GeoffreyBultot/MotorTestBench-PBE/CAO/Rendering/PhotosAssemblageBoitier/BoitierAvecComposants/10_CompletOrtho2.JPG

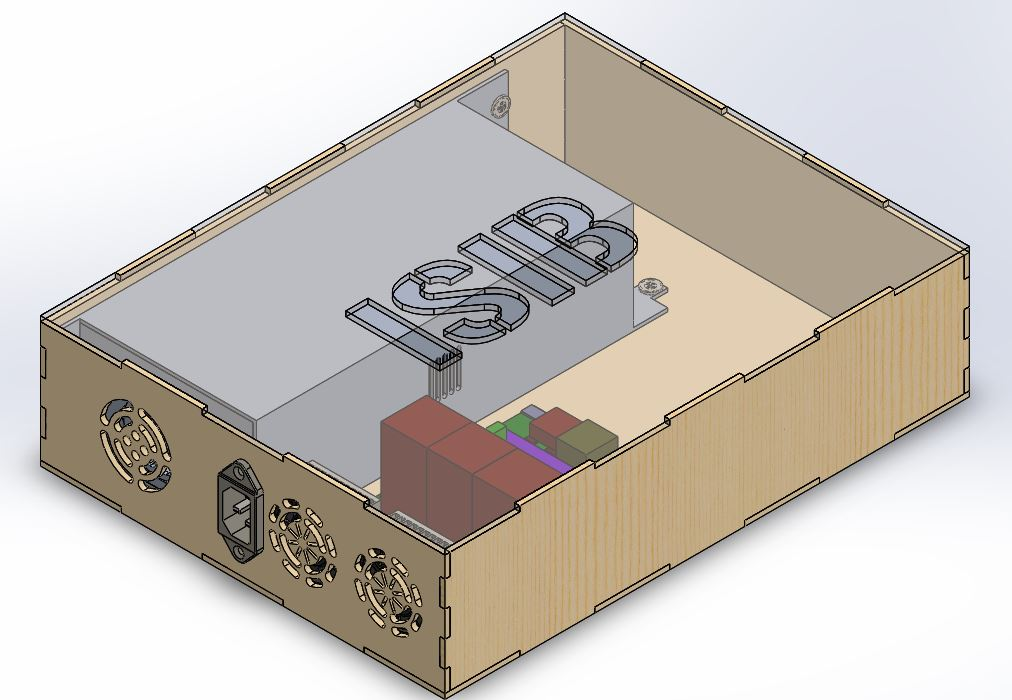
CAO/Rendering/PhotosAssemblageBoitier/BoitierAvecComposants/10_CompletOrtho2.JPG
