GeoffreyBultot/MotorTestBench-PBE/CAO/Rendering/PhotosAssemblageBoitier/BoitierAvecComposants/8_AjoutConnecteur230V.JPG

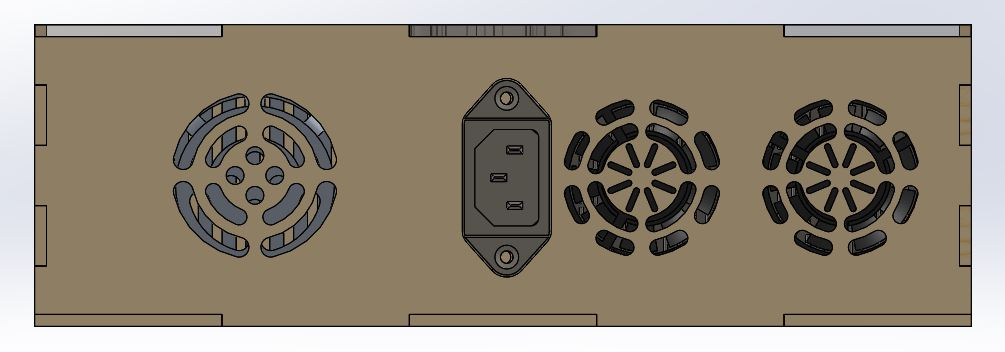
CAO/Rendering/PhotosAssemblageBoitier/BoitierAvecComposants/8_AjoutConnecteur230V.JPG
