GeoffreyBultot/MotorTestBench-PBE/Simulations/Multisim/Alimentation_Moteur/cours_hacheur_serie_tgett.pdf

1

## Cours de Physique appliquée

## Conversion Continu Continu :

## Le hacheur série

### Terminale STI Génie Electrotechnique

### © Fabrice Sincère ; Version 1.1.2

2

Sommaire

1- Symbole général du convertisseur DC / DC

2- Principe du hacheur série (abaisseur de tension)

3- Application : commande de la vitesse d’un moteur à

courant continu à excitation indépendante

4- Ondulation du courant

3

1- Symbole général du convertisseur DC / DC

## continu continu Fig. 1

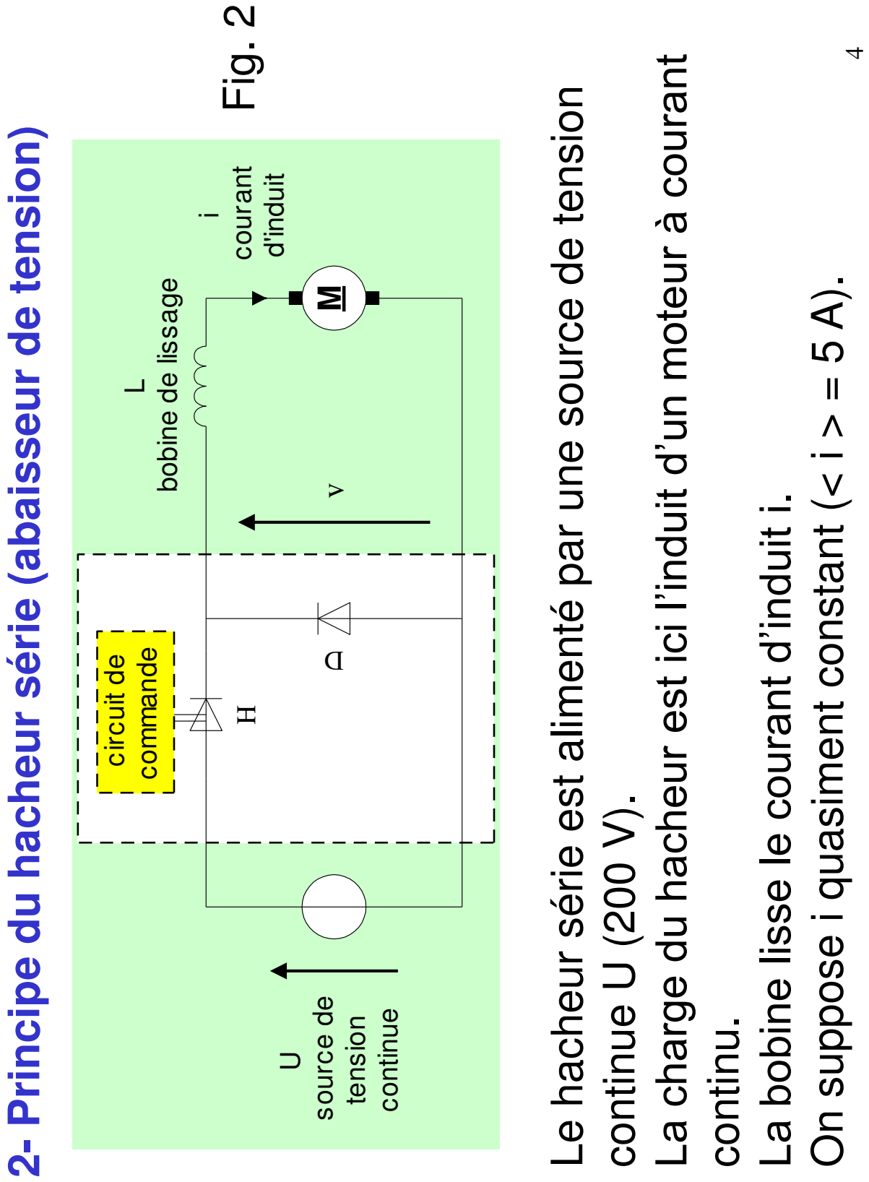
[picture p3: figure]
continue U (200 V).; continu.; La bobine lisse le courant d’induit i.; source de tension; continue; bobine de lissage; courant d'induit; circuit de; commande; Fig. 2

2- Principe du hacheur série (abaisseur de tension)

Le hacheur série est alimenté par une source de tension

La charge du hacheur est ici l’induit d’un moteur à courant

On suppose i quasiment constant (< i > = 5 A).

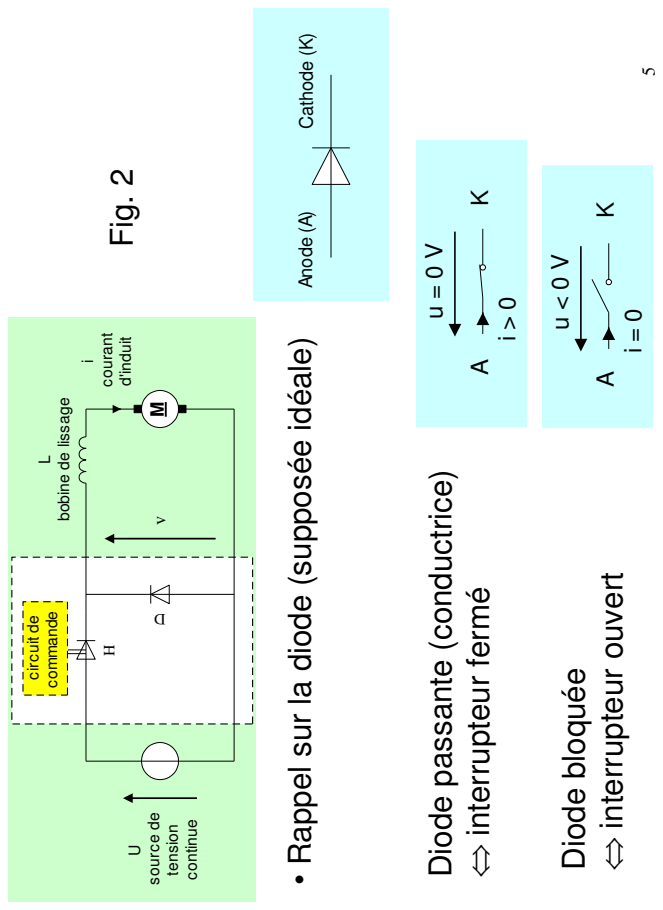
[picture p4: page 5]
source de tension; continue; courant d'induit; circuit de; commande; Fig. 2;  interrupteur fermé; Diode bloquée;  interrupteur ouvert; Anode (A) Cathode (K)

• Rappel sur la diode (supposée idéale)

bobine de lissage

Diode passante (conductrice)

6

- H est un interrupteur électronique :

commandable à la fermeture
commandable à l’ouverture
unidirectionnel en courant

En pratique :

- transistors bipolaires (NPN ou PNP), MOSFET
- thyristors GTO ...

Fig. 3
H

circuit de

commande

circuit de

commande

transistor
NPN

base

collecteur émetteur Fig. 4

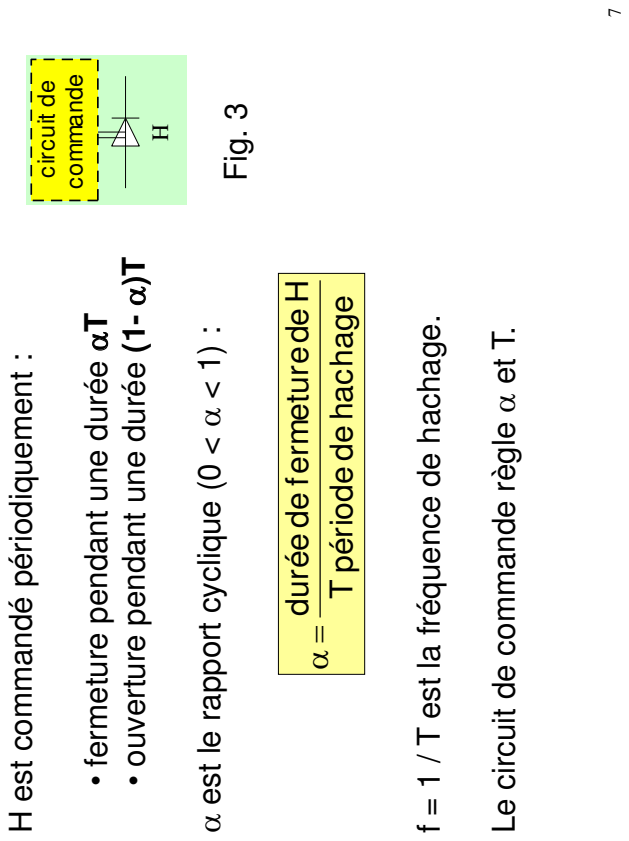
[picture p5: page 7]
circuit de; commande; Fig. 3

• ouverture pendant une durée (1- )T

H de fermeture de durée

hachage de période T

• fermeture pendant une durée T

f = 1 / T est la fréquence de hachage.

 est le rapport cyclique (0 <  < 1) :

Le circuit de commande règle  et T.

H est commandé périodiquement :

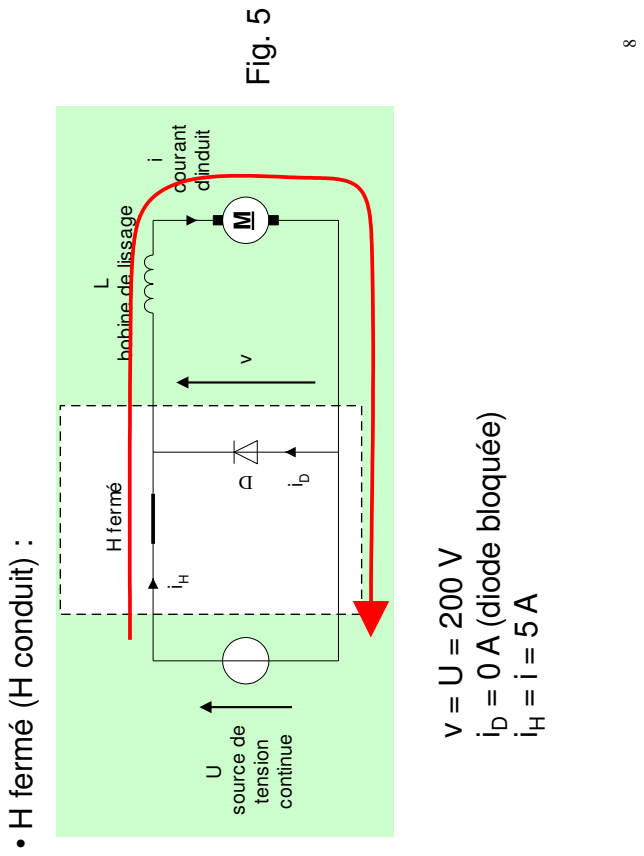
[picture p6: page 8]
• H fermé (H conduit) :; source de tension; continue; courant d'induit; H fermé; Fig. 5 v

bobine de lissage

iD = 0 A (diode bloquée)

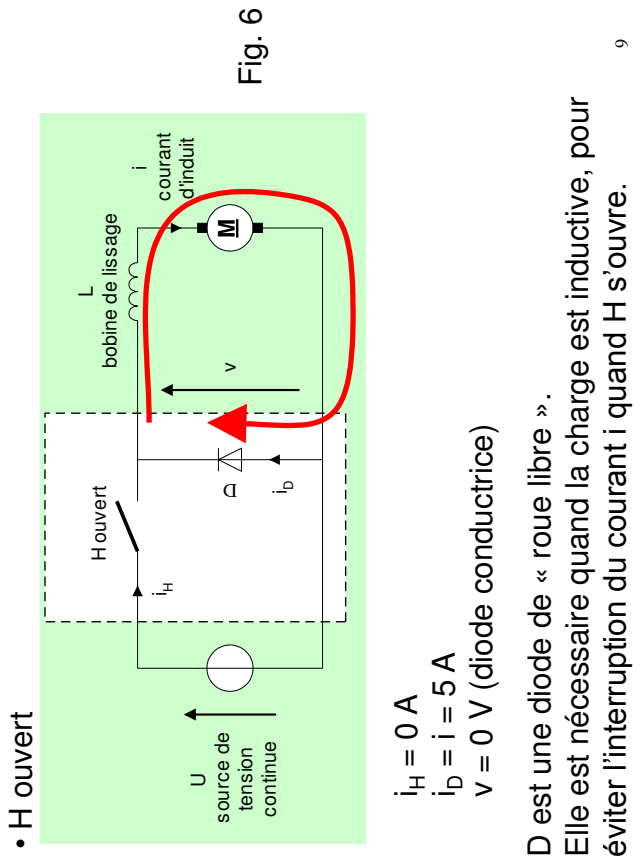
[picture p7: page 9]
• H ouvert; source de tension; continue; courant d'induit; H ouvert; Fig. 6; v = 0 V (diode conductrice)

Elle est nécessaire quand la charge est inductive, pour

éviter l’interruption du courant i quand H s’ouvre.

bobine de lissage

D est une diode de « roue libre ».

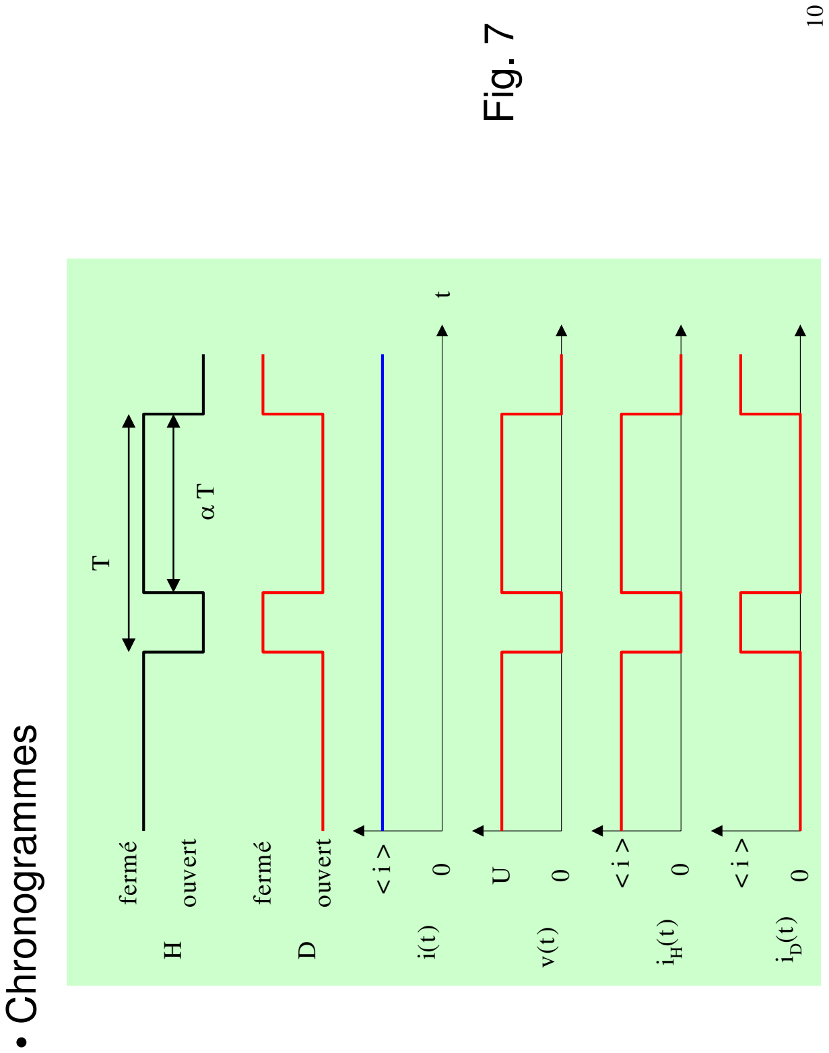
[picture p8: figure]
• Chronogrammes; fermé; ouvert; Fig. 7

11

- Valeurs moyennes

< v > ?

Méthode des aires :
< v > = U

A.N. < v > = 0,75 200 = 150 V

T

UT

T

Aire

v

A.N. Mesurer le rapport cyclique.

= 0,75

12

< iH > = < i >

< iD > = (1 - ) < i >

A.N. < iH > = 0,75 5 = 3,75 A

A.N. < iD > = (1 - 0,75) 5 = 1,25 A

Remarque :

Loi des nœuds : i(t) = iH(t) + iD(t)

< i > = < iH > + < iD >

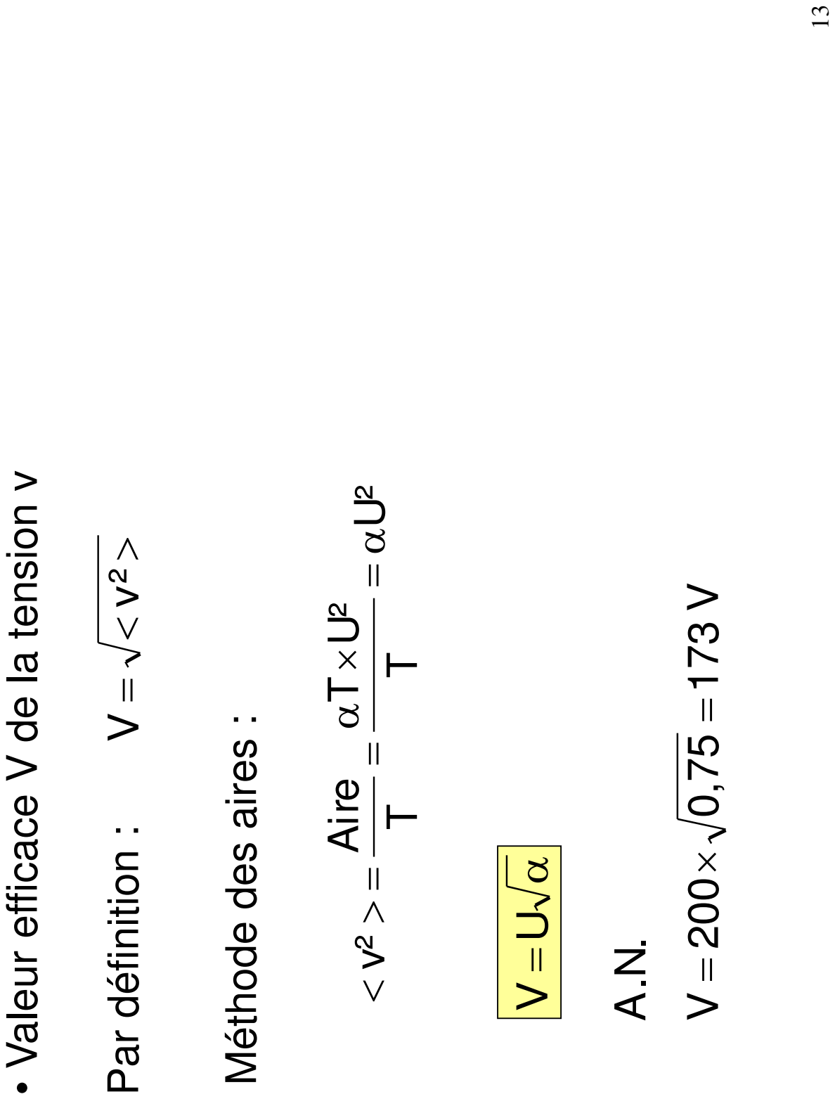
[picture p9: figure]
• Valeur efficace V de la tension v; Par définition :;  v²V; Méthode des aires :; U²T; Aire v²   

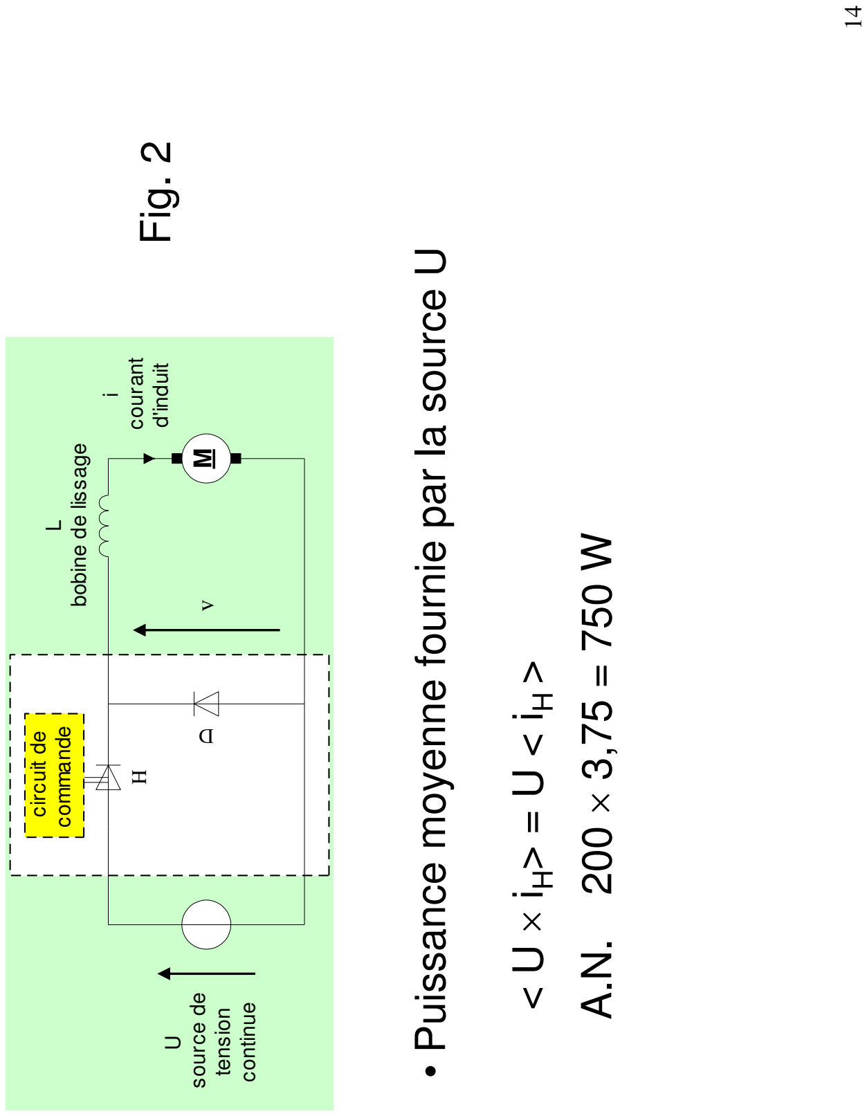
[picture p10: figure]
source de tension; continue; bobine de lissage; courant d'induit; circuit de; commande; Fig. 2

- Puissance moyenne fournie par la source U

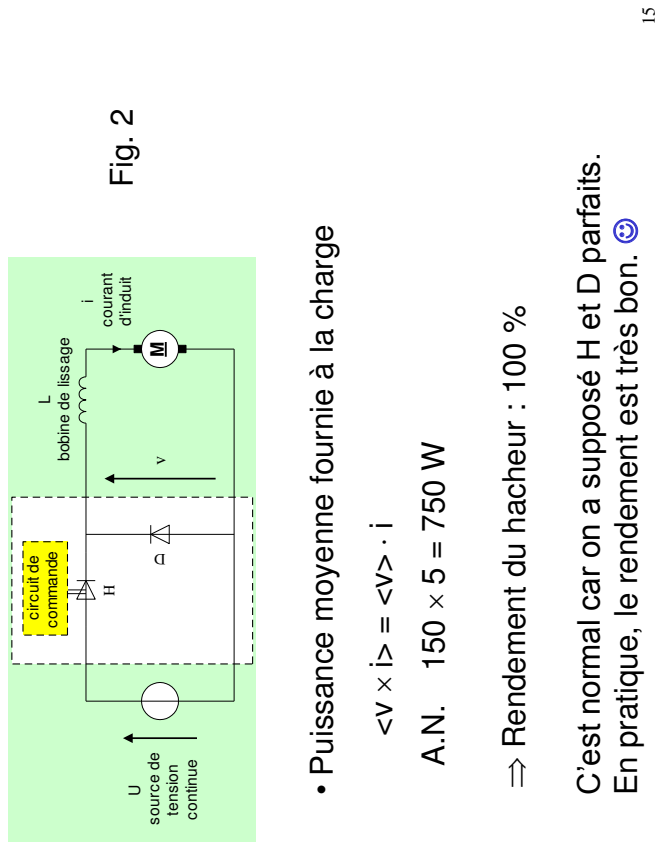
[picture p11: page 15]
source de tension; continue; courant d'induit; circuit de; commande; Fig. 2

C’est normal car on a supposé H et D parfaits.

En pratique, le rendement est très bon. 

• Puissance moyenne fournie à la charge

 Rendement du hacheur : 100 %

bobine de lissage

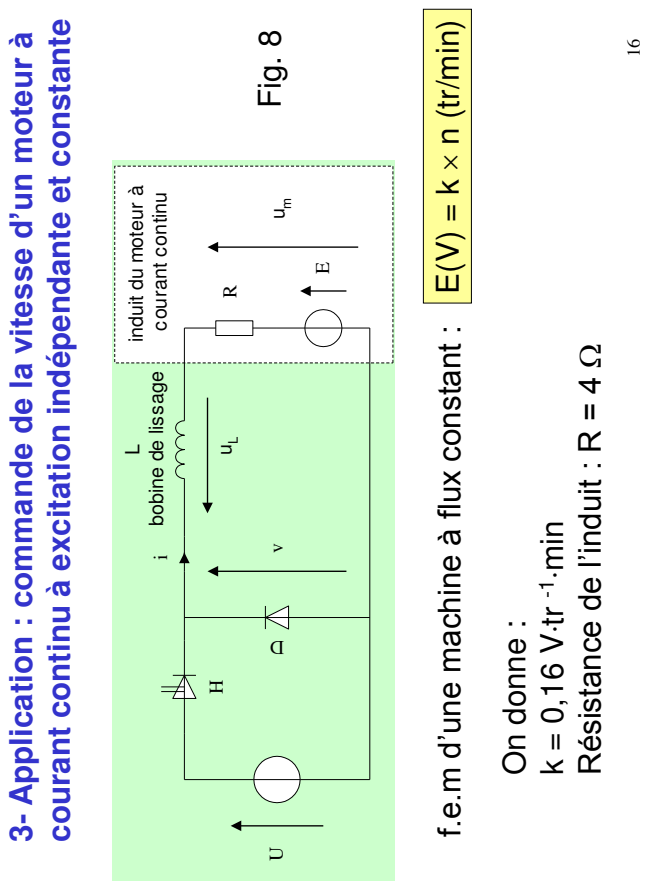
[picture p12: page 16]
courant continu; On donne :; k = 0,16 Vtr -1min; Fig. 8

courant continu à excitation indépendante et constante

f.e.m d’une machine à flux constant : E(V) = k  n (tr/min)

3- Application : commande de la vitesse d’un moteur à

induit du moteur à

Résistance de l’induit : R = 4 

bobine de lissage i

17

La tension moyenne aux bornes d’une bobine pure
parcourue par un courant périodique est nulle :

< um> = < v > = U

(t)u(t)uv(t) mL

mL u u v

A.N. = 0,75

< um> = 0,75 200 = 150 V

## V0 di

dt

L uL

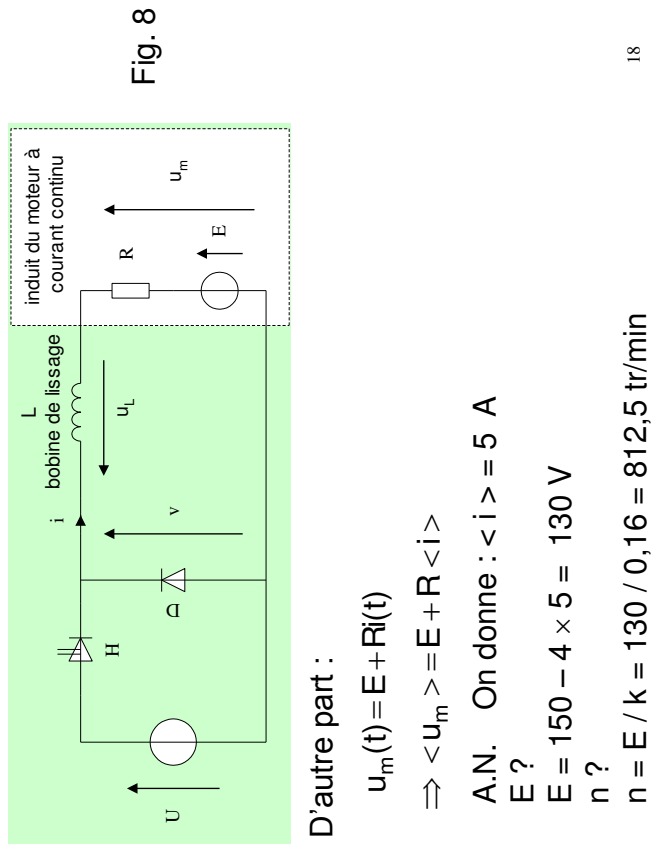
[picture p13: page 18]
A.N. On donne : < i > = 5 A; n = E / k = 130 / 0,16 = 812,5 tr/min; courant continu; uL Fig. 8; D’autre part :

induit du moteur à

bobine de lissage i

19

A.N. Le rapport cyclique est maintenant = 0,5.

Calculer <um>.

En déduire E puis n.

On donne : < i > = 5 A (couple résistant supposé constant)

<um> = U = 0,5 200 = 100 V

E = 100 – 4 5 = 80 V

n ?

n = E / k = 80 / 0,16 = 500 tr/min

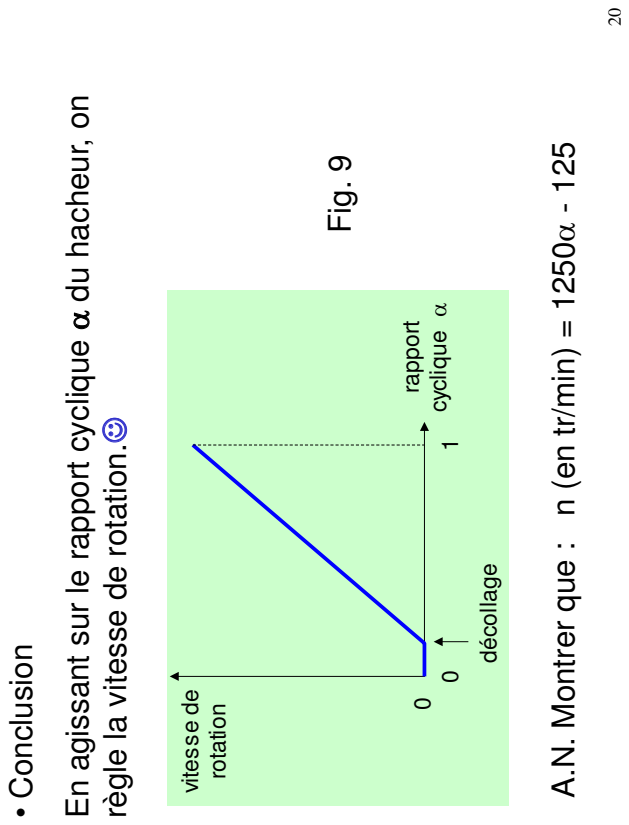
[picture p14: page 20]
• Conclusion; Fig. 9; rapport; cyclique ; vitesse de rotation; décollage

En agissant sur le rapport cyclique  du hacheur, on

A.N. Montrer que : n (en tr/min) = 1250 - 125

règle la vitesse de rotation.

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

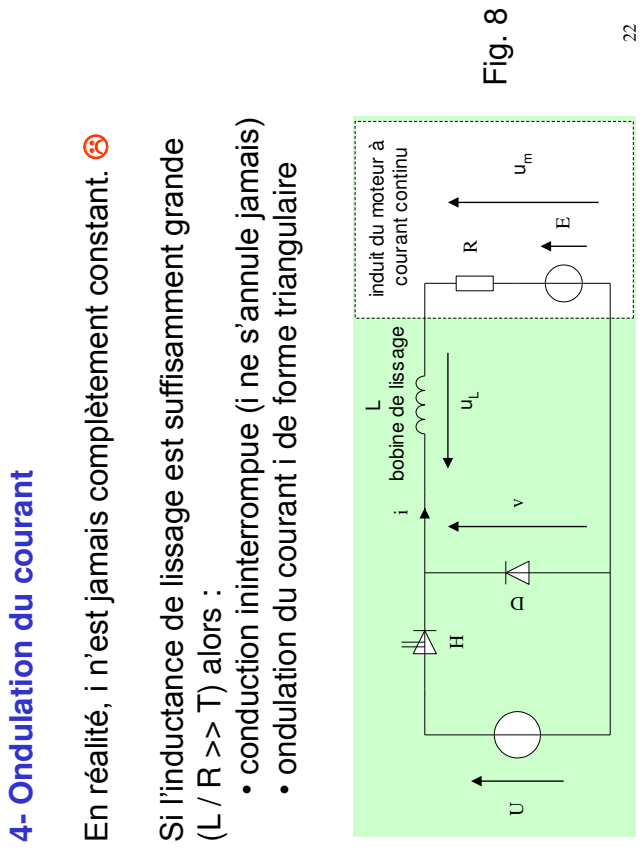
[picture p15: page 22]
(L / R >> T) alors :; courant continu; Fig. 8

• conduction ininterrompue (i ne s’annule jamais)

En réalité, i n’est jamais complètement constant. 

Si l’inductance de lissage est suffisamment grande

induit du moteur à

• ondulation du courant i de forme triangulaire

bobine de lissage i

4- Ondulation du courant

23

- Oscillogrammes

Voie 1 : v(t)

Voie 2 : on utilise une pince ampèremétrique de sensibilité

100 mV/A pour visualiser le courant i(t).

Fig. 10

24

A.N.

Fréquence de hachage ?

Rapport cyclique ?

< v > ?

i max ?
i min ?

Ondulation i ?

< i > ?

ii Δi

ˆ

2

## ii i

T = 1 ms

f = 1 kHz
= 0,4

< v > = 0,4 200 = 80 V

i max = 6 A
i min = 4 A

i = 2 A

< i > = 5 A
Pour un signal triangulaire :

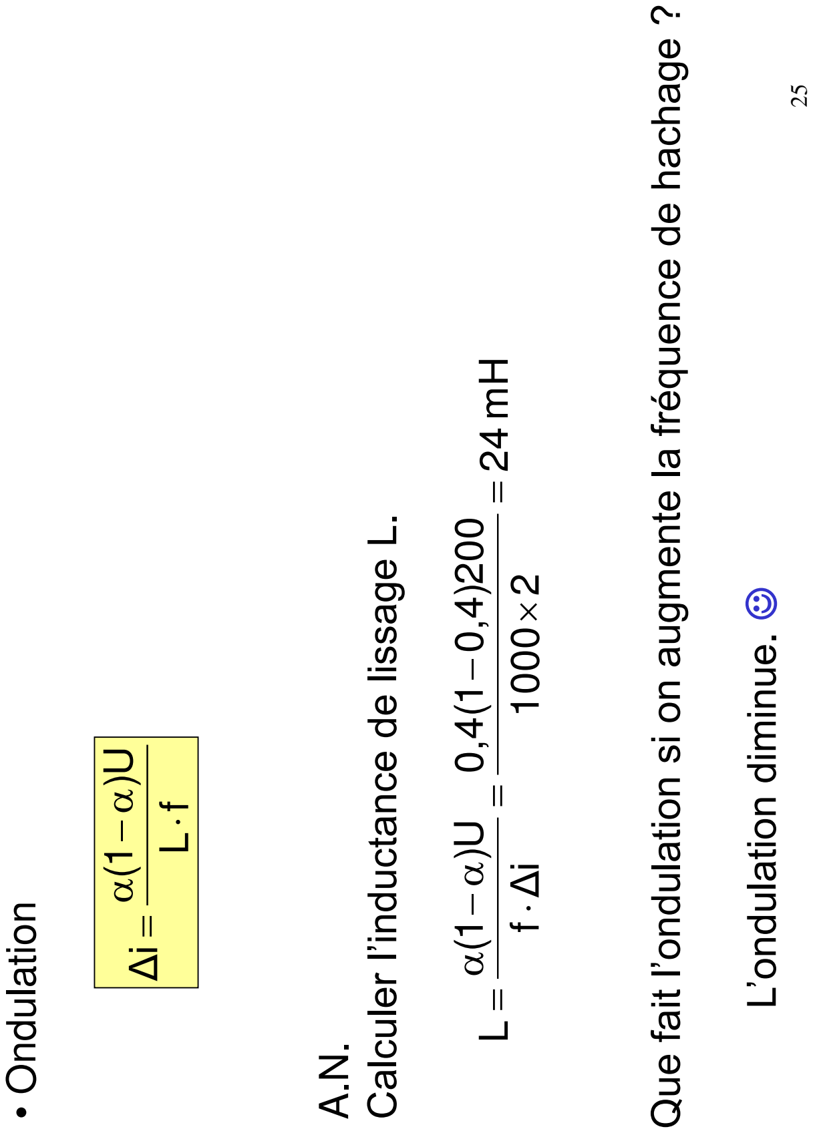
[picture p16: figure]
Calculer l’inductance de lissage L.; L’ondulation diminue. ; • Ondulation

Que fait l’ondulation si on augmente la fréquence de hachage ?

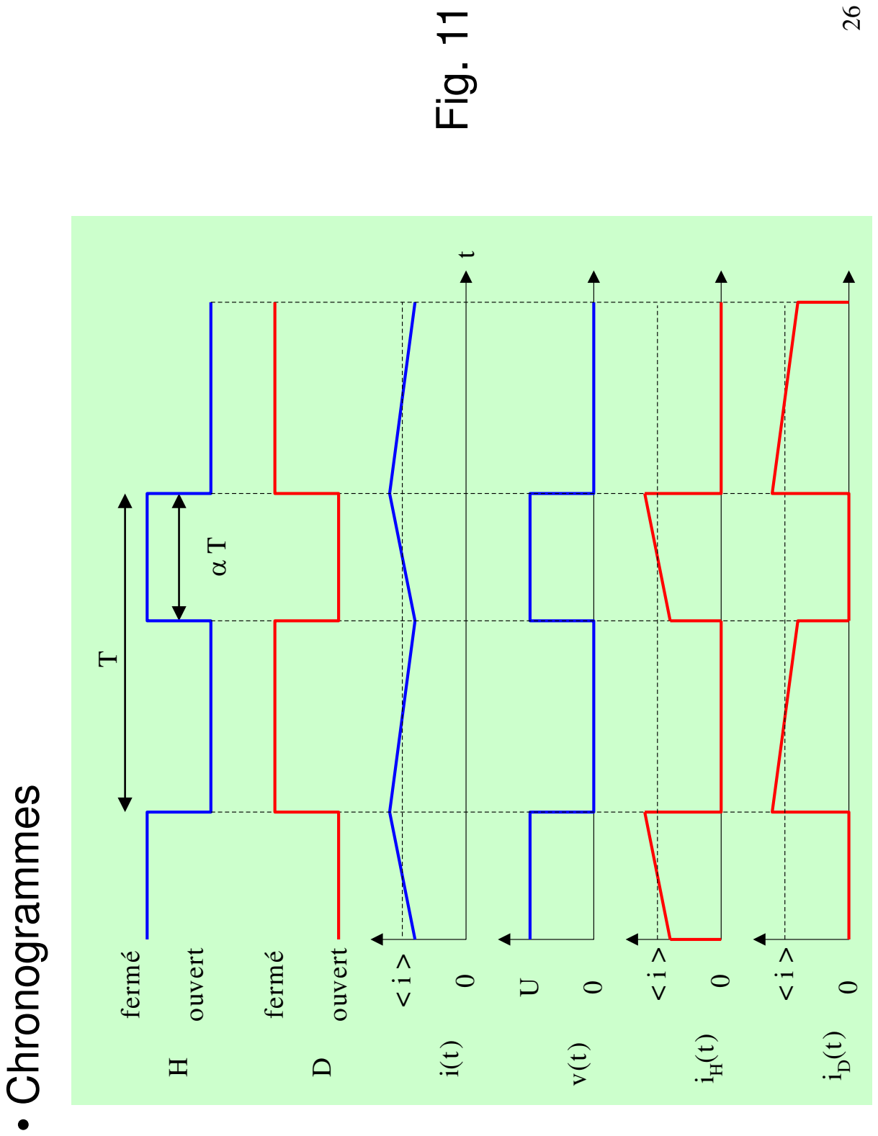
[picture p17: figure]
• Chronogrammes; Fig. 11; fermé; ouvert

27

A.N.

< iH > = ?
< iD > = ?

< iH > = < i >

< iD > = (1- ) < i >

A.N. 0,4 5 = 2 A

A.N. (1 - 0,4) 5 = 3 A
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
