GeoffreyBultot/MotorTestBench-PBE/CAO/Rendering/1_BancEssaiBase.JPG

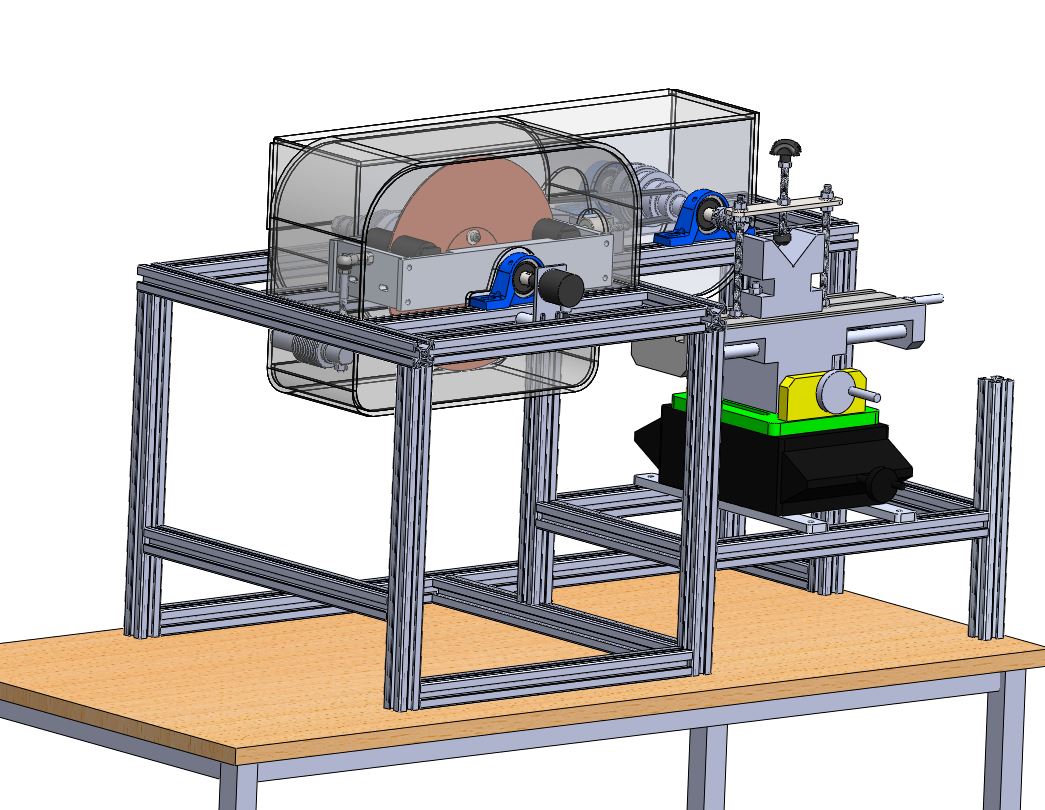
CAO/Rendering/1_BancEssaiBase.JPG
