GeoffreyBultot/MotorTestBench-PBE/CAO/Rendering/2_BancEssaiBase.JPG

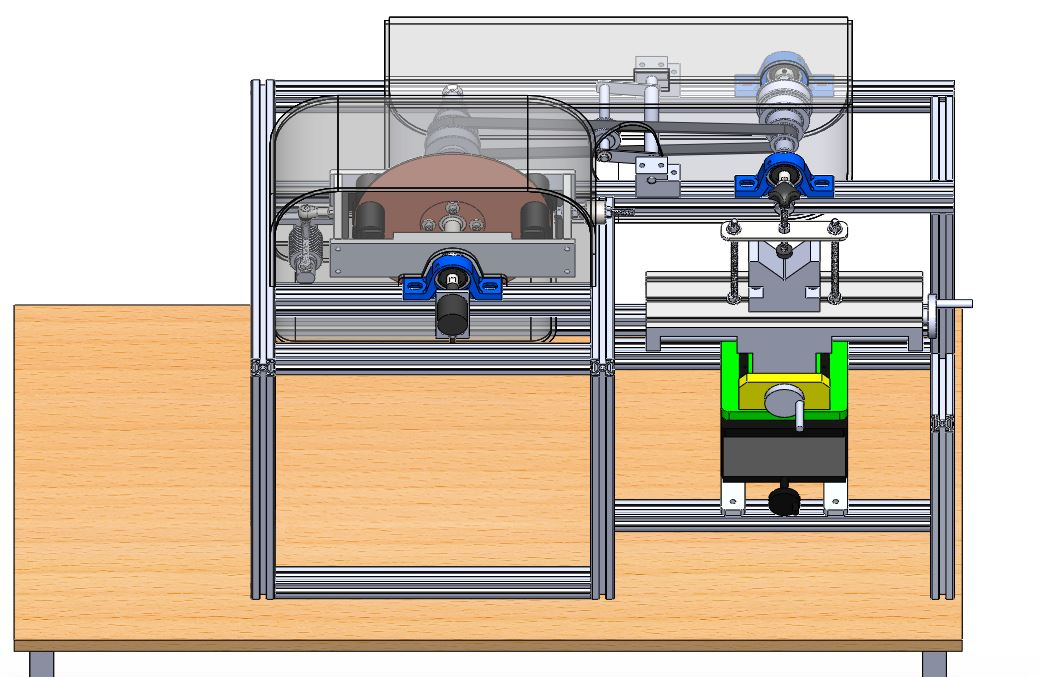
CAO/Rendering/2_BancEssaiBase.JPG
