GeoffreyBultot/MotorTestBench-PBE/CAO/Rendering/3_AjoutEcran.JPG

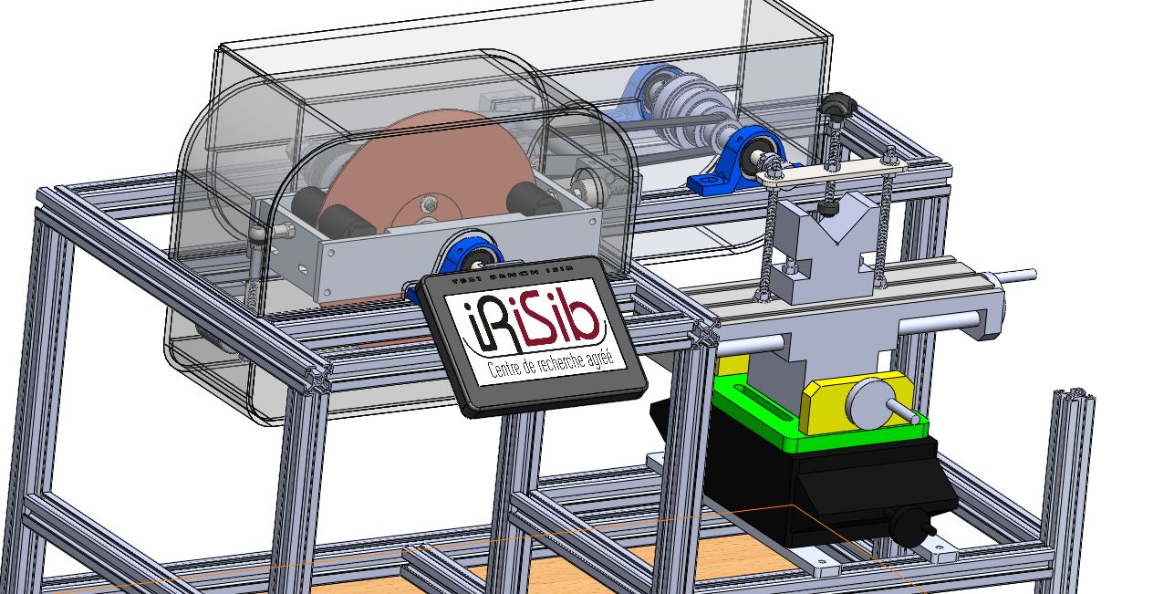
CAO/Rendering/3_AjoutEcran.JPG
