GeoffreyBultot/MotorTestBench-PBE/CAO/Rendering/4_AjoutEcran.JPG

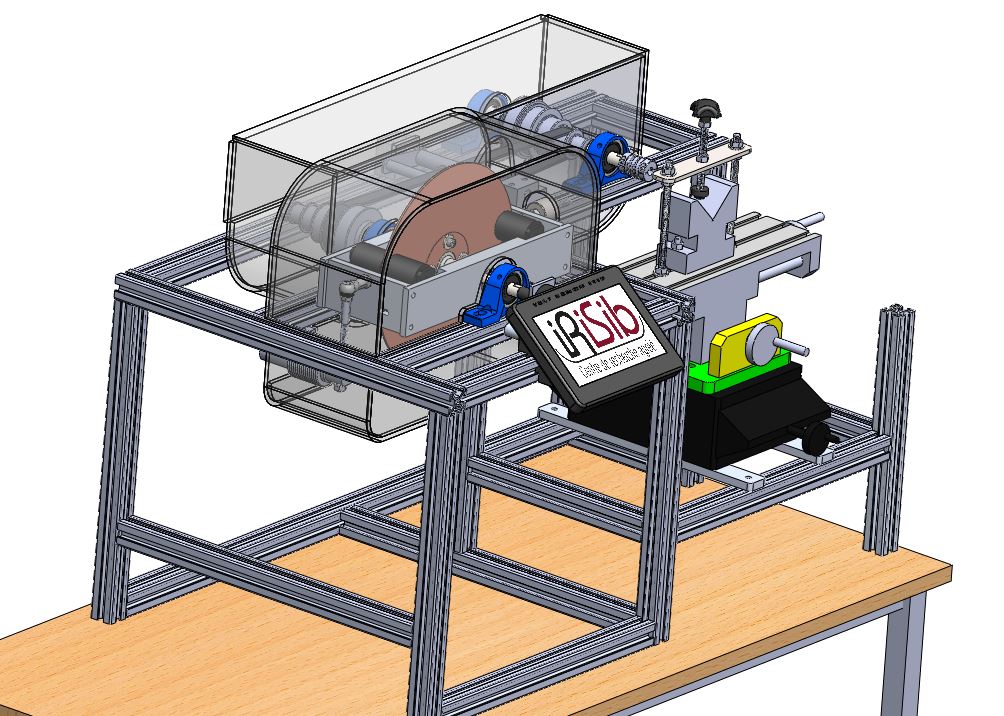
CAO/Rendering/4_AjoutEcran.JPG
