GeoffreyBultot/MotorTestBench-PBE/CAO/Rendering/5_AjoutBoitier.JPG

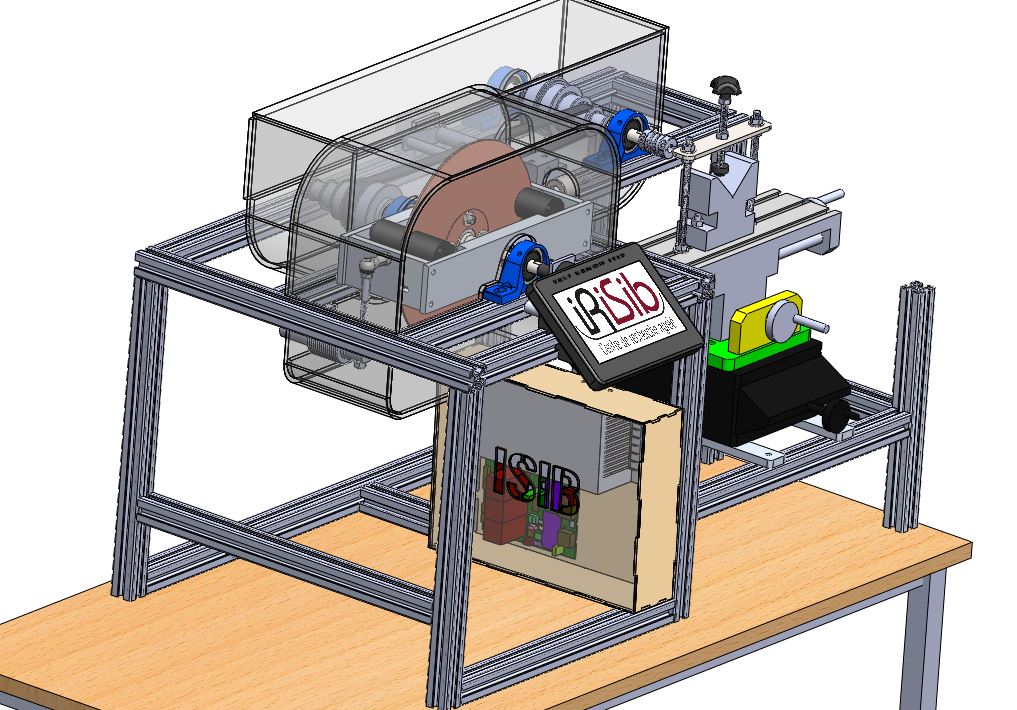
CAO/Rendering/5_AjoutBoitier.JPG
