GeoffreyBultot/MotorTestBench-PBE/CAO/Rendering/6_AjoutBoitier.JPG

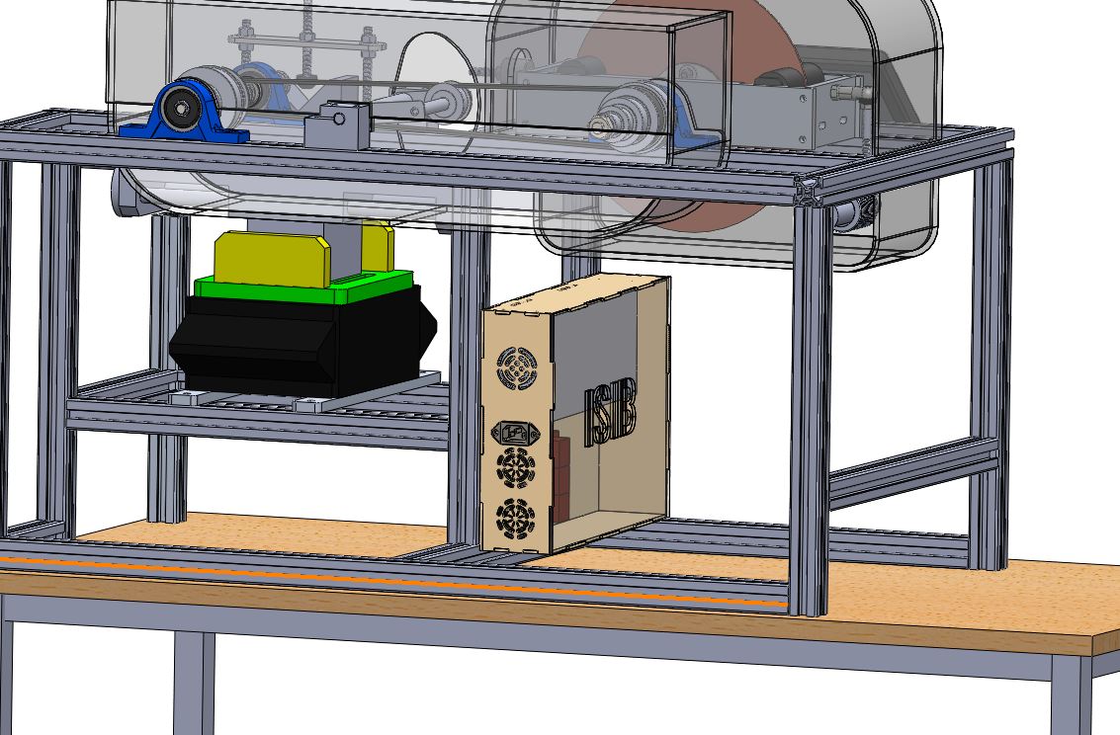
CAO/Rendering/6_AjoutBoitier.JPG
