GeoffreyBultot/MotorTestBench-PBE/CAO/Rendering/7_Final1.JPG

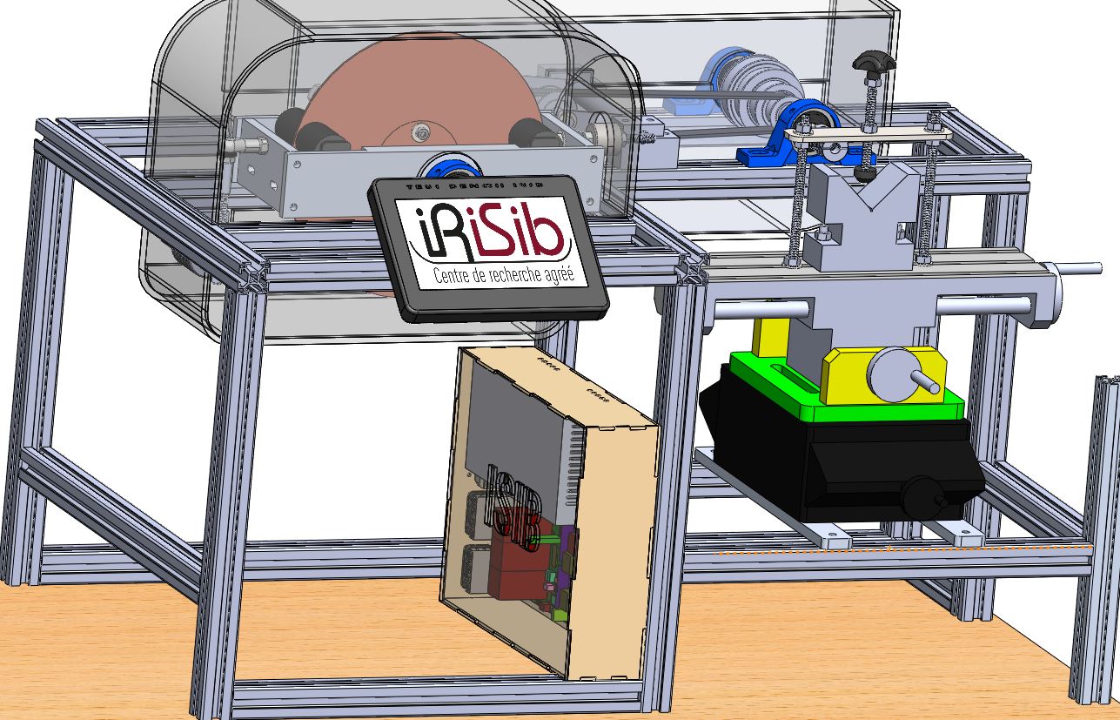
CAO/Rendering/7_Final1.JPG
