GeoffreyBultot/MotorTestBench-PBE/CAO/Rendering/8_Final2.JPG

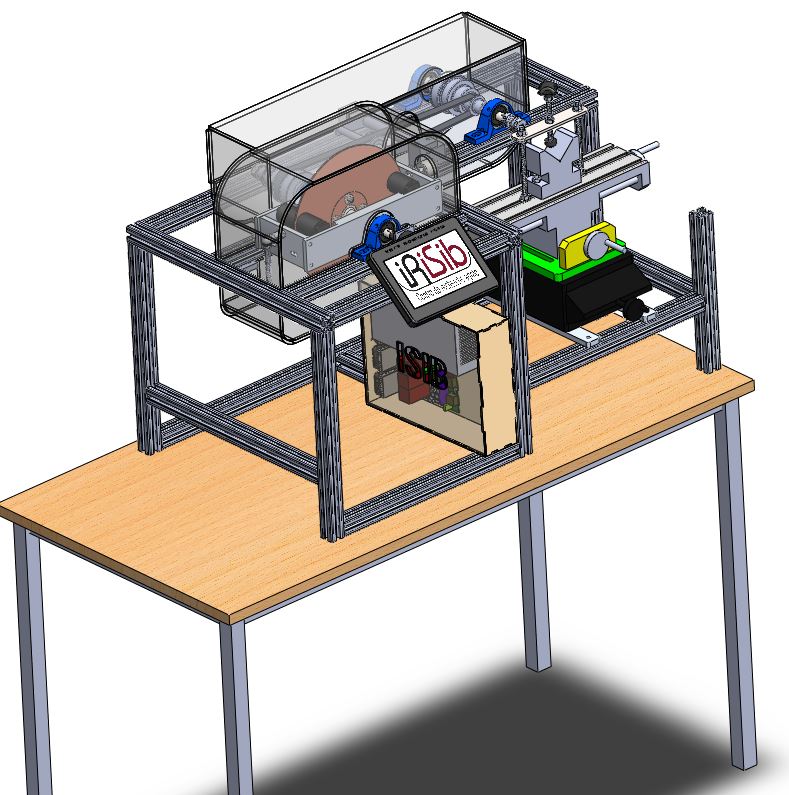
CAO/Rendering/8_Final2.JPG
