GeoffreyBultot/MotorTestBench-PBE/Schemas/AOP_MesuresUI.png

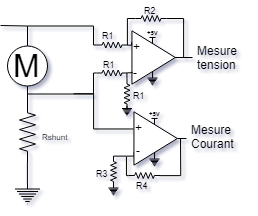
Schemas/AOP_MesuresUI.png
