GeoffreyBultot/MotorTestBench-PBE/Simulations/Multisim/Alimentation_Moteur/Modifs_Alim_Decoupage_BA1.png

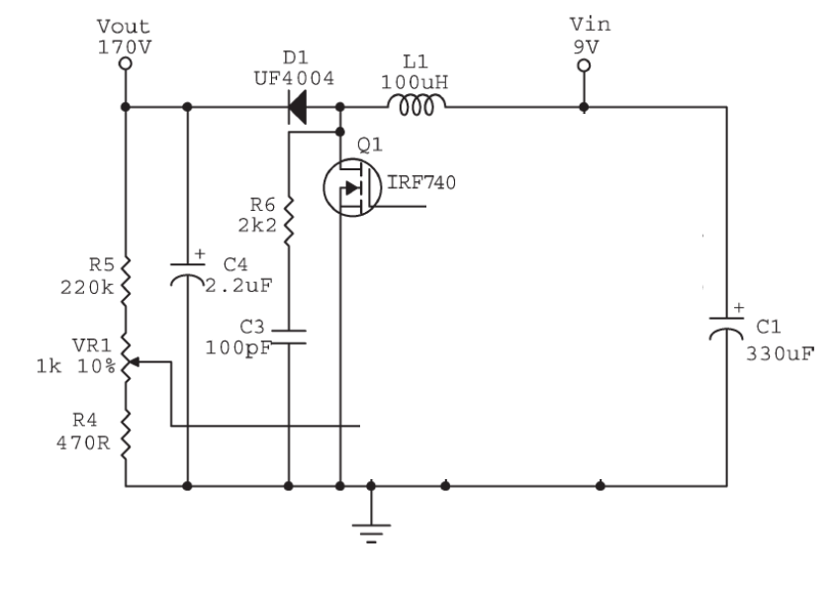
Simulations/Multisim/Alimentation_Moteur/Modifs_Alim_Decoupage_BA1.png
