GeoffreyBultot/MotorTestBench-PBE/Simulations/Multisim/Microcontroleur/CFGULINK.PNG

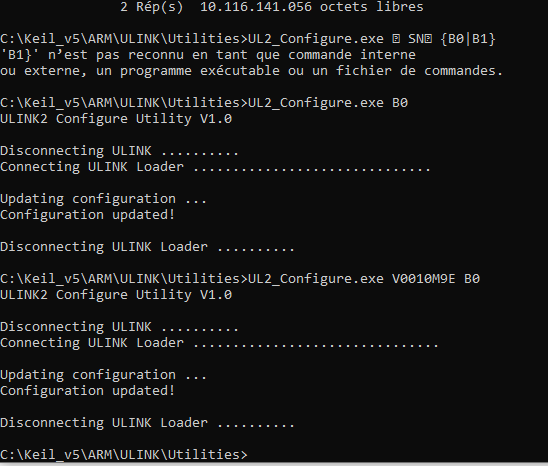
Simulations/Multisim/Microcontroleur/CFGULINK.PNG
