GeoffreyBultot/MotorTestBench-PBE/Prix_Proto.xlsx

Sheet: Sheet1
Composant | Description | Vendeur | Référence | €/unit | unit | €total | TVAC | TOTAL = 178,408
Pont redresseur | DF01M, 100 V, 1.5 A, DIP, 1.1 V | Farnell | 1467464 | 0.444 | 1 | 0.444 | 0
Pont redresseur | GBU604 C2 - Single Phase, 400 V, 6 A, SIP, 1 V, 4 Pins | Farnell | 4084837 | 1.23 | 1 | 1.23 | 0
Regulateur 12V | LM338T 35V primary input, 1.2V to 37V / 5A / TO-220-3 | Farnell | 1469094 | 1.52 | 1 | 1.52 | 0
Regulateur 5V | LM317BT - 1.2 V to 37 V/1.5 A Out, TO-220-3 | Farnell | 2806950 | 0.6 | 3 | 1.8 | 0
Regulateur 3V3 | LM1117IMPX-3.3, 1.2V Dropout, 3.3V / 800mA out, SOT-223-4 | Farnell | 3007498 | 0.967 | 2 | 1.934 | 0
AOP TLC2262 | 2 Amplifier 185 kHz, DIP, 8 Pins | Farnell | 3005158 | 1.79 | 1 | 1.79 | 0
AOP INSTRU | AD623ANZ, 1 Amplifier, ± 2.5V to ± 6V, DIP | Farnell | 9603700 | 6.14 | 1 | 6.14 | 0
Quartz | AB38T-32.768KHZ - Crystal, 32,768 kHz, Cylinder Radial, 12.5 pF, 20 ppm | Farnell | 1611828 | 0.2 | 2 | 0.4 | 0
STM32F103C8T6 | ARM MCU, Motor Control, STM32 Family STM32F1 Series | Mouser | 511-STM32F103C8T6 | 5.17 | 2 | 10.34 | 21
Quartz | Crystal, 8 MHz, Through Hole, 50 ppm, 20 pF, 30 ppm | Mouser | 559-FOXS080-20-LF | 0.31 | 2 | 0.62 | 21
Diode | MBRF10200CT - Schottky 200 V, 10 A, Dual Common C, 980 mV | Mouser | 576-MBRF10200CT | 1.41 | 4 | 5.64 | 21
Self | SC-10-30J - Common Mode, AC, 3 Mh | Mouser | 80-SC-10-30J | 5.95 | 2 | 11.9 | 21
Capa | SLPX102M200C4P3 - Electrolytic, 1000 µF, 200 V , ± 20% | Mouser | 598-SLPX102M200C4P3 | 3.47 | 3 | 10.41 | 21
MOSFET | STP26NM60N - N Channel, 10 A, 600 V, 0.135 ohm, 10 V, 3 V | Mouser | 511-STP26NM60N | 3.98 | 4 | 15.92 | 21
Optocoupleur | 6N135 - 1 Channel, DIP, 8 Pins, 25 mA, 5.3 kV, 7% | Mouser | 782-6N135 | 1.32 | 2 | 2.64 | 21
Resistance | LVR05R0500FE73 - Current Sense Resistor, 0.05 ohm, 5 W,± 1% | Mouser | 71-LVR05R0500FE73 | 2.19 | 2 | 4.38 | 21
AOP TLC2264 | TLC2264CN - 4 Amplifier, 710 kHz, DIP, 14 Pins | Mouser | 595-TLC2264CN | 2.22 | 2 | 4.44 | 21
Transformateur 15V | 15V ac 1 Output PCB Transformer, 10VA | RS | 732-0433 | 6.97 | 1 | 6.97 | 0 | 14.49 | 16.88 | 2.39
Transformateur 6V | Transformateur, Vout 6V c.a., 25VA | RS | 732-0550 | 7.52 | 1 | 7.52 | 0
AL12 |  |  |  |  |  | 8.44
AL5 |  |  |  |  |  | 8.44
AL130 |  |  |  |  |  | 65.49

Sheet: Sheet2
Composant | Description | Vendeur | Référence | €/unit | unit | €total | TVAC | TOTAL = 169,495
Regulateur 12V | LM338T 35V primary input, 1.2V to 37V / 5A / TO-220-3 | Farnell | 1469094 | 1.52 | 1 | 0.444 | 0
Regulateur 3V3 | LM1117IMPX-3.3, 1.2V Dropout, 3.3V / 800mA out, SOT-223-4 | Farnell | 3007498 | 0.967 | 2 | 1.934 | 0
AOP TLC2262 | 2 Amplifier 185 kHz, DIP, 8 Pins | Farnell | 3005158 | 1.79 | 1 | 1.79 | 0
AOP INSTRU | AD623ANZ, 1 Amplifier, ± 2.5V to ± 6V, DIP | Farnell | 9603700 | 6.14 | 1 | 6.14 | 0
Quartz | AB38T-32.768KHZ - Crystal, 32,768 kHz, Cylinder Radial, 12.5 pF, 20 ppm | Farnell | 1611828 | 0.2 | 2 | 0.4 | 0
STM32F103C8T6 | ARM MCU, Motor Control, STM32 Family STM32F1 Series | Mouser | 511-STM32F103C8T6 | 5.17 | 2 | 10.34 | 21
Quartz | Crystal, 8 MHz, Through Hole, 50 ppm, 20 pF, 30 ppm | Mouser | 559-FOXS080-20-LF | 0.31 | 2 | 0.62 | 21
Diode | MBRF10200CT - Schottky 200 V, 10 A, Dual Common C, 980 mV | Mouser | 576-MBRF10200CT | 1.41 | 2 | 2.82 | 21
Self | SC-10-30J - Common Mode, AC, 3 Mh | Mouser | 80-SC-10-30J | 5.95 | 2 | 11.9 | 21
Capa | SLPX102M200C4P3 - Electrolytic, 1000 µF, 200 V , ± 20% | Mouser | 598-SLPX102M200C4P3 | 3.47 | 3 | 10.41 | 21
MOSFET | IXTX32P60P | Mouser |  | 13.28 | 1 | 13.28 | 21
MOSFET | IXTP10P50P | Mouser |  | 4.29 | 1 | 4.29 | 21
BJT | ZTX458STZ | Mouser |  | 0.549 | 3 | 1.647 | 21
Resistance | LVR05R0500FE73 - Current Sense Resistor, 0.05 ohm, 5 W,± 1% | Mouser | 71-LVR05R0500FE73 | 2.19 | 2 | 4.38 | 21
AOP TLC2264 | TLC2264CN - 4 Amplifier, 710 kHz, DIP, 14 Pins | Mouser | 595-TLC2264CN | 2.22 | 1 | 2.22 | 21
AL12 |  |  |  |  |  | 8.44
AL5 |  |  |  |  |  | 8.44
AL130 |  |  |  |  |  | 80
