GeoffreyBultot/MotorTestBench-PBE/Commandes/Commande_Farnell_Mouser_Bultot_Ibryam.xlsx

Commande Farnell:
 | Composant | Description | Etudiant | Référence | €/unit | unit | €total | TVAC | recu | 221.018
 | Pont redresseur | DF01M, 100 V, 1.5 A, DIP, 1.1 V | Bultot G. | 1467464 | 0.444 | 1 | 0.444 | 0
 | Pont redresseur | GBU604 C2 - Single Phase, 400 V, 6 A, SIP, 1 V, 4 Pins | Bultot G. | 4084837 | 1.23 | 1 | 1.23 | 0
 | Regulateur 12V | LM338T 35V primary input, 1.2V to 37V / 5A / TO-220-3 | Bultot G. | 1469094 | 1.52 | 1 | 1.52 | 0
 | Regulateur 5V | LM317BT - 1.2 V to 37 V/1.5 A Out, TO-220-3 | Bultot G. | 2806950 | 0.6 | 3 | 1.8 | 0
 | Regulateur 3V3 | LM1117IMPX-3.3, 1.2V Dropout, 3.3V / 800mA out, SOT-223-4 | Bultot G. | 3007498 | 0.967 | 2 | 1.934 | 0
 | AOP TLC2262 | 2 Amplifier 185 kHz, DIP, 8 Pins | Bultot G. | 3005158 | 1.79 | 1 | 1.79 | 0
 | AOP INSTRU | AD623ANZ, 1 Amplifier, ± 2.5V to ± 6V, DIP | Bultot G. | 9603700 | 6.14 | 1 | 6.14 | 0
 | Haut Parleur | 2231 - Speaker, Full Range, 2 ", 8 W, 8 ohm, 150 Hz to 20000 Hz | Ibryam M. | 1683892 | 12.86 | 16 | 205.76 | 0
 | Quartz | AB38T-32.768KHZ - Crystal, 32,768 kHz, Cylinder Radial, 12.5 pF, 20 ppm | Farnell | 1611828 | 0.2 | 2 | 0.4 | 0
Commande Mouser
 | Composant | Description | Etudiant | Référence | €/unit | unit | €total | TVAC | recu | 66.29
 | STM32F103C8T6 | ARM MCU, Motor Control, STM32 Family STM32F1 Series | Bultot G. | 511-STM32F103C8T6 | 5.17 | 2 | 10.34 | 21
 | Quartz | Crystal, 8 MHz, Through Hole, 50 ppm, 20 pF, 30 ppm | Bultot G. | 559-FOXS080-20-LF | 0.31 | 2 | 0.62 | 21
 | Diode | MBRF10200CT - Schottky 200 V, 10 A, Dual Common C, 980 mV | Bultot G. | 576-MBRF10200CT | 1.41 | 4 | 5.64 | 21
 | Self | SC-10-30J - Common Mode, AC, 3 Mh | Bultot G. | 80-SC-10-30J | 5.95 | 2 | 11.9 | 21
 | Capa | SLPX102M200C4P3 - Electrolytic, 1000 µF, 200 V , ± 20% | Bultot G. | 598-SLPX102M200C4P3 | 3.47 | 3 | 10.41 | 21
 | MOSFET | STP26NM60N - N Channel, 10 A, 600 V, 0.135 ohm, 10 V, 3 V | Bultot G. | 511-STP26NM60N | 3.98 | 4 | 15.92 | 21
 | Optocoupleur | 6N135 - 1 Channel, DIP, 8 Pins, 25 mA, 5.3 kV, 7% | Bultot G. | 782-6N135 | 1.32 | 2 | 2.64 | 21
 | Resistance | LVR05R0500FE73 - Current Sense Resistor, 0.05 ohm, 5 W,± 1% | Bultot G. | 71-LVR05R0500FE73 | 2.19 | 2 | 4.38 | 21
 | AOP TLC2264 | TLC2264CN - 4 Amplifier, 710 kHz, DIP, 14 Pins | Bultot G. | 595-TLC2264CN | 2.22 | 2 | 4.44 | 21
