GeoffreyBultot/MotorTestBench-PBE/CAO/Assemblage1.SLDASM

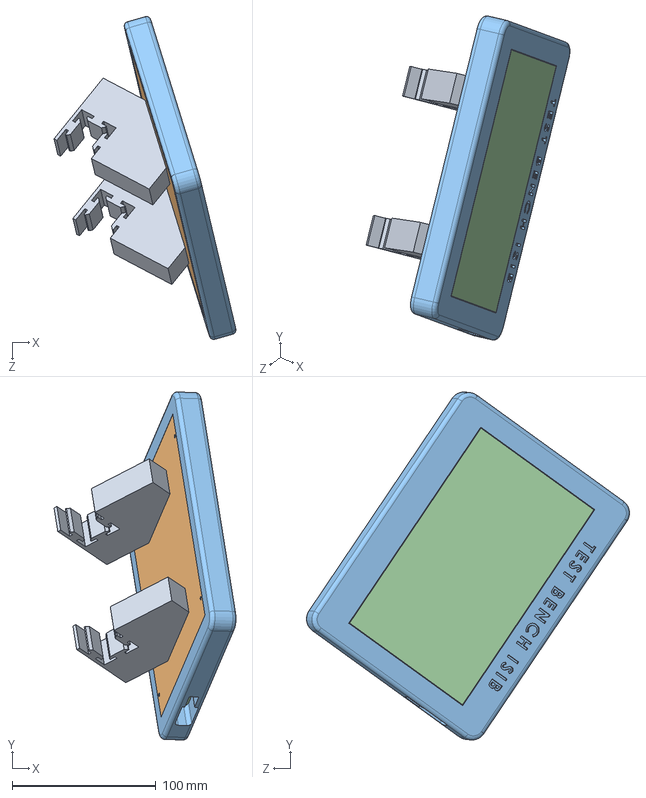
[picture p30: CAD file, 2020-06-09]
CAO/Assemblage1.SLDASM
126.7 x 242.2 x 224.8 mm
AttachePar3_30X30 x 2
PlaqueDos
CacheECRAN
Ecran
