GeoffreyBultot/MotorTestBench-PBE/CAO/AttacheProfile/Assemblage2.SLDASM

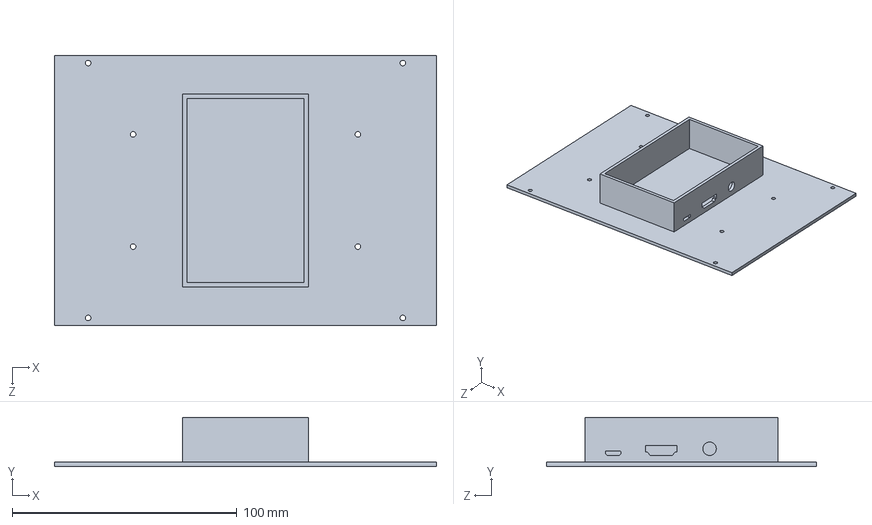
[picture p32: CAD file, 2020-06-09]
CAO/AttacheProfile/Assemblage2.SLDASM
170.0 x 22.0 x 120.0 mm
