GeoffreyBultot/MotorTestBench-PBE/CAO/AttacheProfile/AttachePar3_30X30.SLDPRT

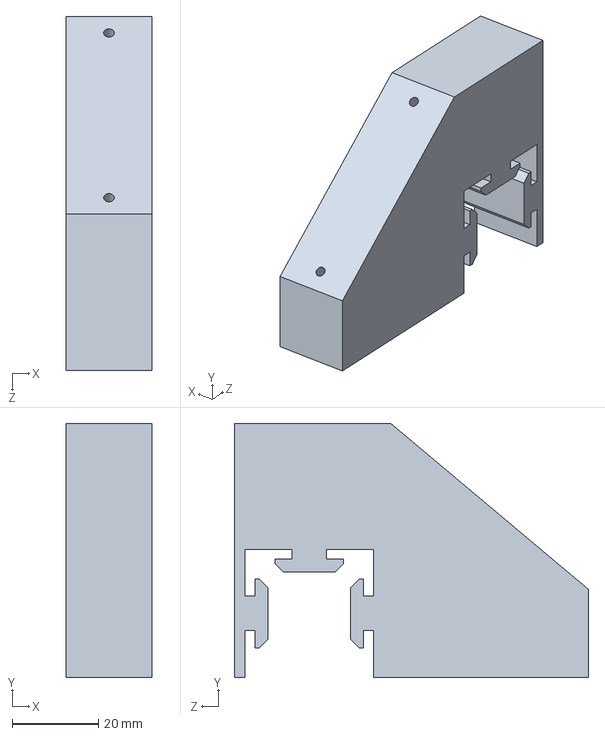
[picture p34: CAD file, 2020-06-09]
CAO/AttacheProfile/AttachePar3_30X30.SLDPRT
20.0 x 59.0 x 82.3 mm
