GeoffreyBultot/MotorTestBench-PBE/CAO/BoitierElectro/Connecteur230V.SLDPRT

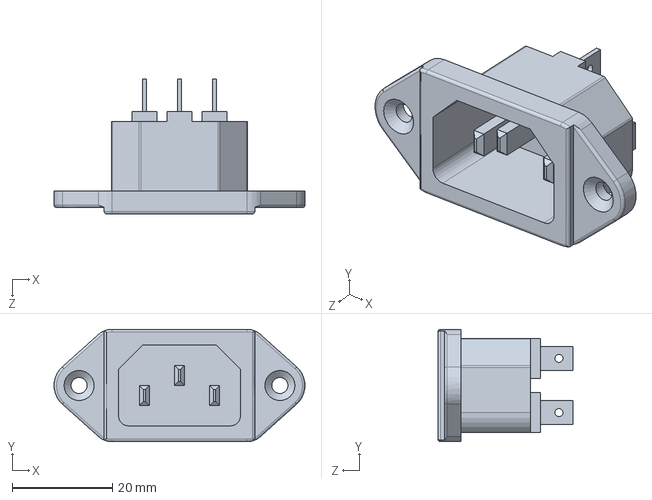
[picture p35: CAD file, 2020-06-09]
CAO/BoitierElectro/Connecteur230V.SLDPRT
50.0 x 22.4 x 26.9 mm
