GeoffreyBultot/MotorTestBench-PBE/CAO/BoitierElectro/Rpi components/Raspberry Pi 312.sldprt

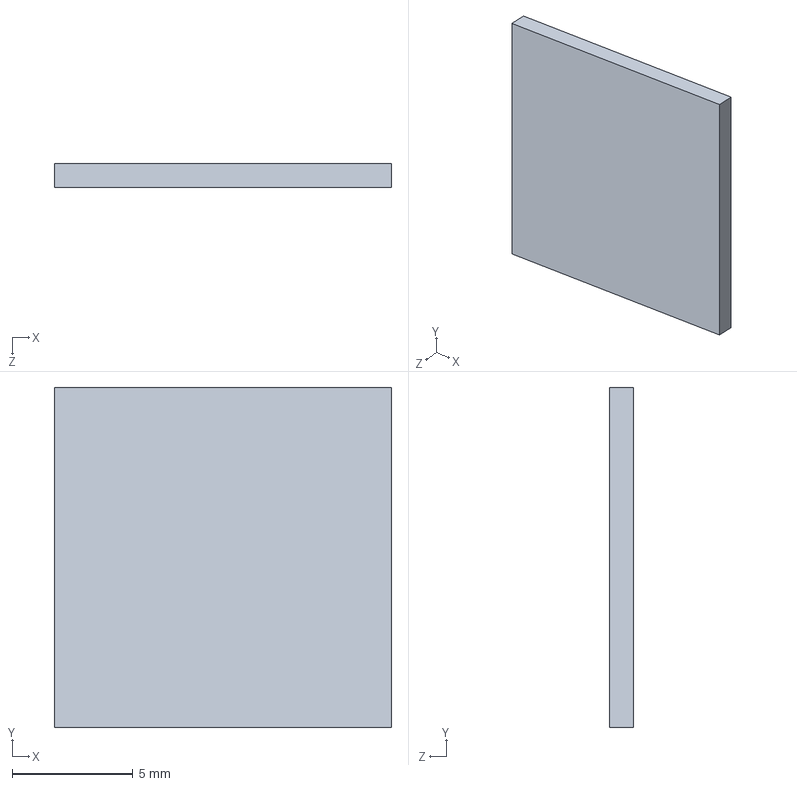
[picture p36: CAD file, 2020-06-09]
CAO/BoitierElectro/Rpi components/Raspberry Pi 312.sldprt
14.0 x 14.1 x 1.00 mm
