GeoffreyBultot/MotorTestBench-PBE/PCB/Motor_TestBenchV2/MotorTestBench/Motor_Test_Bench.dxf

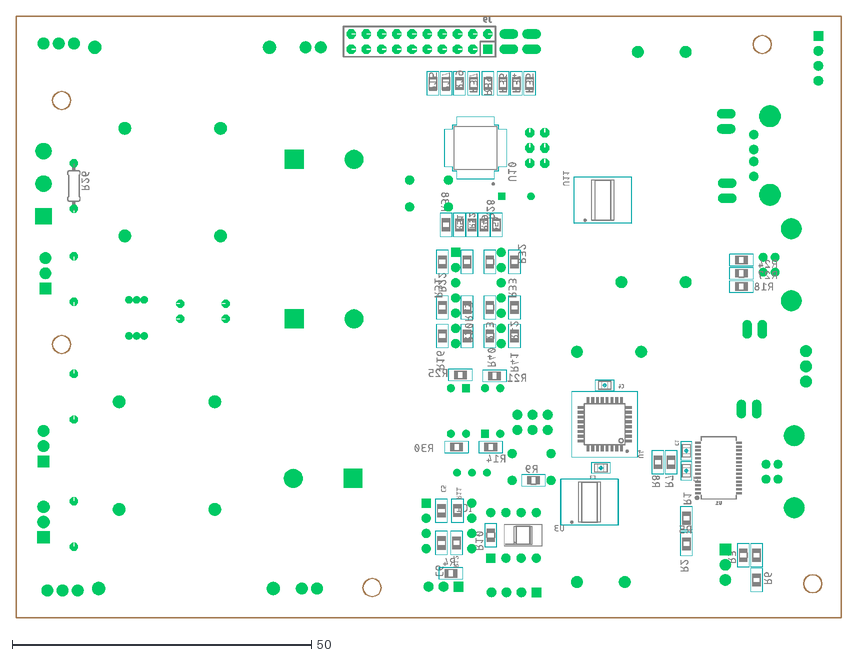
[picture p37: CAD file, 2020-06-06]
PCB/Motor_TestBenchV2/MotorTestBench/Motor_Test_Bench.dxf
137.9 x 100.6
