GeoffreyBultot/MotorTestBench-PBE/CAO/AttacheProfile/PlaqueDos.SLDPRT

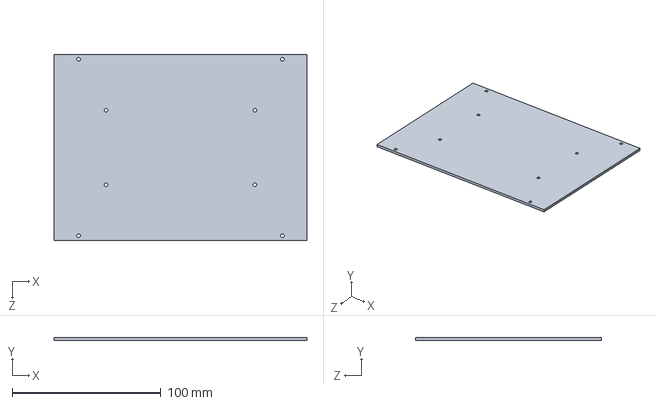
[picture p38: CAD file, 2020-06-09]
CAO/AttacheProfile/PlaqueDos.SLDPRT
170.0 x 2.00 x 125.0 mm
