GeoffreyBultot/MotorTestBench-PBE/CAO/BoitierElectro/Avant.SLDPRT

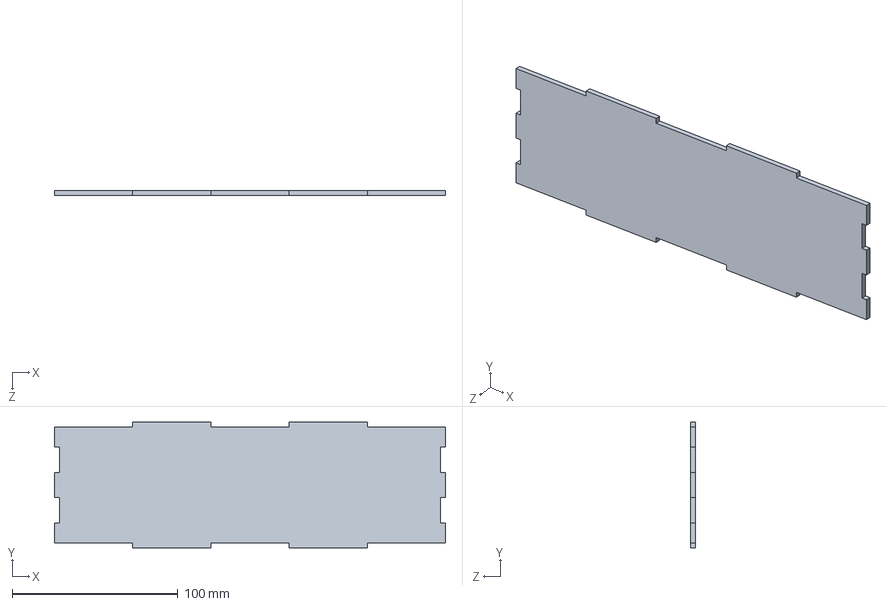
[picture p39: CAD file, 2020-06-09]
CAO/BoitierElectro/Avant.SLDPRT
236.0 x 76.0 x 3.00 mm
