GeoffreyBultot/MotorTestBench-PBE/CAO/BoitierElectro/fan 40mm.SLDPRT

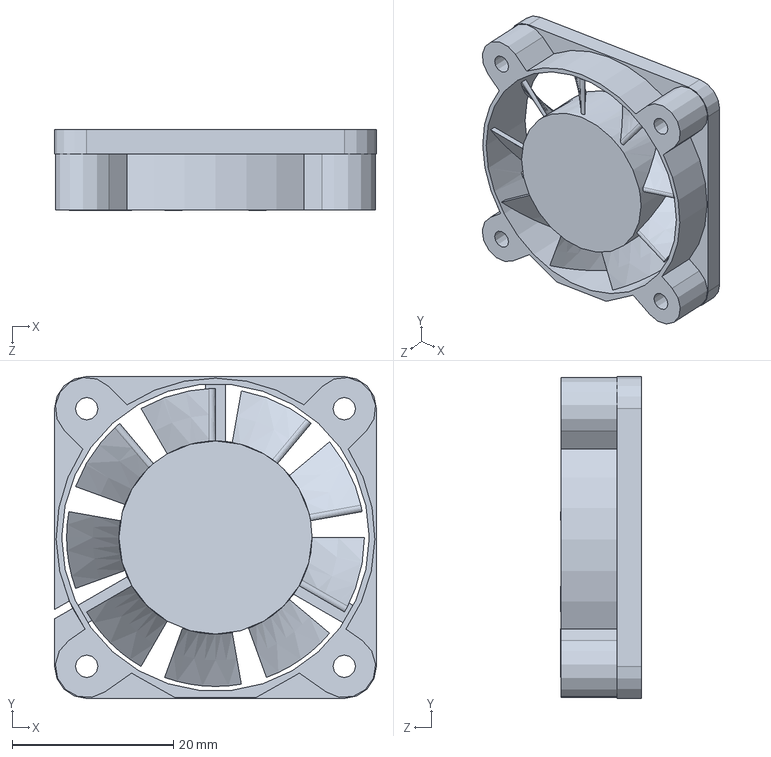
[picture p40: CAD file, 2020-06-09]
CAO/BoitierElectro/fan 40mm.SLDPRT
40.0 x 40.0 x 10.0 mm
