GeoffreyBultot/MotorTestBench-PBE/CAO/AttacheProfile/CacheECRAN.SLDPRT

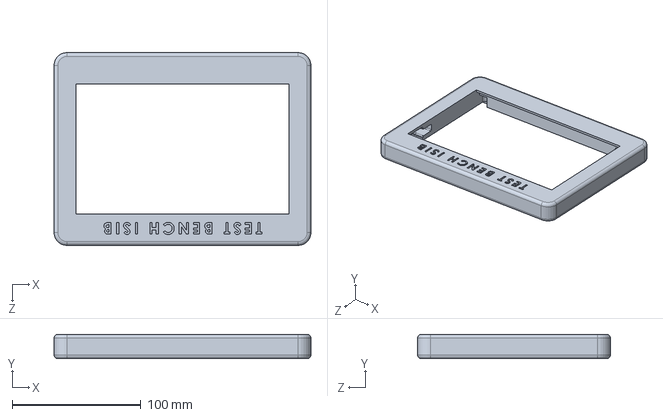
[picture p41: CAD file, 2020-06-09]
CAO/AttacheProfile/CacheECRAN.SLDPRT
200.0 x 19.0 x 150.0 mm
