GeoffreyBultot/MotorTestBench-PBE/CAO/BoitierElectro/motor_test_bench_Final.SLDPRT

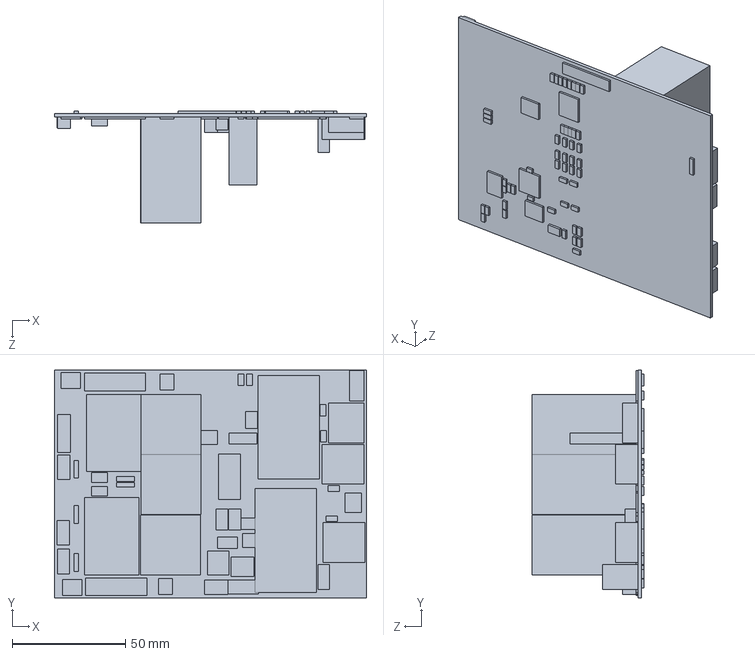
[picture p42: CAD file, 2020-06-09]
CAO/BoitierElectro/motor_test_bench_Final.SLDPRT
137.9 x 100.6 x 49.7 mm
