GeoffreyBultot/MotorTestBench-PBE/CAO/AttacheProfile/Ecran.SLDPRT

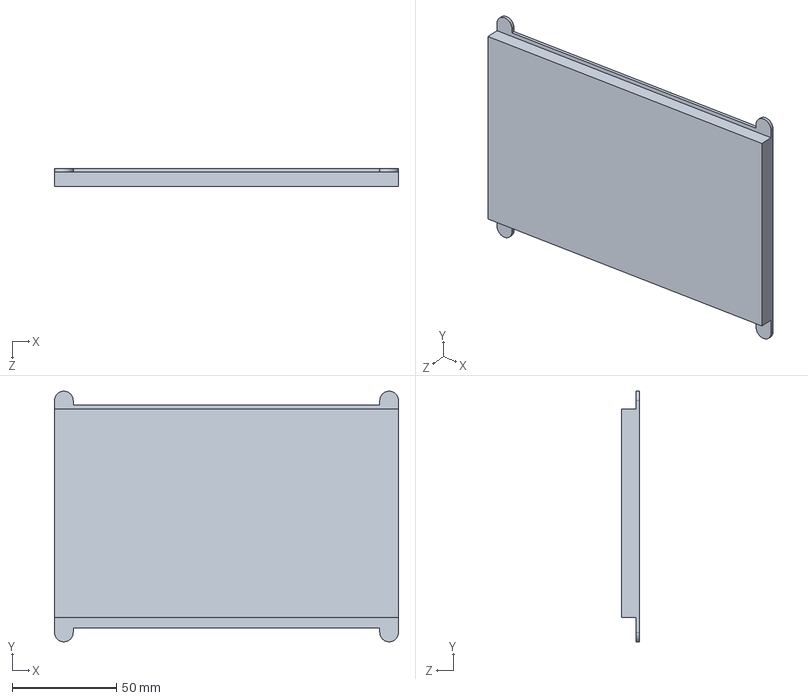
[picture p43: CAD file, 2020-06-09]
CAO/AttacheProfile/Ecran.SLDPRT
165.0 x 120.3 x 8.60 mm
