GeoffreyBultot/MotorTestBench-PBE/CAO/BoitierElectro/DESSUS.SLDPRT

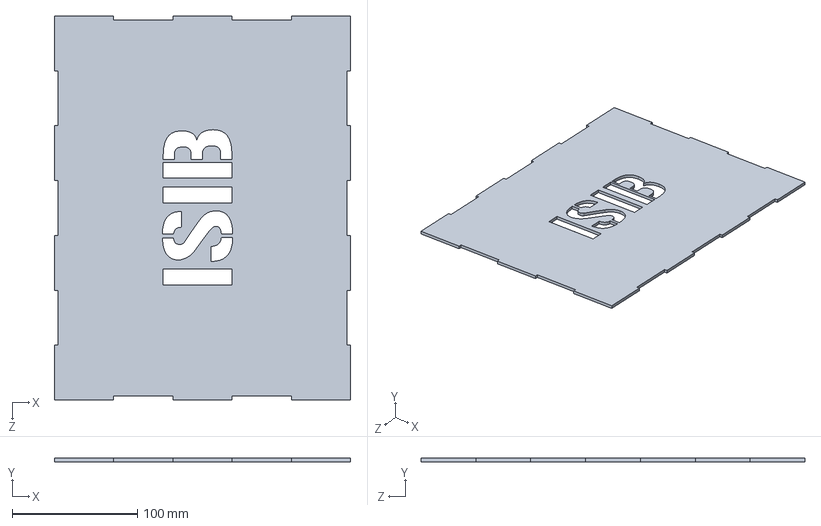
[picture p44: CAD file, 2020-06-09]
CAO/BoitierElectro/DESSUS.SLDPRT
236.0 x 3.00 x 306.0 mm
