GeoffreyBultot/MotorTestBench-PBE/CAO/BoitierElectro/BoitierTest.SLDPRT

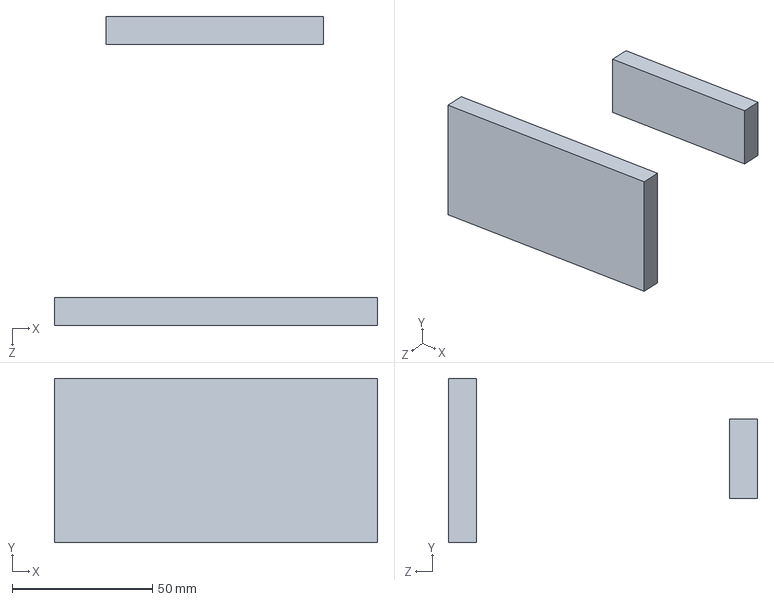
[picture p45: CAD file, 2020-06-09]
CAO/BoitierElectro/BoitierTest.SLDPRT
115.1 x 58.4 x 110.0 mm
