GeoffreyBultot/MotorTestBench-PBE/CAO/BoitierElectro/BAS.SLDPRT

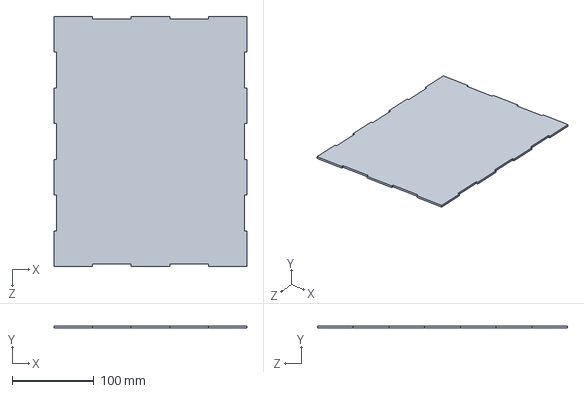
[picture p46: CAD file, 2020-06-09]
CAO/BoitierElectro/BAS.SLDPRT
236.0 x 3.00 x 306.0 mm
