GeoffreyBultot/MotorTestBench-PBE/CAO/BoitierElectro/SPACERS.SLDPRT

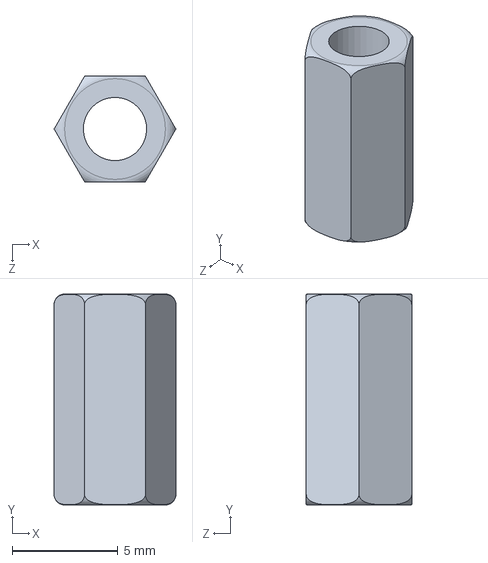
[picture p47: CAD file, 2020-06-09]
CAO/BoitierElectro/SPACERS.SLDPRT
5.77 x 10.0 x 5.00 mm
