GeoffreyBultot/MotorTestBench-PBE/CAO/BoitierElectro/ARRIERE.SLDPRT

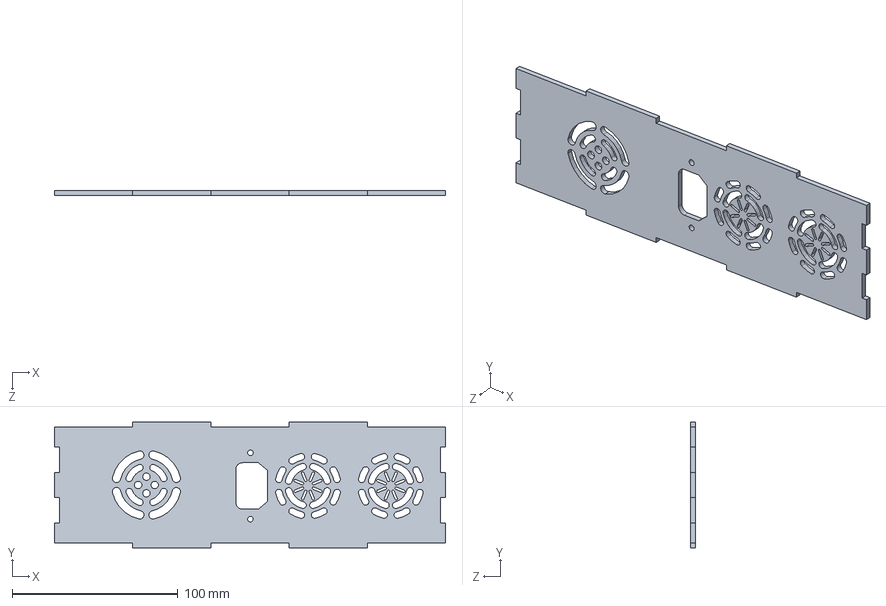
[picture p48: CAD file, 2020-06-09]
CAO/BoitierElectro/ARRIERE.SLDPRT
236.0 x 76.0 x 3.00 mm
