GeoffreyBultot/MotorTestBench-PBE/CAO/BoitierElectro/GAUCHE.SLDPRT

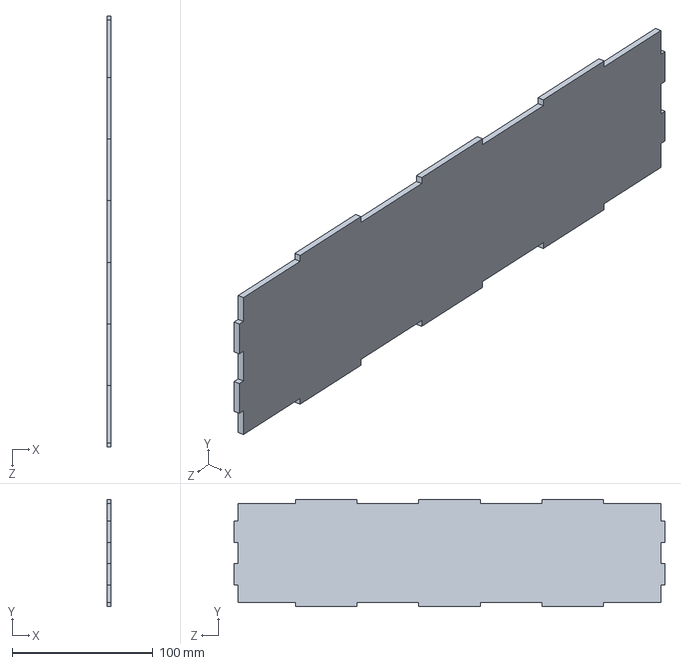
[picture p49: CAD file, 2020-06-09]
CAO/BoitierElectro/GAUCHE.SLDPRT
3.00 x 76.0 x 306.0 mm
