GeoffreyBultot/MotorTestBench-PBE/CAO/BoitierElectro/Alim.SLDPRT

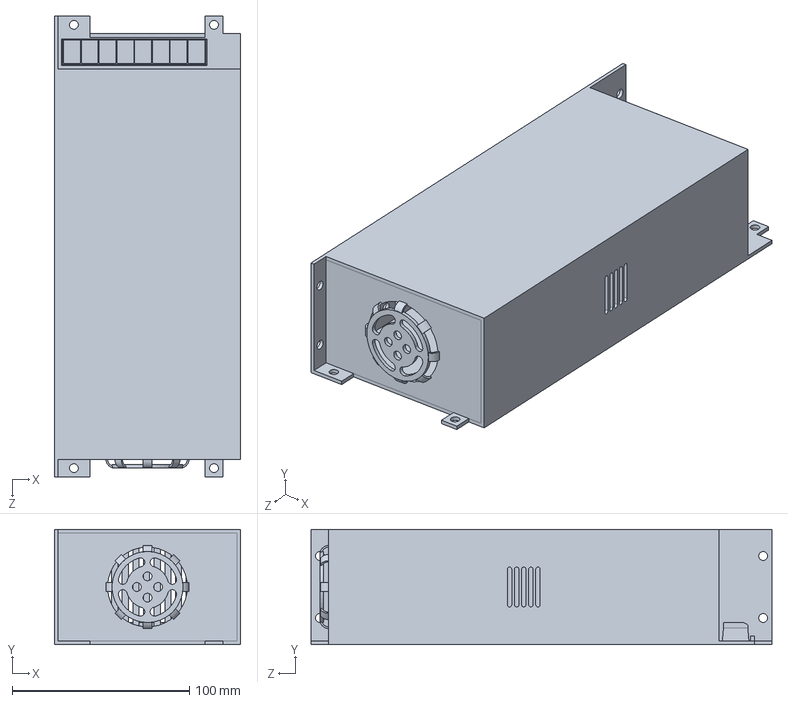
[picture p50: CAD file, 2020-06-09]
CAO/BoitierElectro/Alim.SLDPRT
105.0 x 65.0 x 260.0 mm
