GeoffreyBultot/MotorTestBench-PBE/CAO/BoitierElectro/Refroidisseur.SLDPRT

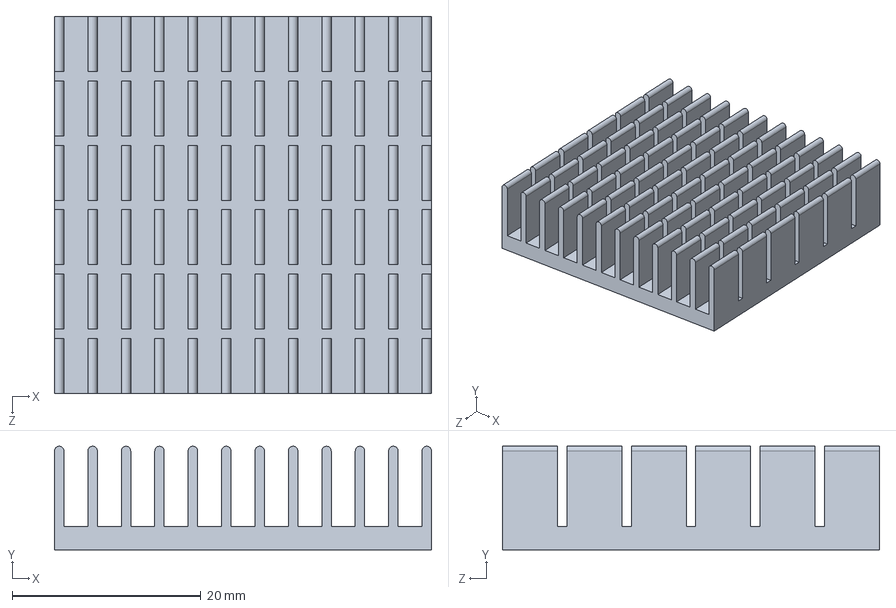
[picture p51: CAD file, 2020-06-09]
CAO/BoitierElectro/Refroidisseur.SLDPRT
40.0 x 11.0 x 40.0 mm
