GeoffreyBultot/MotorTestBench-PBE/CAO/BoitierElectro/FirstPROTOpcb v11.SLDPRT

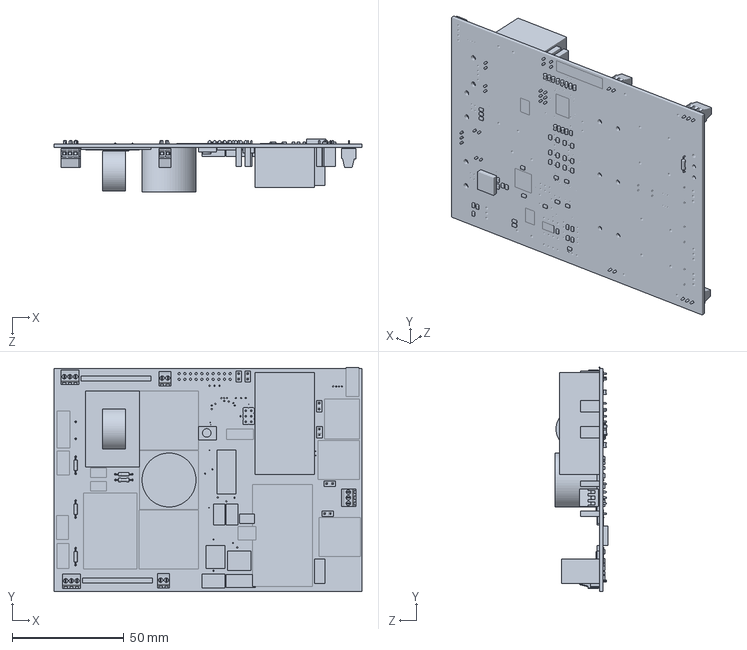
[picture p52: CAD file, 2020-06-09]
CAO/BoitierElectro/FirstPROTOpcb v11.SLDPRT
137.9 x 100.5 x 23.9 mm
