GeoffreyBultot/MotorTestBench-PBE/CAO/BoitierElectro/Rpi components/raspberry_pi_B+_(microsd2).SLDPRT

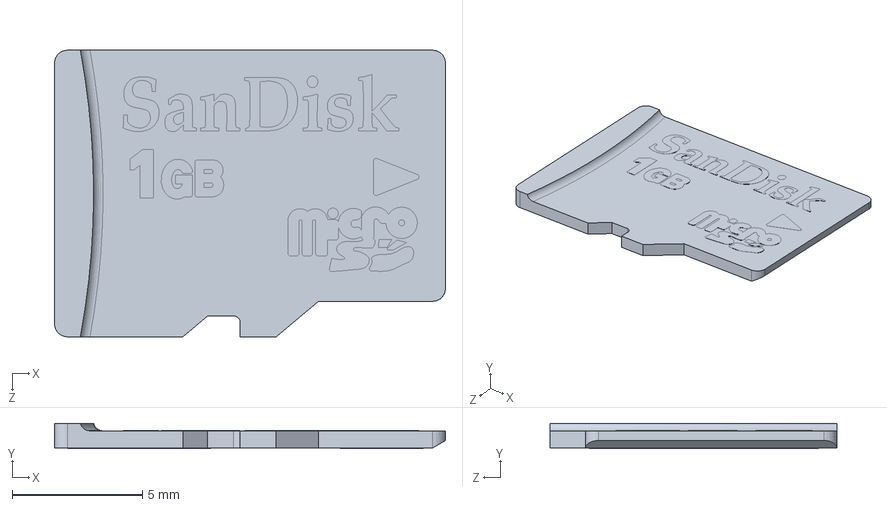
[picture p53: CAD file, 2020-06-09]
CAO/BoitierElectro/Rpi components/raspberry_pi_B+_(microsd2).SLDPRT
15.0 x 0.975 x 11.0 mm
