GeoffreyBultot/MotorTestBench-PBE/CAO/BoitierElectro/Rpi components/Raspberry Pi 3165.sldprt

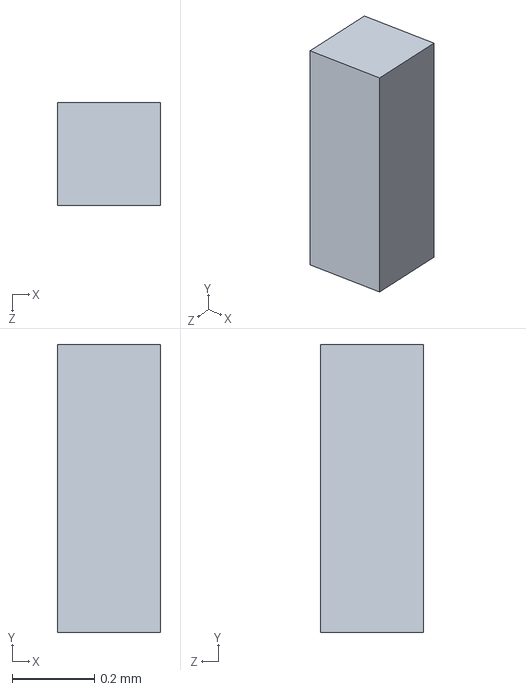
[picture p54: CAD file, 2020-06-09]
CAO/BoitierElectro/Rpi components/Raspberry Pi 3165.sldprt
0.25 x 0.7 x 0.25 mm
