GeoffreyBultot/MotorTestBench-PBE/CAO/BoitierElectro/Rpi components/Raspberry Pi 349.sldprt

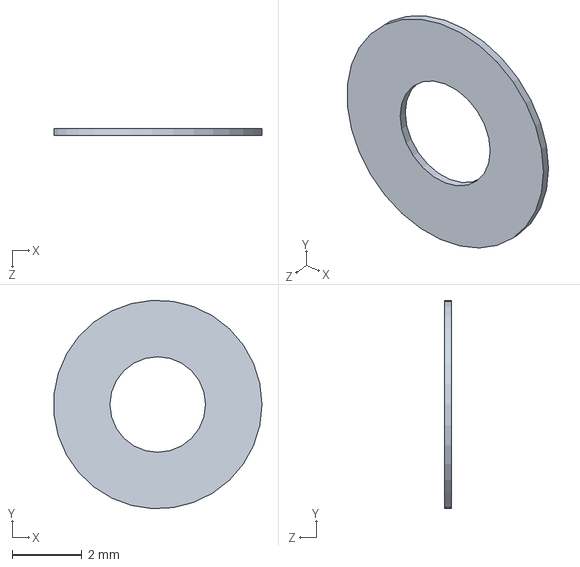
[picture p55: CAD file, 2020-06-09]
CAO/BoitierElectro/Rpi components/Raspberry Pi 349.sldprt
5.98 x 5.99 x 0.2 mm
