GeoffreyBultot/MotorTestBench-PBE/CAO/BoitierElectro/Rpi components/Raspberry Pi 3164.sldprt

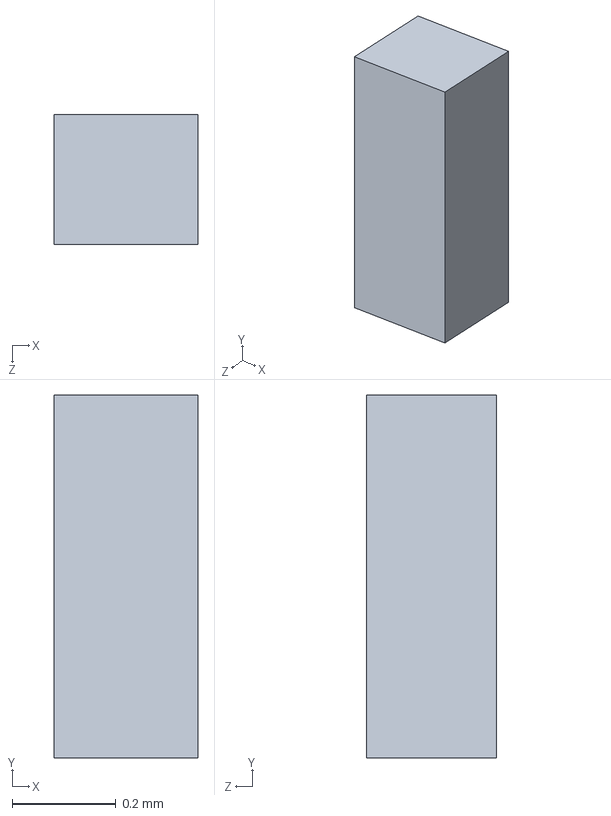
[picture p56: CAD file, 2020-06-09]
CAO/BoitierElectro/Rpi components/Raspberry Pi 3164.sldprt
0.278 x 0.7 x 0.25 mm
