GeoffreyBultot/MotorTestBench-PBE/CAO/BoitierElectro/Rpi components/HANRUN2_HR911105A.sldprt

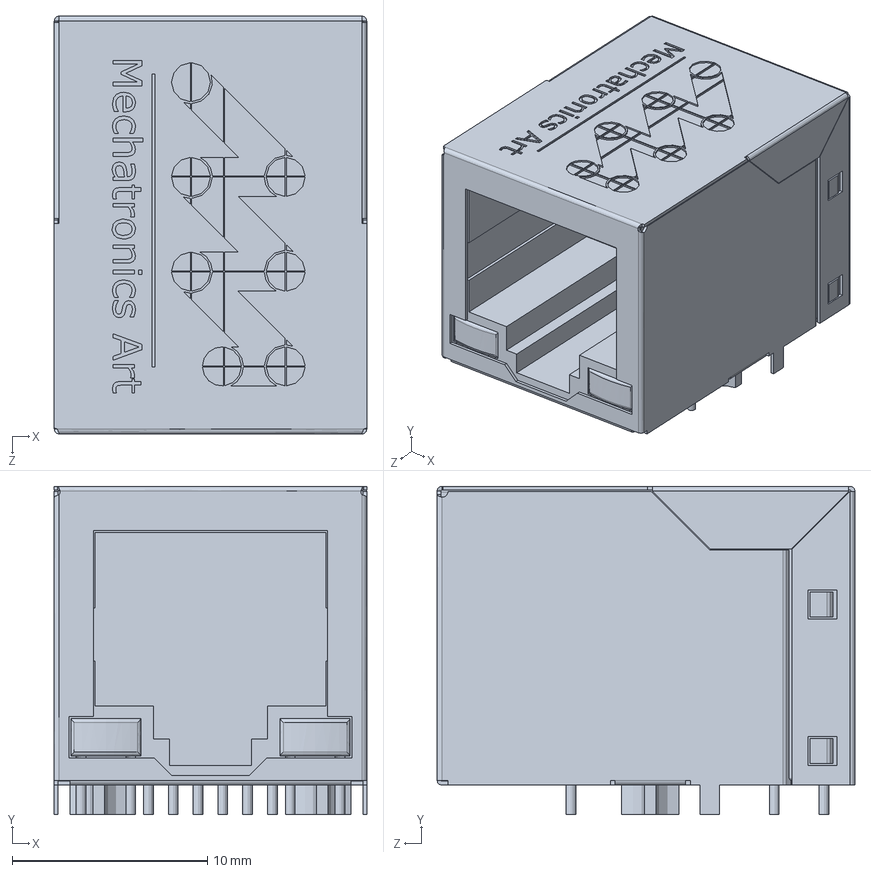
[picture p57: CAD file, 2020-06-09]
CAO/BoitierElectro/Rpi components/HANRUN2_HR911105A.sldprt
16.0 x 16.8 x 21.4 mm
