GeoffreyBultot/MotorTestBench-PBE/CAO/BoitierElectro/Rpi components/raspberry_pi_B_(RJ45).SLDPRT

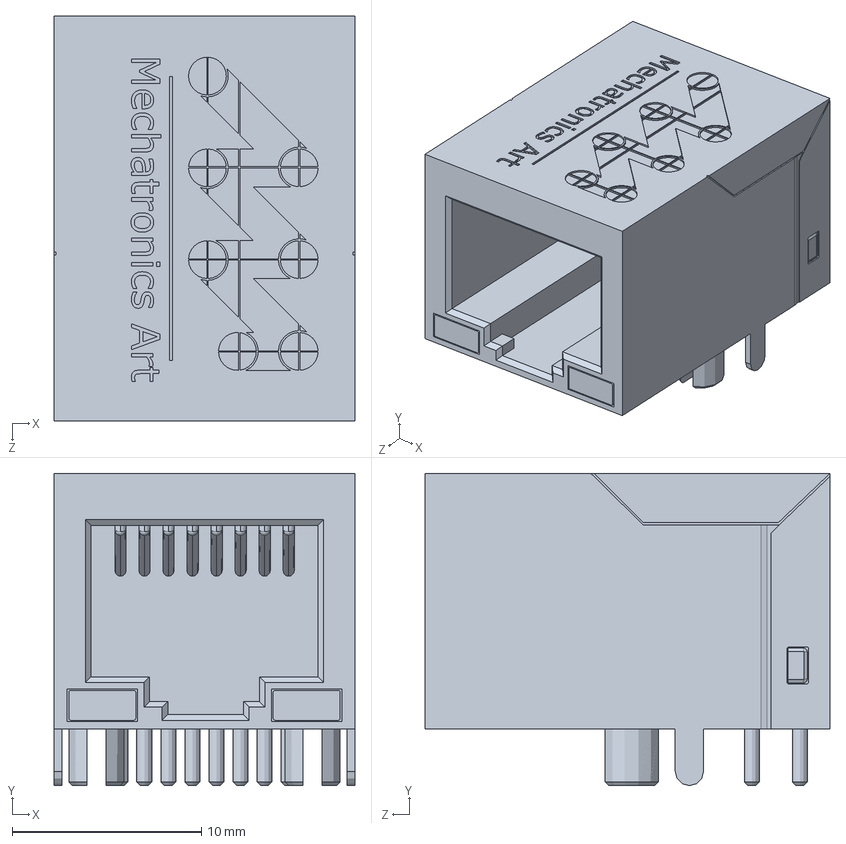
[picture p58: CAD file, 2020-06-09]
CAO/BoitierElectro/Rpi components/raspberry_pi_B_(RJ45).SLDPRT
15.9 x 16.5 x 21.4 mm
