GeoffreyBultot/MotorTestBench-PBE/CAO/BoitierElectro/Rpi components/Strait Headers.SLDPRT

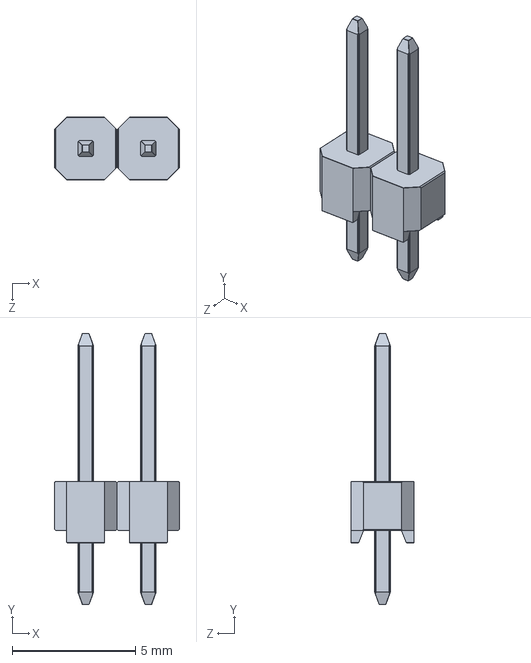
[picture p59: CAD file, 2020-06-09]
CAO/BoitierElectro/Rpi components/Strait Headers.SLDPRT
5.08 x 11.0 x 2.54 mm
