GeoffreyBultot/MotorTestBench-PBE/CAO/BoitierElectro/Rpi components/Raspberry Pi 341.sldprt

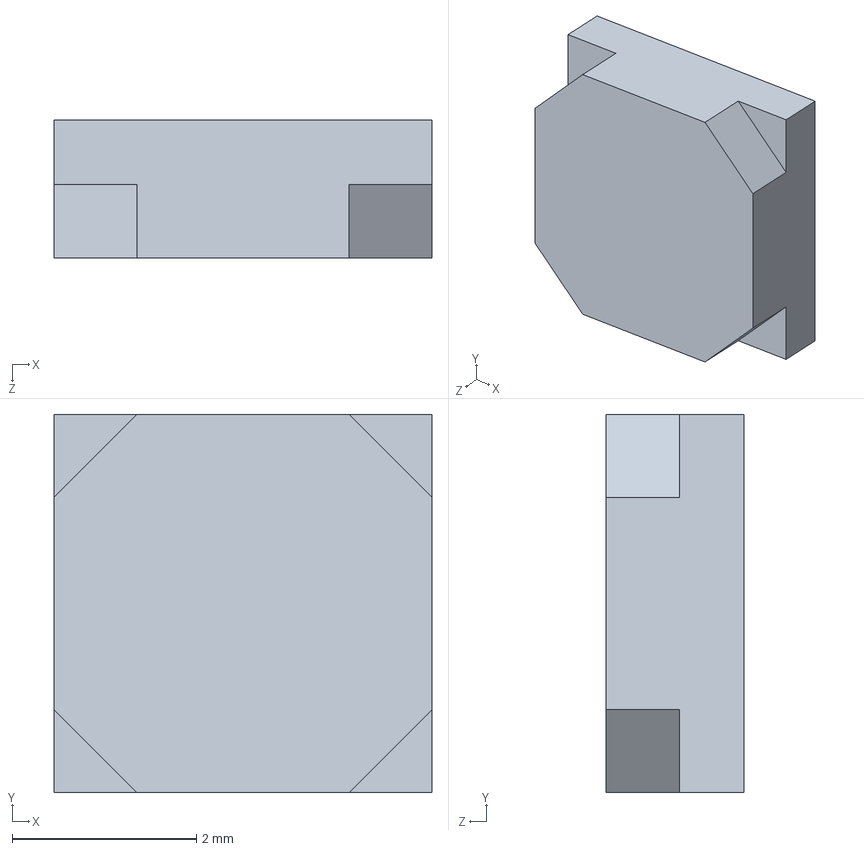
[picture p60: CAD file, 2020-06-09]
CAO/BoitierElectro/Rpi components/Raspberry Pi 341.sldprt
4.10 x 4.10 x 1.50 mm
