GeoffreyBultot/MotorTestBench-PBE/(list of files, cad)

Other CAD files:
CAO/BoitierElectro/Rpi components/Raspberry Pi 3359.sldprt
CAO/AttacheProfile/PlaqueDos_AVEC_RPI.SLDPRT
CAO/BoitierElectro/Rpi components/Raspberry Pi 3183.sldprt
CAO/BoitierElectro/Rpi components/Raspberry Pi 3108.sldprt
CAO/BoitierElectro/Rpi components/Raspberry Pi 3348.sldprt
CAO/BoitierElectro/Rpi components/Raspberry Pi 369.sldprt
CAO/BoitierElectro/Rpi components/Raspberry Pi 3314.sldprt
CAO/BoitierElectro/Rpi components/Raspberry Pi 337.sldprt
CAO/BoitierElectro/Rpi components/Raspberry Pi 3216.sldprt
CAO/BoitierElectro/Rpi components/Raspberry Pi 3198.sldprt
CAO/BoitierElectro/Rpi components/Raspberry Pi 367.sldprt
CAO/BoitierElectro/Rpi components/Raspberry Pi 32.sldprt
CAO/BoitierElectro/Rpi components/Raspberry Pi 3169.sldprt
CAO/BoitierElectro/motor_test_bench.SLDPRT
CAO/BoitierElectro/Rpi components/Raspberry Pi 3175.sldprt
CAO/BoitierElectro/DROIT.SLDPRT
CAO/BoitierElectro/Rpi components/Raspberry Pi 3301.sldprt
CAO/BoitierElectro/Rpi components/Raspberry Pi 3197.sldprt
CAO/BoitierElectro/Rpi components/PJ-322.sldprt
CAO/BoitierElectro/Rpi components/Raspberry Pi 3302.sldprt
CAO/BoitierElectro/Rpi components/Raspberry Pi 3154.sldprt
CAO/BoitierElectro/Rpi components/Raspberry Pi 3102.sldprt
CAO/BoitierElectro/Rpi components/Raspberry Pi 3123.sldprt
CAO/BoitierElectro/Rpi components/Raspberry Pi 331.sldprt
CAO/BoitierElectro/Rpi components/Raspberry Pi 3322.sldprt
CAO/BoitierElectro/Rpi components/Raspberry Pi 3346.sldprt
CAO/BoitierElectro/Rpi components/Raspberry Pi 3150.sldprt
CAO/BoitierElectro/Rpi components/Raspberry Pi 35.sldprt
CAO/BoitierElectro/Rpi components/Raspberry Pi 385.sldprt
CAO/BoitierElectro/Rpi components/Raspberry Pi 3172.sldprt
CAO/BoitierElectro/Rpi components/Raspberry Pi 3213.sldprt
CAO/BoitierElectro/Rpi components/Raspberry Pi 3129.sldprt
CAO/BoitierElectro/Rpi components/Raspberry Pi 3124.sldprt
CAO/BoitierElectro/Rpi components/Raspberry Pi 3191.sldprt
CAO/BoitierElectro/Rpi components/Raspberry Pi 388.sldprt
CAO/BoitierElectro/Rpi components/Raspberry Pi 3266.sldprt
CAO/BoitierElectro/Rpi components/Raspberry Pi 3227.sldprt
CAO/BoitierElectro/Rpi components/Raspberry Pi 3132.sldprt
CAO/BoitierElectro/Rpi components/Raspberry Pi 361.sldprt
CAO/BoitierElectro/Rpi components/Raspberry Pi 362.sldprt
CAO/BoitierElectro/Rpi components/Raspberry Pi 3159.sldprt
CAO/BoitierElectro/Rpi components/Raspberry Pi 3233.sldprt
CAO/BoitierElectro/Rpi components/Raspberry Pi 3218.sldprt
CAO/BoitierElectro/Rpi components/Raspberry Pi 3222.sldprt
CAO/BoitierElectro/Rpi components/Raspberry Pi 3200.sldprt
CAO/BoitierElectro/Rpi components/Raspberry Pi 3349.sldprt
CAO/BoitierElectro/Rpi components/Raspberry Pi 326.sldprt
CAO/BoitierElectro/Rpi components/Raspberry Pi 329.sldprt
CAO/BoitierElectro/Rpi components/Raspberry Pi 3130.sldprt
CAO/BoitierElectro/Rpi components/Raspberry Pi 3109.sldprt
CAO/BoitierElectro/Rpi components/Raspberry Pi 3181.sldprt
CAO/BoitierElectro/Rpi components/Raspberry Pi 3215.sldprt
CAO/BoitierElectro/Rpi components/Raspberry Pi 3296.sldprt
CAO/BoitierElectro/Rpi components/Raspberry Pi 3125.sldprt
CAO/BoitierElectro/Rpi components/Raspberry Pi 330.sldprt
CAO/BoitierElectro/Rpi components/Raspberry Pi 3230.sldprt
CAO/BoitierElectro/Rpi components/Raspberry Pi 3143.sldprt
CAO/BoitierElectro/Rpi components/Raspberry Pi 3327.sldprt
CAO/BoitierElectro/Rpi components/Raspberry Pi 3178.sldprt
CAO/BoitierElectro/Rpi components/Raspberry Pi 3293.sldprt
CAO/BoitierElectro/Rpi components/Raspberry Pi 3315.sldprt
CAO/BoitierElectro/Rpi components/Raspberry Pi 3305.sldprt
CAO/BoitierElectro/Rpi components/Raspberry Pi 378.sldprt
CAO/BoitierElectro/Rpi components/Raspberry Pi 3111.sldprt
CAO/BoitierElectro/Rpi components/Raspberry Pi 3332.sldprt
CAO/BoitierElectro/Rpi components/Raspberry Pi 3226.sldprt
CAO/BoitierElectro/Rpi components/Raspberry Pi 365.sldprt
CAO/BoitierElectro/Rpi components/Raspberry Pi 3103.sldprt
CAO/BoitierElectro/Rpi components/Raspberry Pi 3176.sldprt
CAO/BoitierElectro/Rpi components/Raspberry Pi 3214.sldprt
CAO/BoitierElectro/Rpi components/Raspberry Pi 3187.sldprt
CAO/BoitierElectro/Rpi components/Raspberry Pi 3338.sldprt
CAO/BoitierElectro/Rpi components/Raspberry Pi 3127.sldprt
CAO/BoitierElectro/Rpi components/Raspberry Pi 379.sldprt
CAO/BoitierElectro/Rpi components/Raspberry Pi 3188.sldprt
CAO/BoitierElectro/Rpi components/Raspberry Pi 310.sldprt
CAO/BoitierElectro/Rpi components/Raspberry Pi 3318.sldprt
CAO/BoitierElectro/Rpi components/Raspberry Pi 3297.sldprt
CAO/BoitierElectro/Rpi components/Raspberry Pi 348.sldprt
CAO/BoitierElectro/Rpi components/Raspberry Pi 316.sldprt
CAO/BoitierElectro/Rpi components/Raspberry Pi 3120.sldprt
CAO/BoitierElectro/Rpi components/Raspberry Pi 3311.sldprt
CAO/BoitierElectro/Rpi components/Raspberry Pi 373.sldprt
CAO/BoitierElectro/Rpi components/Raspberry Pi 3220.sldprt
CAO/BoitierElectro/Rpi components/Raspberry Pi 3317.sldprt
CAO/BoitierElectro/Rpi components/Raspberry Pi 3142.sldprt
CAO/BoitierElectro/Rpi components/Raspberry Pi 3118.sldprt
CAO/BoitierElectro/Rpi components/Raspberry Pi 344.sldprt
CAO/BoitierElectro/Rpi components/Raspberry Pi 317.sldprt
CAO/BoitierElectro/Rpi components/Raspberry Pi 3331.sldprt
CAO/BoitierElectro/Rpi components/Raspberry Pi 3122.sldprt
CAO/BoitierElectro/Rpi components/Raspberry Pi 3204.sldprt
CAO/BoitierElectro/Rpi components/Raspberry Pi 351.sldprt
CAO/BoitierElectro/Rpi components/Raspberry Pi 311.sldprt
CAO/BoitierElectro/Rpi components/Raspberry Pi 327.sldprt
CAO/BoitierElectro/Rpi components/Raspberry Pi 3114.sldprt
CAO/BoitierElectro/Rpi components/Raspberry Pi 3358.sldprt
CAO/BoitierElectro/Rpi components/Raspberry Pi 3352.sldprt
CAO/BoitierElectro/Rpi components/Raspberry Pi 3343.sldprt
CAO/BoitierElectro/Rpi components/Raspberry Pi 3300.sldprt
CAO/BoitierElectro/Rpi components/Raspberry Pi 371.sldprt
CAO/BoitierElectro/Rpi components/Raspberry Pi 324.sldprt
CAO/BoitierElectro/Rpi components/Raspberry Pi 3335.sldprt
CAO/BoitierElectro/Rpi components/Raspberry Pi 3310.sldprt
CAO/BoitierElectro/Rpi components/Raspberry Pi 376.sldprt
CAO/BoitierElectro/Rpi components/Raspberry Pi 3242.sldprt
CAO/BoitierElectro/Rpi components/Raspberry Pi 3212.sldprt
CAO/BoitierElectro/Rpi components/Raspberry Pi 350.sldprt
CAO/AttacheProfile/AttachePar3_30X30.AMF
CAO/AttacheProfile/CacheECRAN.AMF
CAO/AttacheProfile/PlaqueDos.AMF
CAO/BoitierElectro/Rpi components/MOLEX_1040310811.sldprt
CAO/BoitierElectro/Rpi components/MOLEX_672983090.sldprt
CAO/BoitierElectro/Rpi components/Raspberry Pi 31.sldprt
CAO/BoitierElectro/Rpi components/Raspberry Pi 3100.sldprt
CAO/BoitierElectro/Rpi components/Raspberry Pi 3101.sldprt
CAO/BoitierElectro/Rpi components/Raspberry Pi 3104.sldprt
CAO/BoitierElectro/Rpi components/Raspberry Pi 3105.sldprt
CAO/BoitierElectro/Rpi components/Raspberry Pi 3106.sldprt
CAO/BoitierElectro/Rpi components/Raspberry Pi 3107.sldprt
CAO/BoitierElectro/Rpi components/Raspberry Pi 3110.sldprt
CAO/BoitierElectro/Rpi components/Raspberry Pi 3112.sldprt
CAO/BoitierElectro/Rpi components/Raspberry Pi 3113.sldprt
CAO/BoitierElectro/Rpi components/Raspberry Pi 3115.sldprt
CAO/BoitierElectro/Rpi components/Raspberry Pi 3116.sldprt
CAO/BoitierElectro/Rpi components/Raspberry Pi 3117.sldprt
CAO/BoitierElectro/Rpi components/Raspberry Pi 3119.sldprt
CAO/BoitierElectro/Rpi components/Raspberry Pi 3121.sldprt
CAO/BoitierElectro/Rpi components/Raspberry Pi 3126.sldprt
CAO/BoitierElectro/Rpi components/Raspberry Pi 3128.sldprt
CAO/BoitierElectro/Rpi components/Raspberry Pi 313.sldprt
CAO/BoitierElectro/Rpi components/Raspberry Pi 3131.sldprt
CAO/BoitierElectro/Rpi components/Raspberry Pi 3133.sldprt
CAO/BoitierElectro/Rpi components/Raspberry Pi 3134.sldprt
CAO/BoitierElectro/Rpi components/Raspberry Pi 3135.sldprt
CAO/BoitierElectro/Rpi components/Raspberry Pi 3136.sldprt
CAO/BoitierElectro/Rpi components/Raspberry Pi 3137.sldprt
CAO/BoitierElectro/Rpi components/Raspberry Pi 3138.sldprt
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
