GeoffreyBultot/MotorTestBench-PBE/CAO/Rendering/PhotosAssemblageBoitier/BoitierAvecComposants/1_AjoutAlim.JPG

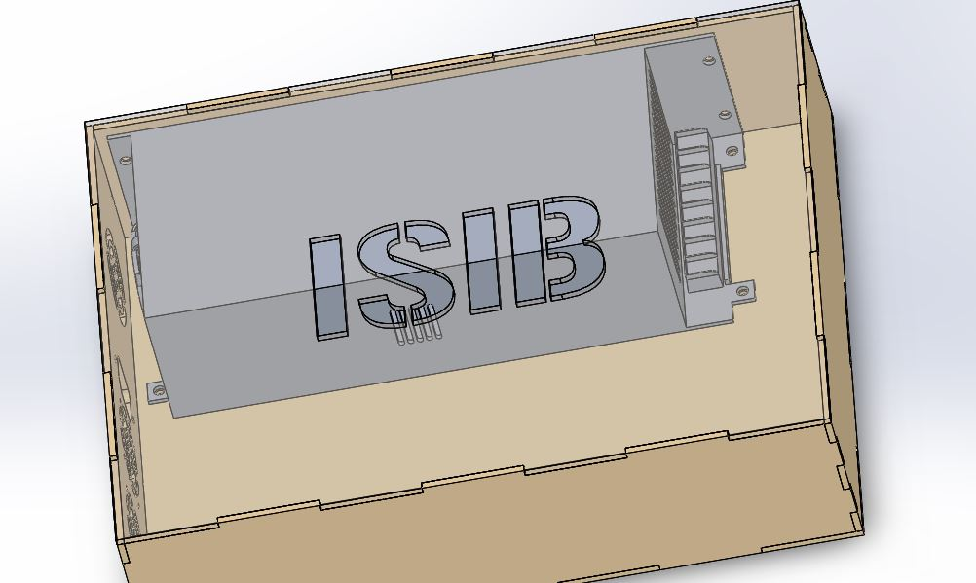
CAO/Rendering/PhotosAssemblageBoitier/BoitierAvecComposants/1_AjoutAlim.JPG
