GeoffreyBultot/MotorTestBench-PBE/CAO/Rendering/PhotosAssemblageBoitier/BoitierAvecComposants/2_AjoutVisserieAlim.JPG

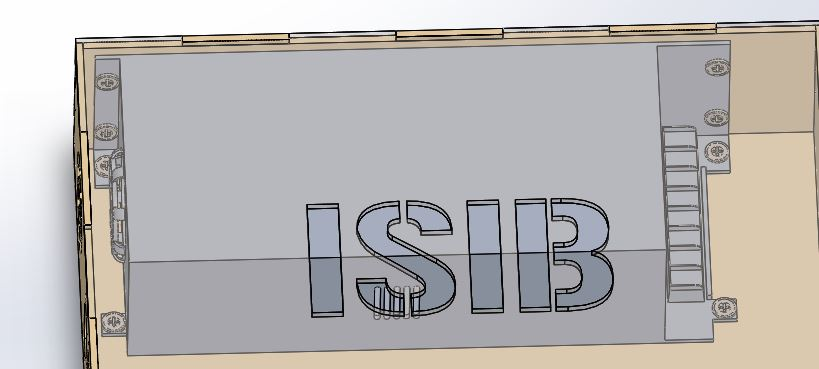
CAO/Rendering/PhotosAssemblageBoitier/BoitierAvecComposants/2_AjoutVisserieAlim.JPG
