GeoffreyBultot/MotorTestBench-PBE/CAO/Rendering/PhotosAssemblageBoitier/BoitierAvecComposants/3_AjouVentilos.JPG

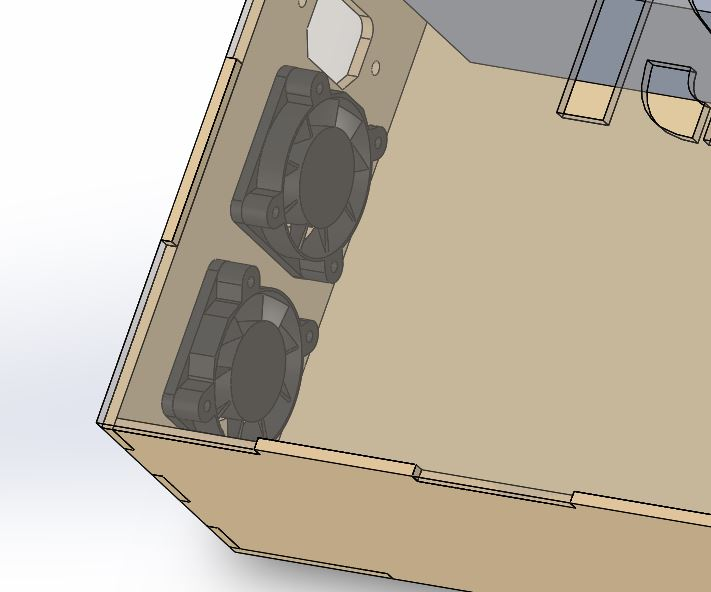
CAO/Rendering/PhotosAssemblageBoitier/BoitierAvecComposants/3_AjouVentilos.JPG
