GeoffreyBultot/MotorTestBench-PBE/CAO/Rendering/PhotosAssemblageBoitier/BoitierAvecComposants/4_AjoutVisserieVentilos.JPG

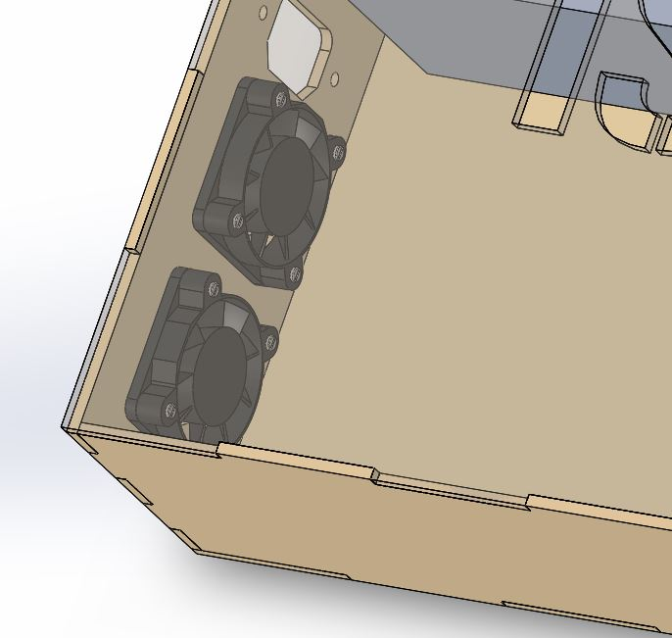
CAO/Rendering/PhotosAssemblageBoitier/BoitierAvecComposants/4_AjoutVisserieVentilos.JPG
