GeoffreyBultot/MotorTestBench-PBE/CAO/Rendering/PhotosAssemblageBoitier/BoitierAvecComposants/5_AjoutHeatSink.JPG

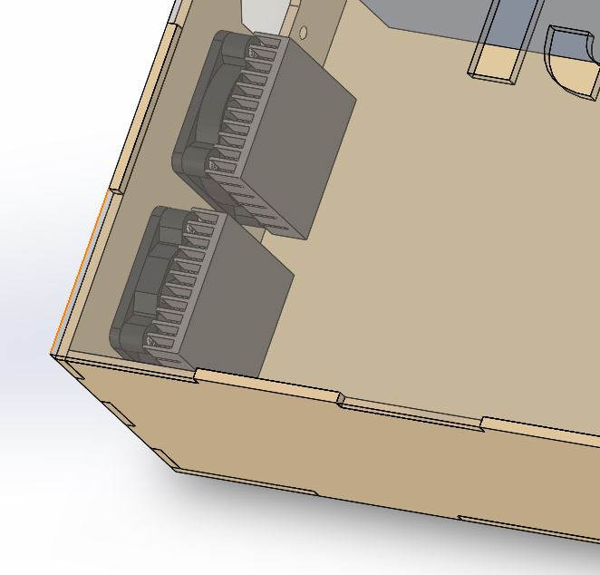
CAO/Rendering/PhotosAssemblageBoitier/BoitierAvecComposants/5_AjoutHeatSink.JPG
