GeoffreyBultot/MotorTestBench-PBE/CAO/Rendering/PhotosAssemblageBoitier/BoitierAvecComposants/6_VueArriereVentilos.JPG

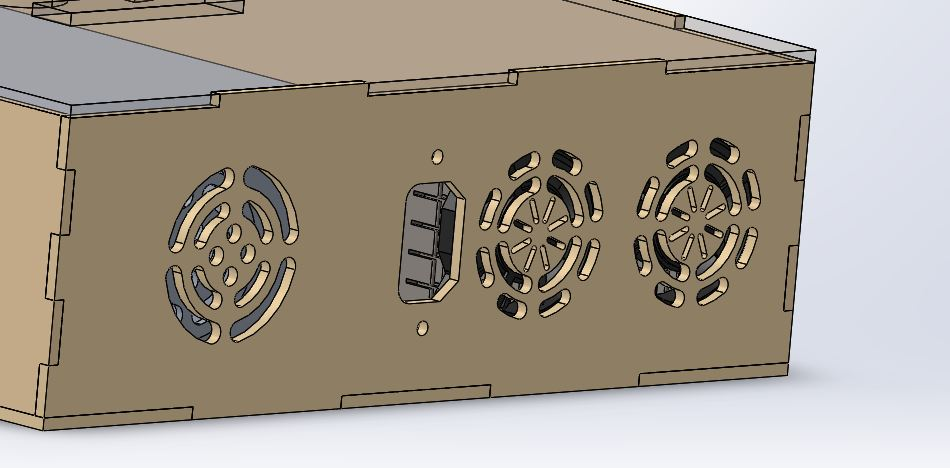
CAO/Rendering/PhotosAssemblageBoitier/BoitierAvecComposants/6_VueArriereVentilos.JPG
