GeoffreyBultot/MotorTestBench-PBE/CAO/Rendering/PhotosAssemblageBoitier/BoitierAvecComposants/7_AjoutPCB.JPG

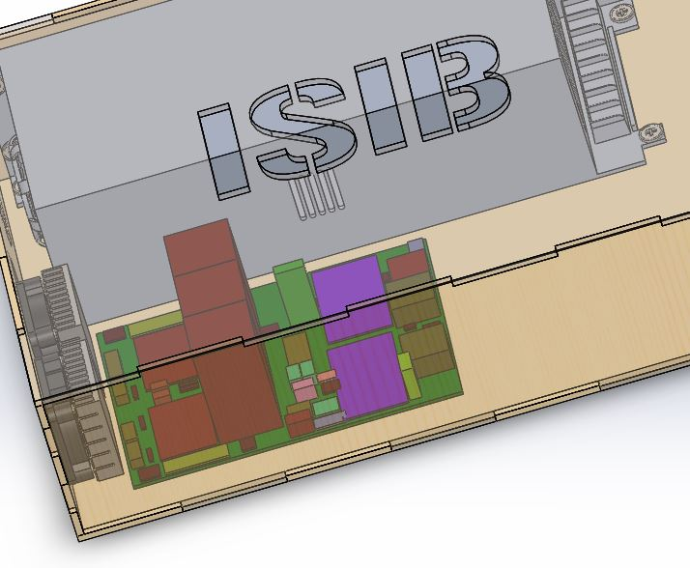
CAO/Rendering/PhotosAssemblageBoitier/BoitierAvecComposants/7_AjoutPCB.JPG
