GeoffreyBultot/MotorTestBench-PBE/CAO/Rendering/PhotosAssemblageBoitier/BoitierAvecComposants/9_CompletOrtho.JPG

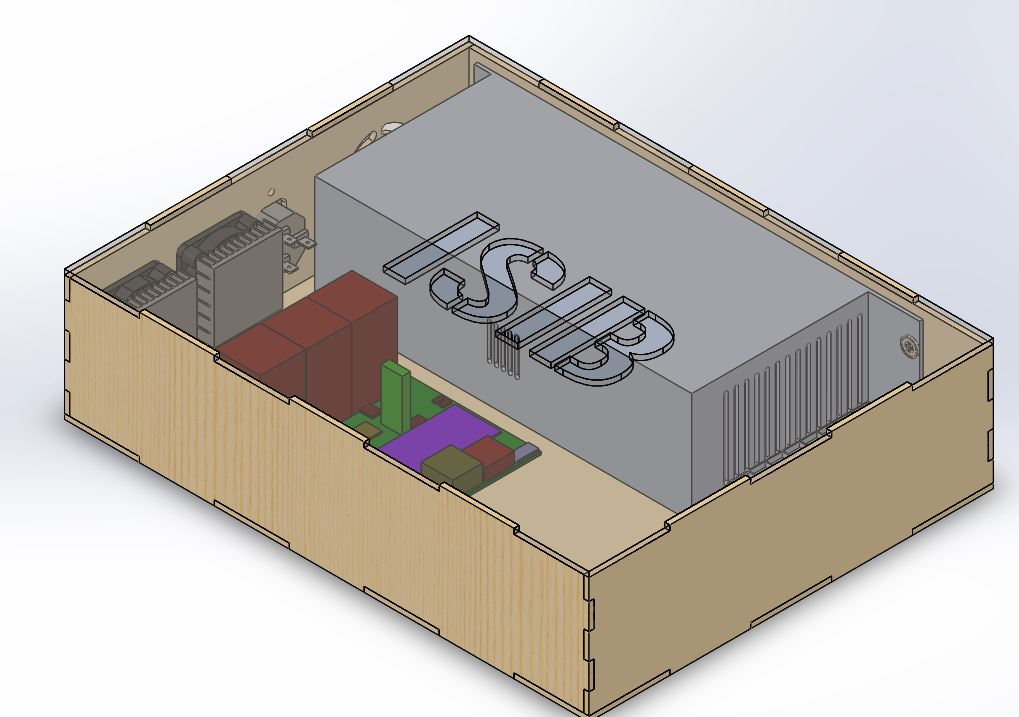
CAO/Rendering/PhotosAssemblageBoitier/BoitierAvecComposants/9_CompletOrtho.JPG
