GeoffreyBultot/MotorTestBench-PBE/CAO/Rendering/PhotosAssemblageBoitier/BoitierVide/OrthoBack2.JPG

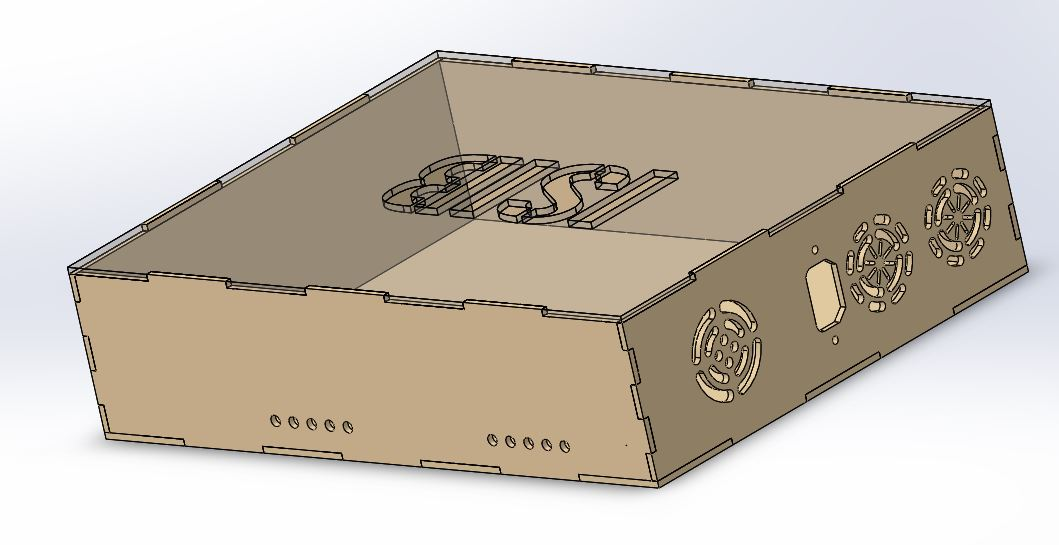
CAO/Rendering/PhotosAssemblageBoitier/BoitierVide/OrthoBack2.JPG
