GeoffreyBultot/MotorTestBench-PBE/CAO/Rendering/PhotosAssemblageBoitier/BoitierVide/OrthoBack.JPG

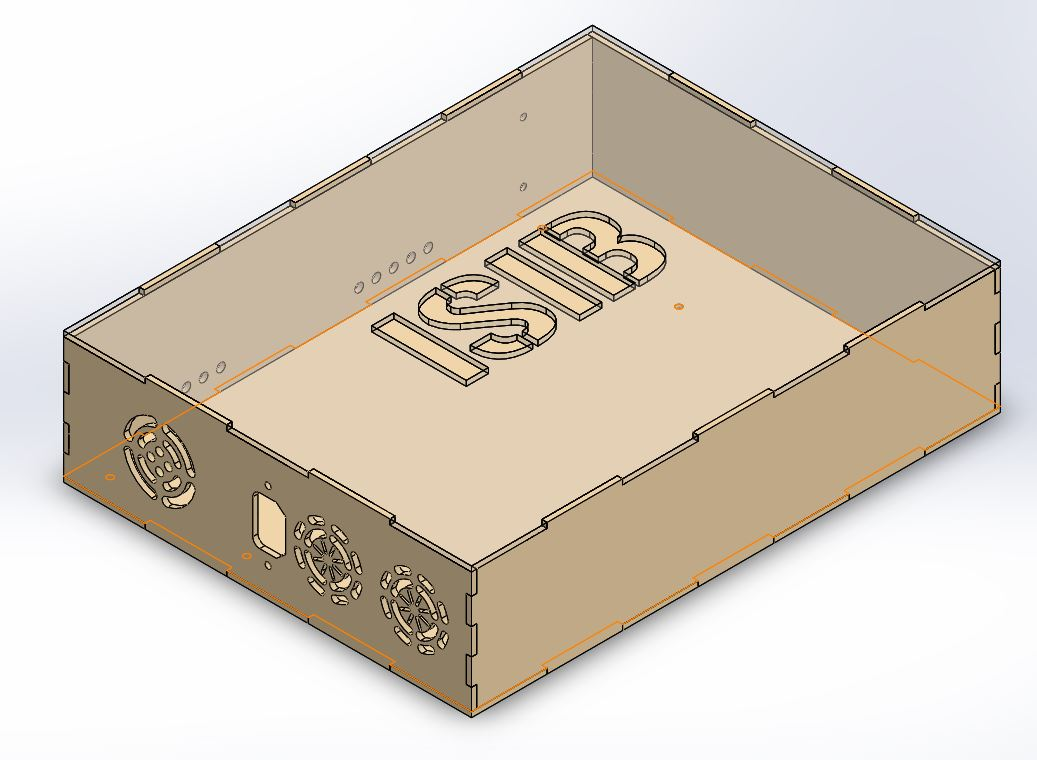
CAO/Rendering/PhotosAssemblageBoitier/BoitierVide/OrthoBack.JPG
