GeoffreyBultot/MotorTestBench-PBE/CAO/Rendering/PhotosAssemblageBoitier/BoitierVide/TOP.JPG

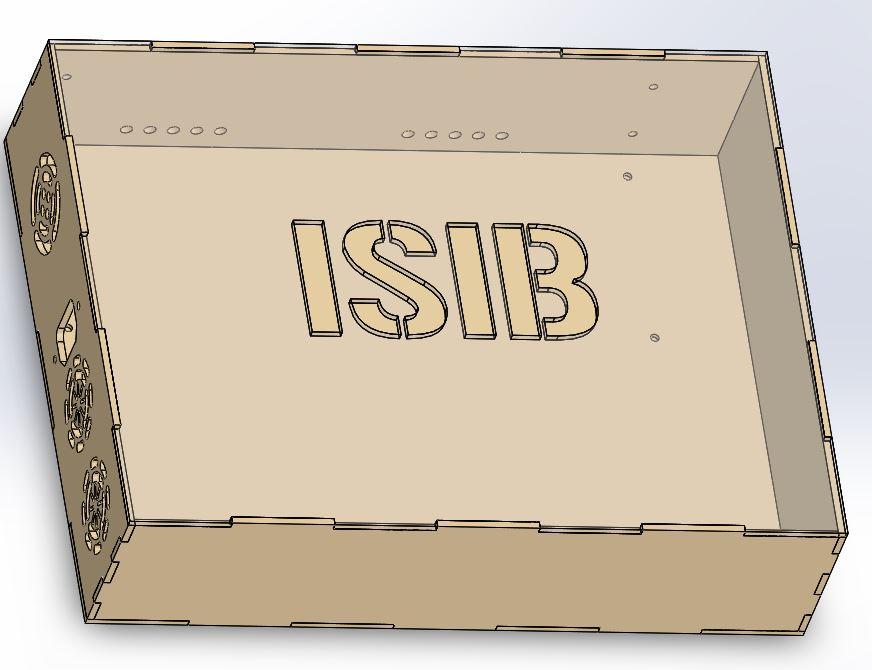
CAO/Rendering/PhotosAssemblageBoitier/BoitierVide/TOP.JPG
