GeoffreyBultot/MotorTestBench-PBE/CAO/Rendering/PhotosAssemblageBoitier/Composants/Alim1.JPG

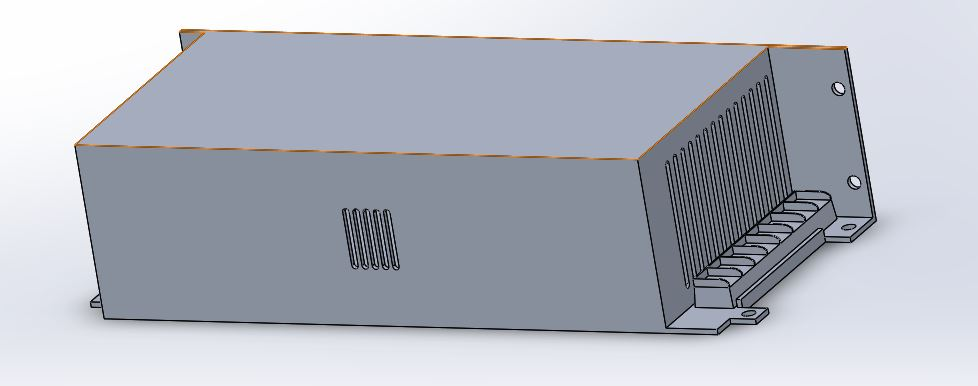
CAO/Rendering/PhotosAssemblageBoitier/Composants/Alim1.JPG
