GeoffreyBultot/MotorTestBench-PBE/CAO/Rendering/PhotosAssemblageBoitier/Composants/Alim2.JPG

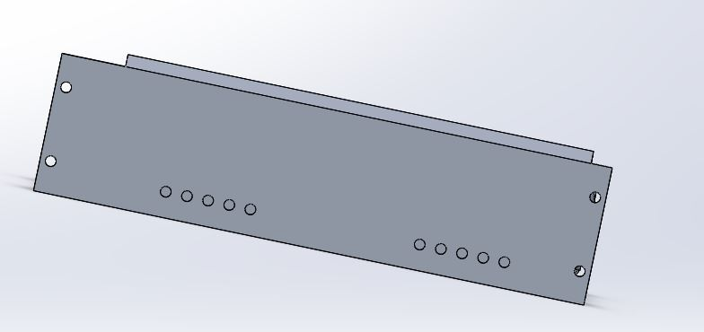
CAO/Rendering/PhotosAssemblageBoitier/Composants/Alim2.JPG
