GeoffreyBultot/MotorTestBench-PBE/CAO/Rendering/PhotosAssemblageBoitier/Composants/Alim3.JPG

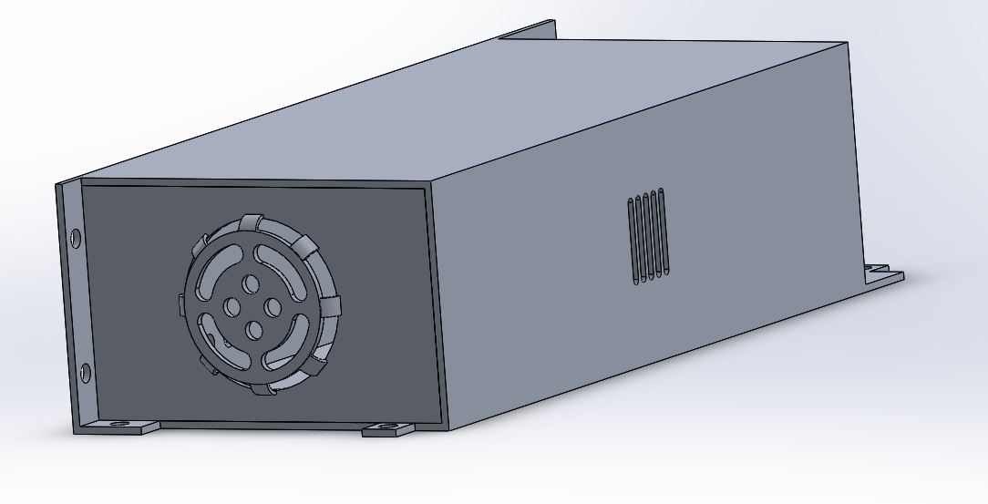
CAO/Rendering/PhotosAssemblageBoitier/Composants/Alim3.JPG
