GeoffreyBultot/MotorTestBench-PBE/CAO/Rendering/PhotosAssemblageBoitier/Composants/Alim4.JPG

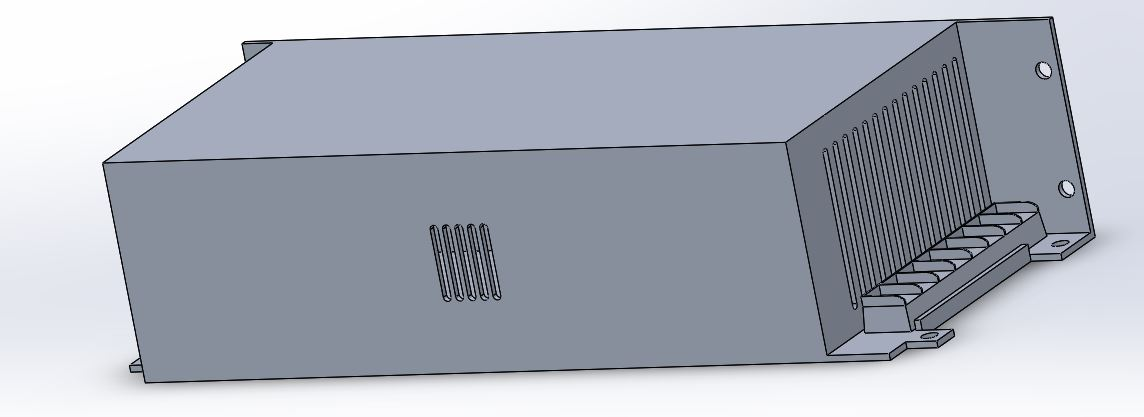
CAO/Rendering/PhotosAssemblageBoitier/Composants/Alim4.JPG
