GeoffreyBultot/MotorTestBench-PBE/CAO/Rendering/PhotosAssemblageBoitier/Composants/Con_230V.JPG

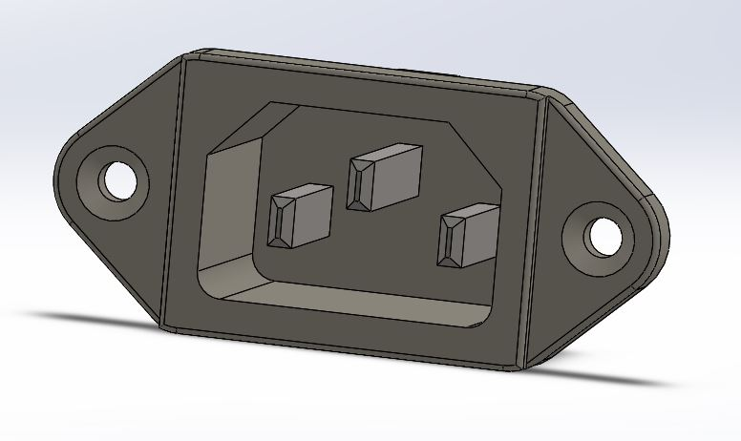
CAO/Rendering/PhotosAssemblageBoitier/Composants/Con_230V.JPG
