GeoffreyBultot/MotorTestBench-PBE/CAO/Rendering/PhotosAssemblageBoitier/Composants/CON_230V_2.JPG

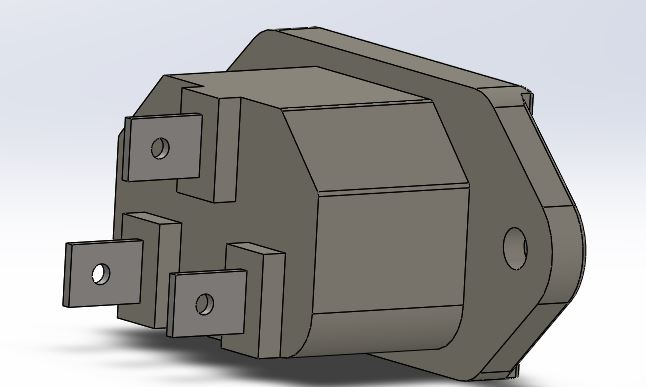
CAO/Rendering/PhotosAssemblageBoitier/Composants/CON_230V_2.JPG
