GeoffreyBultot/MotorTestBench-PBE/CAO/Rendering/PhotosAssemblageBoitier/Composants/PCB_1.JPG

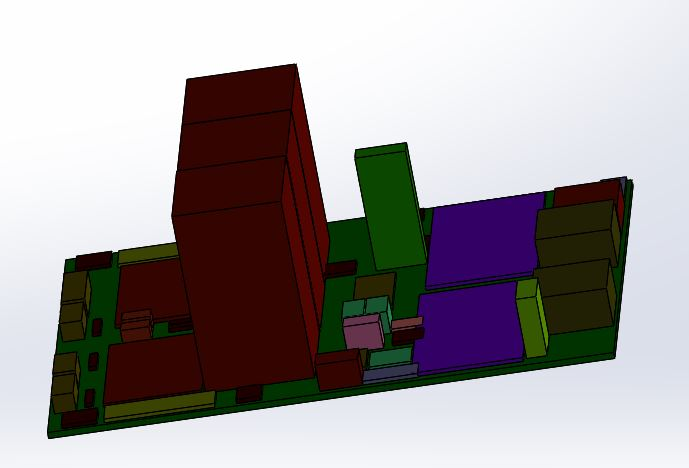
CAO/Rendering/PhotosAssemblageBoitier/Composants/PCB_1.JPG
