GeoffreyBultot/MotorTestBench-PBE/CAO/Rendering/PhotosAssemblageBoitier/Composants/PCB_2.JPG

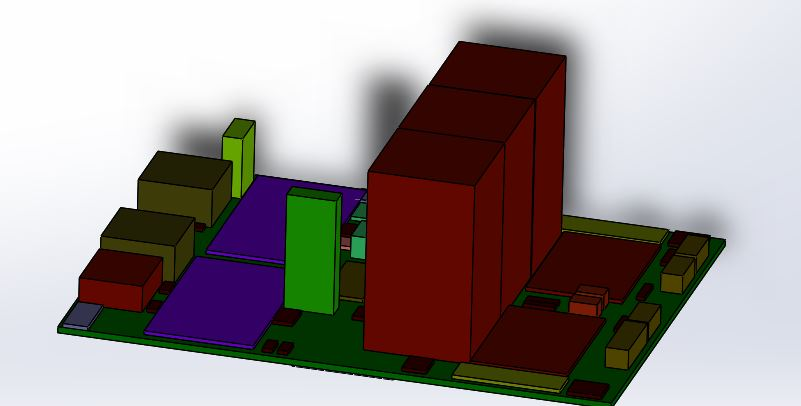
CAO/Rendering/PhotosAssemblageBoitier/Composants/PCB_2.JPG
