GeoffreyBultot/MotorTestBench-PBE/CAO/Rendering/PhotosAssemblageBoitier/Composants/PCB_DESSOUS.JPG

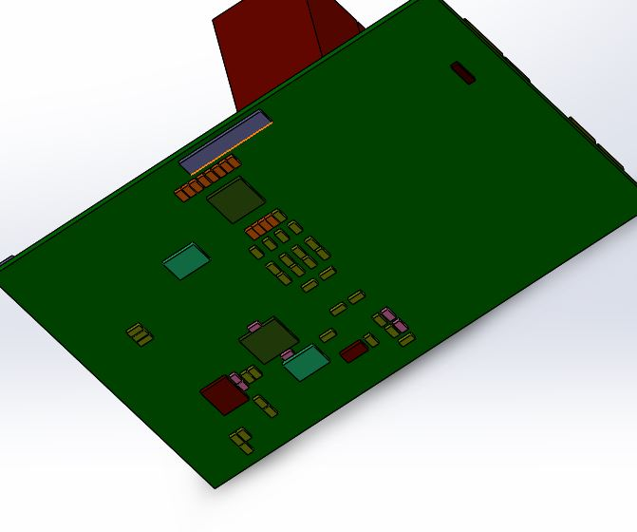
CAO/Rendering/PhotosAssemblageBoitier/Composants/PCB_DESSOUS.JPG
