GeoffreyBultot/MotorTestBench-PBE/CAO/Rendering/PhotosAssemblageBoitier/Composants/Refroidisseur1.JPG

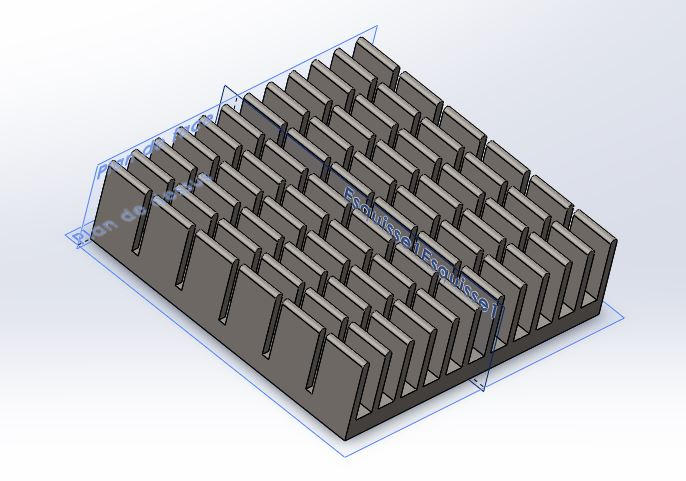
CAO/Rendering/PhotosAssemblageBoitier/Composants/Refroidisseur1.JPG
