GeoffreyBultot/MotorTestBench-PBE/CAO/Rendering/PhotosAssemblageBoitier/Composants/Refroidisseur2.JPG

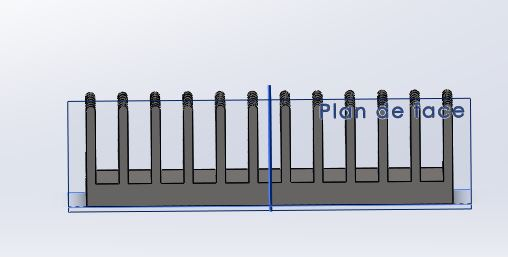
CAO/Rendering/PhotosAssemblageBoitier/Composants/Refroidisseur2.JPG
