GeoffreyBultot/MotorTestBench-PBE/CAO/Rendering/PhotosAssemblageBoitier/Composants/Ventilo_1.JPG

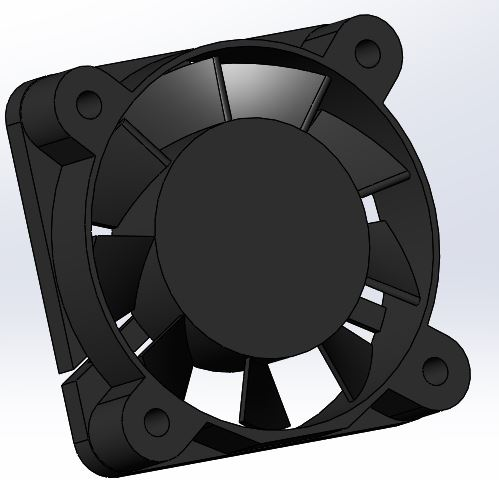
CAO/Rendering/PhotosAssemblageBoitier/Composants/Ventilo_1.JPG
