GeoffreyBultot/MotorTestBench-PBE/CAO/Rendering/PhotosAssemblageBoitier/Composants/Ventilo_2.JPG

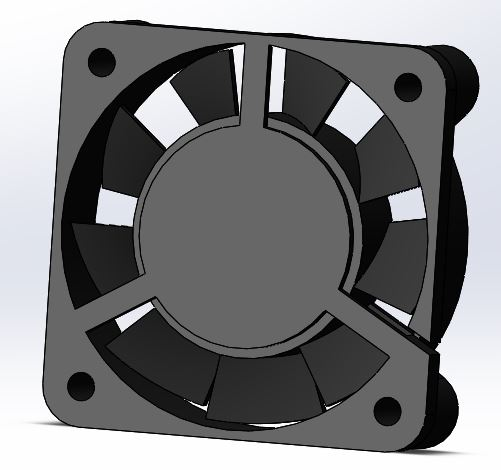
CAO/Rendering/PhotosAssemblageBoitier/Composants/Ventilo_2.JPG
