GeoffreyBultot/MotorTestBench-PBE/CAO/Rendering/PhotosAssemblageEcran/BackDetach.JPG

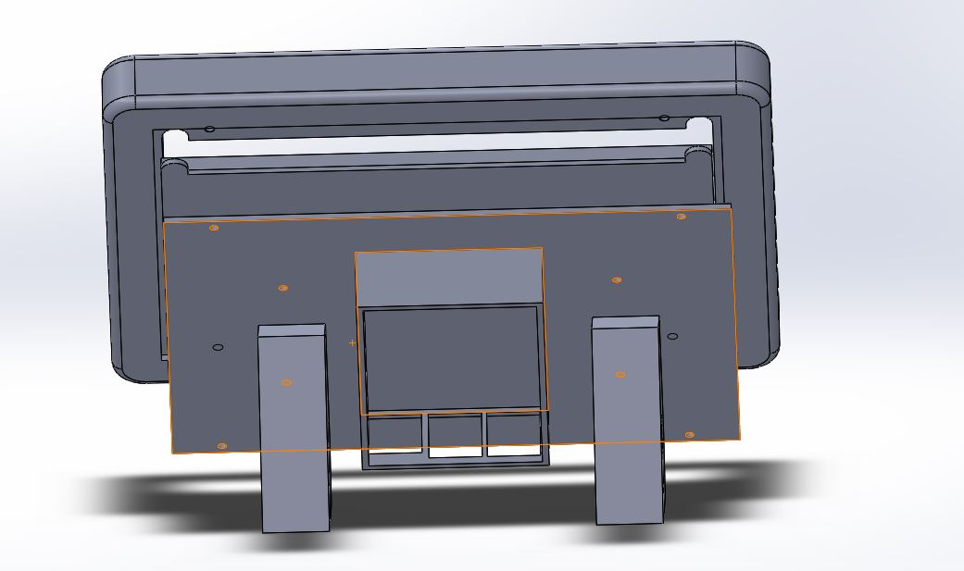
CAO/Rendering/PhotosAssemblageEcran/BackDetach.JPG
