GeoffreyBultot/MotorTestBench-PBE/CAO/Rendering/PhotosAssemblageEcran/CompletAttache.JPG

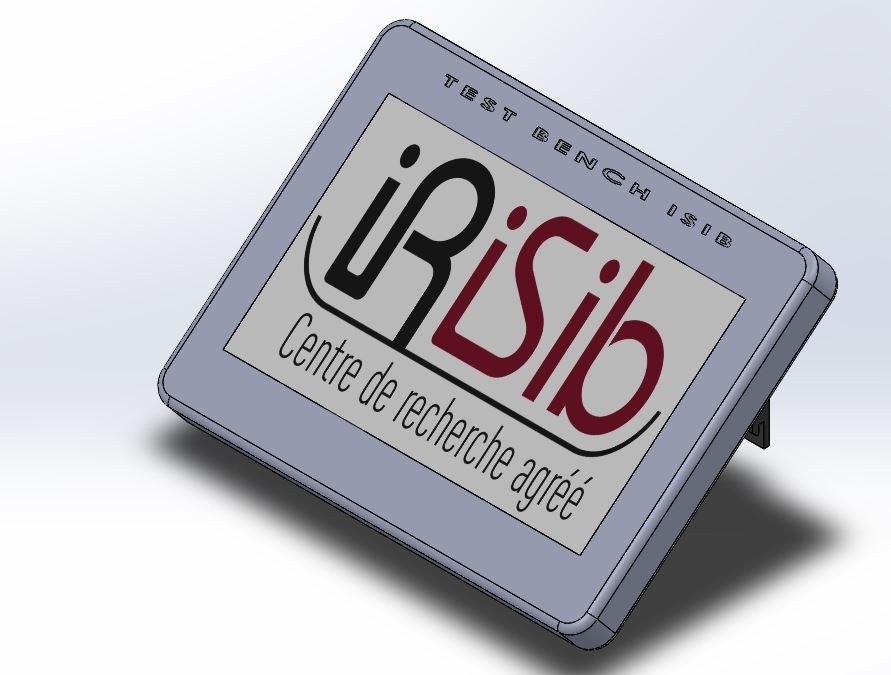
CAO/Rendering/PhotosAssemblageEcran/CompletAttache.JPG
