GeoffreyBultot/MotorTestBench-PBE/CAO/Rendering/PhotosAssemblageEcran/CompletAttacheDos.JPG

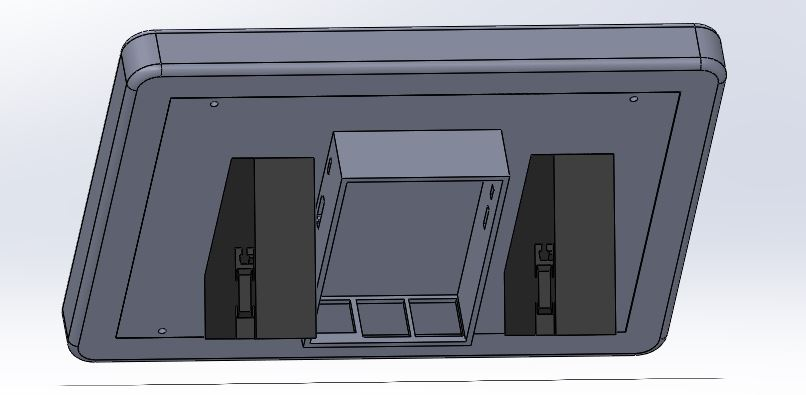
CAO/Rendering/PhotosAssemblageEcran/CompletAttacheDos.JPG
