GeoffreyBultot/MotorTestBench-PBE/CAO/Rendering/PhotosAssemblageEcran/FACEATTACHE.JPG

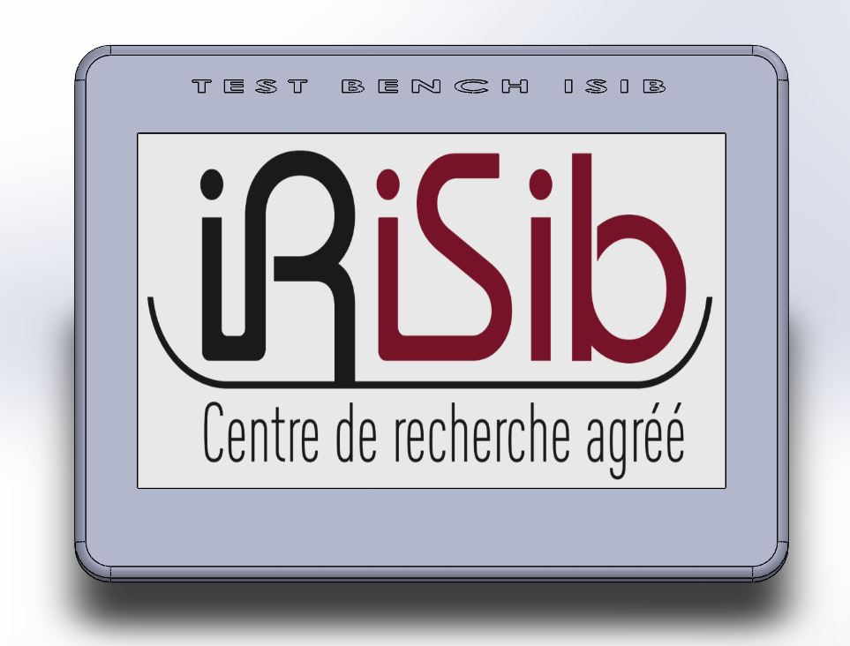
CAO/Rendering/PhotosAssemblageEcran/FACEATTACHE.JPG
