GeoffreyBultot/MotorTestBench-PBE/CAO/Rendering/PhotosAssemblageEcran/OrthoDetach.JPG

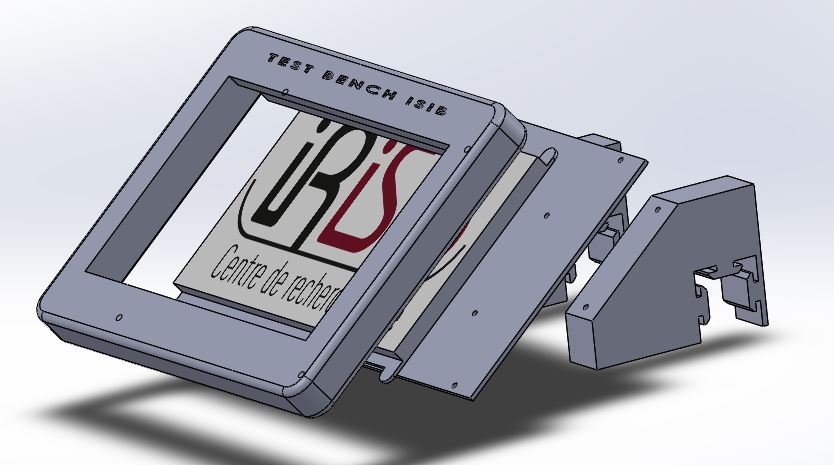
CAO/Rendering/PhotosAssemblageEcran/OrthoDetach.JPG
