GeoffreyBultot/MotorTestBench-PBE/CAO/Rendering/PhotosAssemblageEcran/ProfilDetache1.JPG

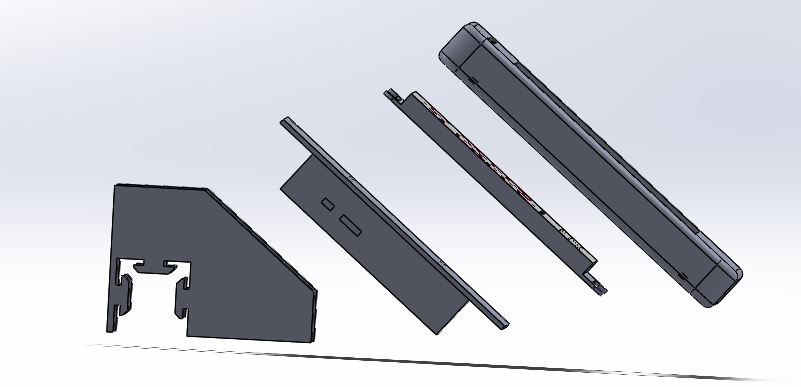
CAO/Rendering/PhotosAssemblageEcran/ProfilDetache1.JPG
