GeoffreyBultot/MotorTestBench-PBE/CAO/Rendering/PhotosAssemblageEcran/ProfilDetache2.JPG

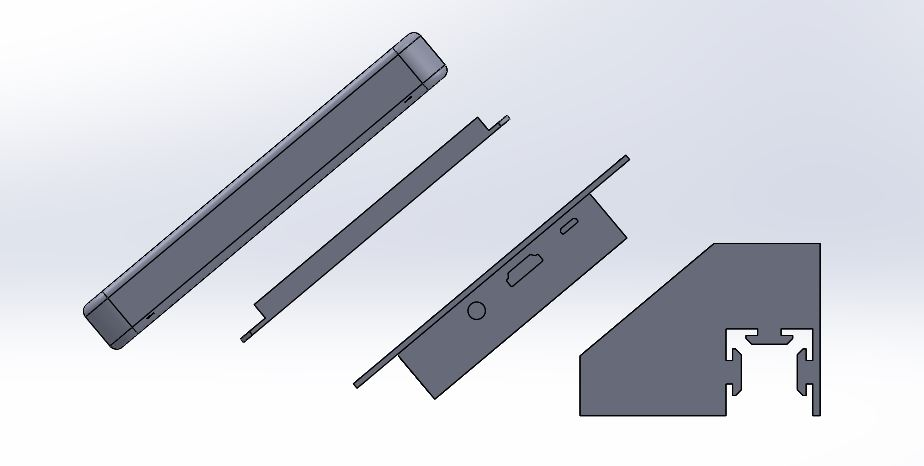
CAO/Rendering/PhotosAssemblageEcran/ProfilDetache2.JPG
