GeoffreyBultot/MotorTestBench-PBE/Simulations/Multisim/UC_Discover/test2/TEST.htm

# Static Call Graph for image D:\geoff\Documents\OneDrive - he2b.be\Ecole 2019 - 2020\Q2\Bureau_Etude\Simulations_prototypes\UC_Discover\test2\TEST.axf

#<CALLGRAPH># ARM Linker, RVCT4.0 [Build 728]: Last Updated: Fri Feb 21 17:38:38 2020

### Maximum Stack Usage = 8 bytes + Unknown(Functions without stacksize, Cycles, Untraceable Function Pointers)

### Call chain for Maximum Stack Depth:

__rt_lib_init ⇒ _fp_init

### Functions with no stack information

- __user_initial_stackheap

### Mutually Recursive functions

- NMI_Handler ⇒ NMI_Handler
- HardFault_Handler ⇒ HardFault_Handler
- MemManage_Handler ⇒ MemManage_Handler
- BusFault_Handler ⇒ BusFault_Handler
- UsageFault_Handler ⇒ UsageFault_Handler
- SVC_Handler ⇒ SVC_Handler
- DebugMon_Handler ⇒ DebugMon_Handler
- PendSV_Handler ⇒ PendSV_Handler
- SysTick_Handler ⇒ SysTick_Handler
- ADC_IRQHandler ⇒ ADC_IRQHandler

### Function Pointers

- Reset_Handler
- NMI_Handler
- HardFault_Handler
- MemManage_Handler
- BusFault_Handler
- UsageFault_Handler
- SVC_Handler
- DebugMon_Handler
- PendSV_Handler
- SysTick_Handler
- WWDG_IRQHandler
- PVD_IRQHandler
- TAMPER_IRQHandler
- RTC_IRQHandler
- FLASH_IRQHandler
- RCC_IRQHandler
- EXTI0_IRQHandler
- EXTI1_IRQHandler
- EXTI2_IRQHandler
- EXTI3_IRQHandler
- EXTI4_IRQHandler
- DMAChannel1_IRQHandler
- DMAChannel2_IRQHandler
- DMAChannel3_IRQHandler
- DMAChannel4_IRQHandler
- DMAChannel5_IRQHandler
- DMAChannel6_IRQHandler
- DMAChannel7_IRQHandler
- ADC_IRQHandler
- USB_HP_CAN_TX_IRQHandler
- USB_LP_CAN_RX0_IRQHandler
- CAN_RX1_IRQHandler
- CAN_SCE_IRQHandler
- EXTI9_5_IRQHandler
- TIM1_BRK_IRQHandler
- TIM1_UP_IRQHandler
- TIM1_TRG_COM_IRQHandler
- TIM1_CC_IRQHandler
- TIM2_IRQHandler
- TIM3_IRQHandler
- TIM4_IRQHandler
- I2C1_EV_IRQHandler
- I2C1_ER_IRQHandler
- I2C2_EV_IRQHandler
- I2C2_ER_IRQHandler
- SPI1_IRQHandler
- SPI2_IRQHandler
- USART1_IRQHandler
- USART2_IRQHandler
- USART3_IRQHandler
- EXTI15_10_IRQHandler
- RTCAlarm_IRQHandler
- USBWakeUp_IRQHandler
- __main
- __I$use$semihosting

### Global Symbols

__main (Thumb, 8 bytes, Stack size 0 bytes, __main.o(!!!main))

[Calls]

- >> __scatterload
- >> __rt_entry

__scatterload (Thumb, 0 bytes, Stack size unknown bytes, __scatter.o(!!!scatter))

[Called By]

- >> __main

__scatterload_rt2 (Thumb, 44 bytes, Stack size unknown bytes, __scatter.o(!!!scatter), UNUSED)

[Calls]

- >> __rt_entry

__scatterload_rt2_thumb_only (Thumb, 0 bytes, Stack size unknown bytes, __scatter.o(!!!scatter), UNUSED)

__scatterload_null (Thumb, 0 bytes, Stack size unknown bytes, __scatter.o(!!!scatter), UNUSED)

__scatterload_zeroinit (Thumb, 28 bytes, Stack size unknown bytes, __scatter_zi.o(!!handler_zi), UNUSED)

__rt_lib_init (Thumb, 0 bytes, Stack size unknown bytes, libinit.o(.ARM.Collect$$libinit$$00000000))

[Stack]

- Max Depth = 8 + Unknown Stack Size
- Call Chain = __rt_lib_init ⇒ _fp_init

[Calls]

- >> _fp_init

[Called By]

- >> __rt_entry_li

__rt_lib_init_alloca_1 (Thumb, 0 bytes, Stack size unknown bytes, libinit2.o(.ARM.Collect$$libinit$$0000002A))

__rt_lib_init_argv_1 (Thumb, 0 bytes, Stack size unknown bytes, libinit2.o(.ARM.Collect$$libinit$$00000028))

__rt_lib_init_atexit_1 (Thumb, 0 bytes, Stack size unknown bytes, libinit2.o(.ARM.Collect$$libinit$$00000017))

__rt_lib_init_clock_1 (Thumb, 0 bytes, Stack size unknown bytes, libinit2.o(.ARM.Collect$$libinit$$0000001D))

__rt_lib_init_cpp_1 (Thumb, 0 bytes, Stack size unknown bytes, libinit2.o(.ARM.Collect$$libinit$$0000002E))

__rt_lib_init_exceptions_1 (Thumb, 0 bytes, Stack size unknown bytes, libinit2.o(.ARM.Collect$$libinit$$0000002C))

__rt_lib_init_fp_trap_1 (Thumb, 0 bytes, Stack size unknown bytes, libinit2.o(.ARM.Collect$$libinit$$0000001B))

__rt_lib_init_getenv_1 (Thumb, 0 bytes, Stack size unknown bytes, libinit2.o(.ARM.Collect$$libinit$$0000001F))

__rt_lib_init_heap_1 (Thumb, 0 bytes, Stack size unknown bytes, libinit2.o(.ARM.Collect$$libinit$$00000006))

__rt_lib_init_lc_collate_1 (Thumb, 0 bytes, Stack size unknown bytes, libinit2.o(.ARM.Collect$$libinit$$0000000D))

__rt_lib_init_lc_ctype_1 (Thumb, 0 bytes, Stack size unknown bytes, libinit2.o(.ARM.Collect$$libinit$$0000000F))

__rt_lib_init_lc_monetary_1 (Thumb, 0 bytes, Stack size unknown bytes, libinit2.o(.ARM.Collect$$libinit$$00000011))

__rt_lib_init_lc_numeric_1 (Thumb, 0 bytes, Stack size unknown bytes, libinit2.o(.ARM.Collect$$libinit$$00000013))

__rt_lib_init_lc_time_1 (Thumb, 0 bytes, Stack size unknown bytes, libinit2.o(.ARM.Collect$$libinit$$00000015))

__rt_lib_init_rand_1 (Thumb, 0 bytes, Stack size unknown bytes, libinit2.o(.ARM.Collect$$libinit$$0000000A))

__rt_lib_init_return (Thumb, 0 bytes, Stack size unknown bytes, libinit2.o(.ARM.Collect$$libinit$$0000002F))

__rt_lib_init_signal_1 (Thumb, 0 bytes, Stack size unknown bytes, libinit2.o(.ARM.Collect$$libinit$$00000019))

__rt_lib_init_stdio_1 (Thumb, 0 bytes, Stack size unknown bytes, libinit2.o(.ARM.Collect$$libinit$$00000021))

__rt_lib_init_user_alloc_1 (Thumb, 0 bytes, Stack size unknown bytes, libinit2.o(.ARM.Collect$$libinit$$00000008))

__rt_lib_shutdown (Thumb, 0 bytes, Stack size unknown bytes, libshutdown.o(.ARM.Collect$$libshutdown$$00000000))

[Called By]

- >> __rt_exit_ls

__rt_lib_shutdown_fp_trap_1 (Thumb, 0 bytes, Stack size unknown bytes, libshutdown2.o(.ARM.Collect$$libshutdown$$00000006))

__rt_lib_shutdown_heap_1 (Thumb, 0 bytes, Stack size unknown bytes, libshutdown2.o(.ARM.Collect$$libshutdown$$0000000E))

__rt_lib_shutdown_return (Thumb, 0 bytes, Stack size unknown bytes, libshutdown2.o(.ARM.Collect$$libshutdown$$0000000F))

__rt_lib_shutdown_signal_1 (Thumb, 0 bytes, Stack size unknown bytes, libshutdown2.o(.ARM.Collect$$libshutdown$$00000009))

__rt_lib_shutdown_stdio_1 (Thumb, 0 bytes, Stack size unknown bytes, libshutdown2.o(.ARM.Collect$$libshutdown$$00000003))

__rt_lib_shutdown_user_alloc_1 (Thumb, 0 bytes, Stack size unknown bytes, libshutdown2.o(.ARM.Collect$$libshutdown$$0000000B))

__rt_entry (Thumb, 0 bytes, Stack size unknown bytes, rtentry.o(.ARM.Collect$$rtentry$$00000000))

[Called By]

- >> __scatterload_rt2
- >> __main

__rt_entry_presh_1 (Thumb, 0 bytes, Stack size unknown bytes, rtentry2.o(.ARM.Collect$$rtentry$$00000002))

__rt_entry_sh (Thumb, 0 bytes, Stack size unknown bytes, rtentry4.o(.ARM.Collect$$rtentry$$00000004))

[Stack]

- Max Depth = 8 + Unknown Stack Size
- Call Chain = __rt_entry_sh ⇒ __user_setup_stackheap

[Calls]

- >> __user_setup_stackheap

__rt_entry_li (Thumb, 0 bytes, Stack size unknown bytes, rtentry2.o(.ARM.Collect$$rtentry$$0000000A))

[Stack]

- Max Depth = 8 + Unknown Stack Size
- Call Chain = __rt_entry_li ⇒ __rt_lib_init ⇒ _fp_init

[Calls]

- >> __rt_lib_init

__rt_entry_postsh_1 (Thumb, 0 bytes, Stack size unknown bytes, rtentry2.o(.ARM.Collect$$rtentry$$00000009))

__rt_entry_main (Thumb, 0 bytes, Stack size unknown bytes, rtentry2.o(.ARM.Collect$$rtentry$$0000000D))

[Calls]

- >> exit
- >> main

__rt_entry_postli_1 (Thumb, 0 bytes, Stack size unknown bytes, rtentry2.o(.ARM.Collect$$rtentry$$0000000C))

__rt_exit (Thumb, 0 bytes, Stack size unknown bytes, rtexit.o(.ARM.Collect$$rtexit$$00000000))

[Called By]

- >> exit

__rt_exit_ls (Thumb, 0 bytes, Stack size unknown bytes, rtexit2.o(.ARM.Collect$$rtexit$$00000003))

[Calls]

- >> __rt_lib_shutdown

__rt_exit_prels_1 (Thumb, 0 bytes, Stack size unknown bytes, rtexit2.o(.ARM.Collect$$rtexit$$00000002))

__rt_exit_exit (Thumb, 0 bytes, Stack size unknown bytes, rtexit2.o(.ARM.Collect$$rtexit$$00000004))

[Calls]

- >> _sys_exit

Reset_Handler (Thumb, 4 bytes, Stack size 0 bytes, stm32f10x.o(.text))

NMI_Handler (Thumb, 2 bytes, Stack size 0 bytes, stm32f10x.o(.text))

[Calls]

- >> NMI_Handler

[Called By]

- >> NMI_Handler

[Address Reference Count : 1]

- stm32f10x.o(RESET)

HardFault_Handler (Thumb, 2 bytes, Stack size 0 bytes, stm32f10x.o(.text))

[Calls]

- >> HardFault_Handler

[Called By]

- >> HardFault_Handler

[Address Reference Count : 1]

- stm32f10x.o(RESET)

MemManage_Handler (Thumb, 2 bytes, Stack size 0 bytes, stm32f10x.o(.text))

[Calls]

- >> MemManage_Handler

[Called By]

- >> MemManage_Handler

[Address Reference Count : 1]

- stm32f10x.o(RESET)

BusFault_Handler (Thumb, 2 bytes, Stack size 0 bytes, stm32f10x.o(.text))

[Calls]

- >> BusFault_Handler

[Called By]

- >> BusFault_Handler

[Address Reference Count : 1]

- stm32f10x.o(RESET)

UsageFault_Handler (Thumb, 2 bytes, Stack size 0 bytes, stm32f10x.o(.text))

[Calls]

- >> UsageFault_Handler

[Called By]

- >> UsageFault_Handler

[Address Reference Count : 1]

- stm32f10x.o(RESET)

SVC_Handler (Thumb, 2 bytes, Stack size 0 bytes, stm32f10x.o(.text))

[Calls]

- >> SVC_Handler

[Called By]

- >> SVC_Handler

[Address Reference Count : 1]

- stm32f10x.o(RESET)

DebugMon_Handler (Thumb, 2 bytes, Stack size 0 bytes, stm32f10x.o(.text))

[Calls]

- >> DebugMon_Handler

[Called By]

- >> DebugMon_Handler

[Address Reference Count : 1]

- stm32f10x.o(RESET)

PendSV_Handler (Thumb, 2 bytes, Stack size 0 bytes, stm32f10x.o(.text))

[Calls]

- >> PendSV_Handler

[Called By]

- >> PendSV_Handler

[Address Reference Count : 1]

- stm32f10x.o(RESET)

SysTick_Handler (Thumb, 2 bytes, Stack size 0 bytes, stm32f10x.o(.text))

[Calls]

- >> SysTick_Handler

[Called By]

- >> SysTick_Handler

[Address Reference Count : 1]

- stm32f10x.o(RESET)

ADC_IRQHandler (Thumb, 0 bytes, Stack size 0 bytes, stm32f10x.o(.text))

[Calls]

- >> ADC_IRQHandler

[Called By]

- >> ADC_IRQHandler

[Address Reference Count : 1]

- stm32f10x.o(RESET)

CAN_RX1_IRQHandler (Thumb, 0 bytes, Stack size 0 bytes, stm32f10x.o(.text))
[Address Reference Count : 1]

- stm32f10x.o(RESET)

CAN_SCE_IRQHandler (Thumb, 0 bytes, Stack size 0 bytes, stm32f10x.o(.text))
[Address Reference Count : 1]

- stm32f10x.o(RESET)

DMAChannel1_IRQHandler (Thumb, 0 bytes, Stack size 0 bytes, stm32f10x.o(.text))
[Address Reference Count : 1]

- stm32f10x.o(RESET)

DMAChannel2_IRQHandler (Thumb, 0 bytes, Stack size 0 bytes, stm32f10x.o(.text))
[Address Reference Count : 1]

- stm32f10x.o(RESET)

DMAChannel3_IRQHandler (Thumb, 0 bytes, Stack size 0 bytes, stm32f10x.o(.text))
[Address Reference Count : 1]

- stm32f10x.o(RESET)

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

- stm32f10x.o(RESET)

USBWakeUp_IRQHandler (Thumb, 0 bytes, Stack size 0 bytes, stm32f10x.o(.text))
[Address Reference Count : 1]

- stm32f10x.o(RESET)

USB_HP_CAN_TX_IRQHandler (Thumb, 0 bytes, Stack size 0 bytes, stm32f10x.o(.text))
[Address Reference Count : 1]

- stm32f10x.o(RESET)

USB_LP_CAN_RX0_IRQHandler (Thumb, 0 bytes, Stack size 0 bytes, stm32f10x.o(.text))
[Address Reference Count : 1]

- stm32f10x.o(RESET)

WWDG_IRQHandler (Thumb, 0 bytes, Stack size 0 bytes, stm32f10x.o(.text))
[Address Reference Count : 1]

- stm32f10x.o(RESET)

__user_initial_stackheap (Thumb, 0 bytes, Stack size unknown bytes, stm32f10x.o(.text))

[Called By]

- >> __user_setup_stackheap

main (Thumb, 4 bytes, Stack size 0 bytes, main.o(.text))

[Called By]

- >> __rt_entry_main

__use_two_region_memory (Thumb, 2 bytes, Stack size 0 bytes, heapauxi.o(.text), UNUSED)

__rt_heap_escrow$2region (Thumb, 2 bytes, Stack size 0 bytes, heapauxi.o(.text), UNUSED)

__rt_heap_expand$2region (Thumb, 2 bytes, Stack size 0 bytes, heapauxi.o(.text), UNUSED)

__user_setup_stackheap (Thumb, 74 bytes, Stack size 8 bytes, sys_stackheap_outer.o(.text))

[Stack]

- Max Depth = 8 + Unknown Stack Size
- Call Chain = __user_setup_stackheap

[Calls]

- >> __user_perproc_libspace
- >> __user_initial_stackheap

[Called By]

- >> __rt_entry_sh

exit (Thumb, 12 bytes, Stack size 0 bytes, exit.o(.text))

[Calls]

- >> __rt_exit

[Called By]

- >> __rt_entry_main

__user_libspace (Thumb, 8 bytes, Stack size 0 bytes, libspace.o(.text), UNUSED)

__user_perproc_libspace (Thumb, 0 bytes, Stack size 0 bytes, libspace.o(.text))

[Called By]

- >> __user_setup_stackheap

__user_perthread_libspace (Thumb, 0 bytes, Stack size 0 bytes, libspace.o(.text), UNUSED)

__rt_fp_status_addr (Thumb, 12 bytes, Stack size 0 bytes, rt_fp_status_addr_intlibspace.o(.text))

[Called By]

- >> _fp_init

_sys_exit (Thumb, 16 bytes, Stack size 0 bytes, sys_exit.o(.text))

[Called By]

- >> __rt_exit_exit

__I$use$semihosting (Thumb, 0 bytes, Stack size 0 bytes, use_no_semi.o(.text))
[Address Reference Count : 1]

- sys_exit.o(.text)

__use_no_semihosting_swi (Thumb, 2 bytes, Stack size 0 bytes, use_no_semi.o(.text), UNUSED)

_fp_init (Thumb, 14 bytes, Stack size 8 bytes, fpinit.o(x$fpl$fpinit))

[Stack]

- Max Depth = 8
- Call Chain = _fp_init

[Calls]

- >> __rt_fp_status_addr

[Called By]

- >> __rt_lib_init

__fplib_config_pureend_doubles (Thumb, 0 bytes, Stack size unknown bytes, fpinit.o(x$fpl$fpinit), UNUSED)

### Local Symbols

### Undefined Global Symbols
