GeoffreyBultot/MotorTestBench-PBE/Codes/ApplicationRPI/DataTestOf_RH457SD1350_2020_3_30_21h_33m_5s.csv

=================Motor Informations=================
Name | RH-457SD-13150
Type | DC
UMotorMax | 24
IMotorMax | 0,6
PMotorMax | 100
SpeedMax | 4000
================Scenarios Informations================
U_MIN_TO_U_MAX | 0 | 23,9 | 0
==============================================
test: Umin =0,0to Umax 23,9
Setting | U [V] | v[tr/min] | I[A]
Set U = 0,0 | 0,15 | 0 | 0
Set U = 0,96 | 0,98 | 0 | 0,02
Set U = 1,92 | 1,97 | 0 | 0,04
Set U = 2,88 | 2,99 | 0 | 0,03
Set U = 3,84 | 3,9 | 0 | 0,03
Set U = 4,8 | 4,85 | 0 | 0,03
Set U = 5,76 | 5,87 | 0 | 0,03
Set U = 6,72 | 6,78 | 0 | 0,03
Set U = 7,68 | 7,61 | 0 | 0,03
Set U = 8,64 | 8,67 | 0 | 0,03
Set U = 9,6 | 9,66 | 0 | 0,03
Set U = 10,56 | 10,57 | 0 | 0,04
Set U = 11,52 | 11,55 | 0 | 0,03
Set U = 12,48 | 12,54 | 0 | 0,04
Set U = 13,44 | 13,52 | 0 | 0,04
Set U = 14,4 | 14,47 | 0 | 0,04
Set U = 15,36 | 15,38 | 0 | 0,04
Set U = 16,32 | 16,36 | 0 | 0,04
============================================================
