GeoffreyBultot/MotorTestBench-PBE/PCB/Motor_TestBenchV2/MotorTestBench/Bottom.png

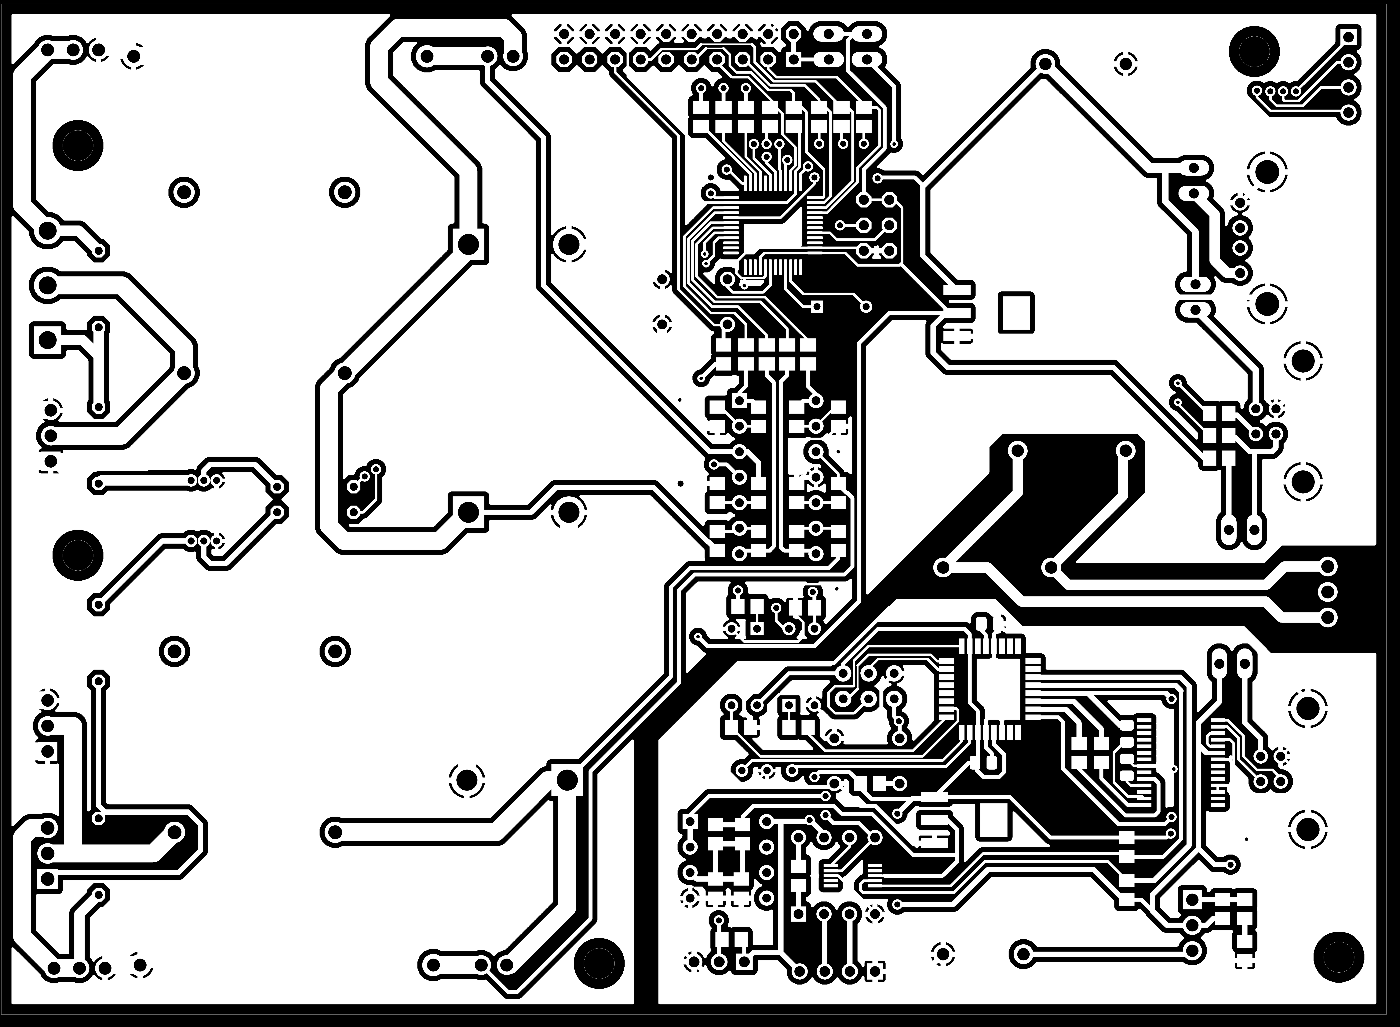
PCB/Motor_TestBenchV2/MotorTestBench/Bottom.png
