GeoffreyBultot/MotorTestBench-PBE/PCB/Motor_TestBenchV2/MotorTestBench/BottomPlacement.png

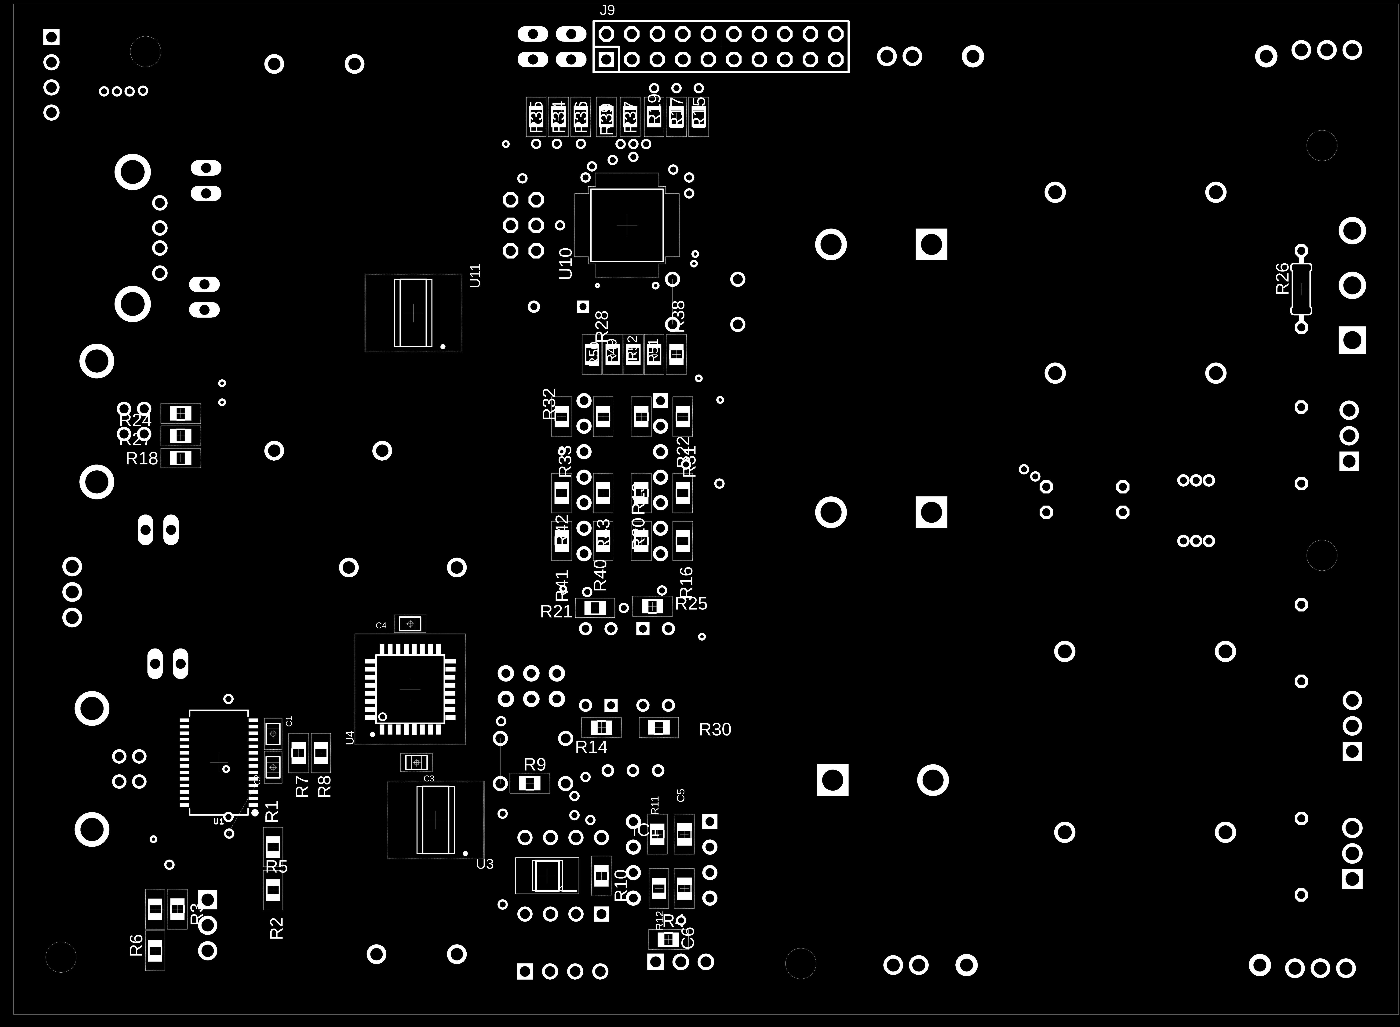
PCB/Motor_TestBenchV2/MotorTestBench/BottomPlacement.png
