GeoffreyBultot/MotorTestBench-PBE/PCB/Motor_TestBenchV2/MotorTestBench/Top.png

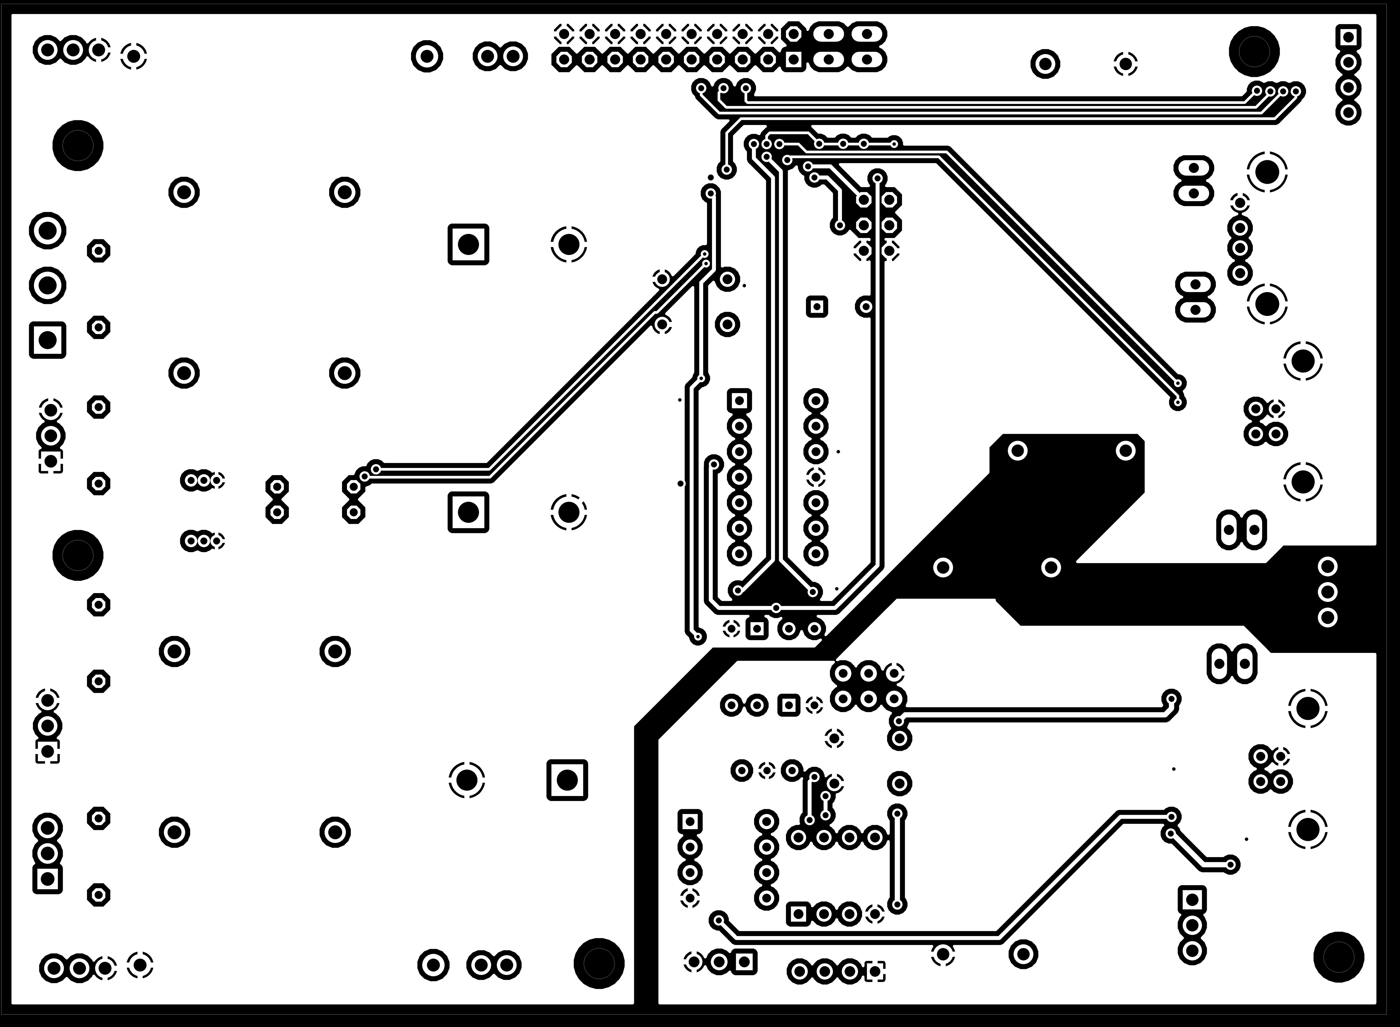
PCB/Motor_TestBenchV2/MotorTestBench/Top.png
