GeoffreyBultot/MotorTestBench-PBE/Schemas/Block_Diagram_V2_0.pdf

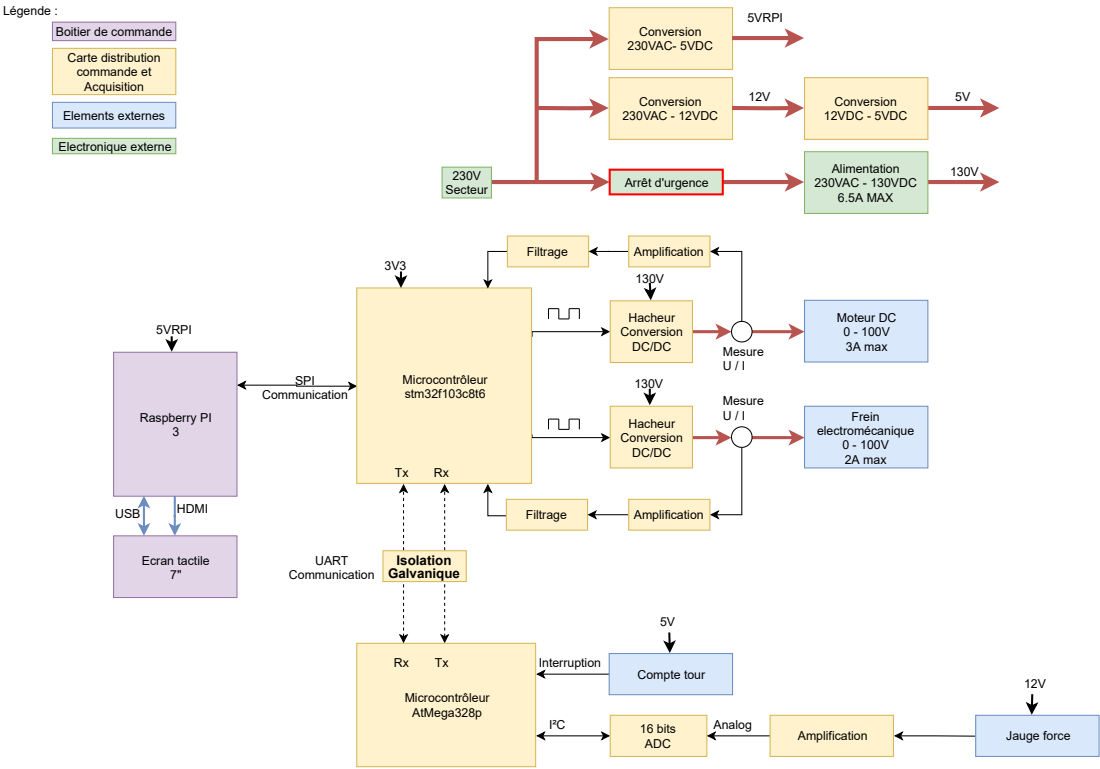
[picture p106: page 1]
Elements externes; Légende :; Electronique externe; Analog; Microcontrôleur stm32f103c8t6; Microcontrôleur AtMega328p; Compte tour; Jauge force; UART Communication; Ecran tactile 7"; Raspberry PI 3; HDMI USB; Alimentation 230VAC - 130VDC 6.5A MAX; Conversion 230VAC - 12VDC; Conversion 230VAC- 5VDC; 230V Secteur; Conversion 12VDC - 5VDC; 5VRPI; 16 bits; ADC; Amplification; Hacheur Conversion DC/DC; Moteur DC 0 - 100V 3A max; Frein electromécanique 0 - 100V 2A max; Mesure U / I; Filtrage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

Boitier de commande
Carte distribution
commande et
Acquisition
