GeoffreyBultot/MotorTestBench-PBE/Schemas/Câblage.pdf

# 7" screen

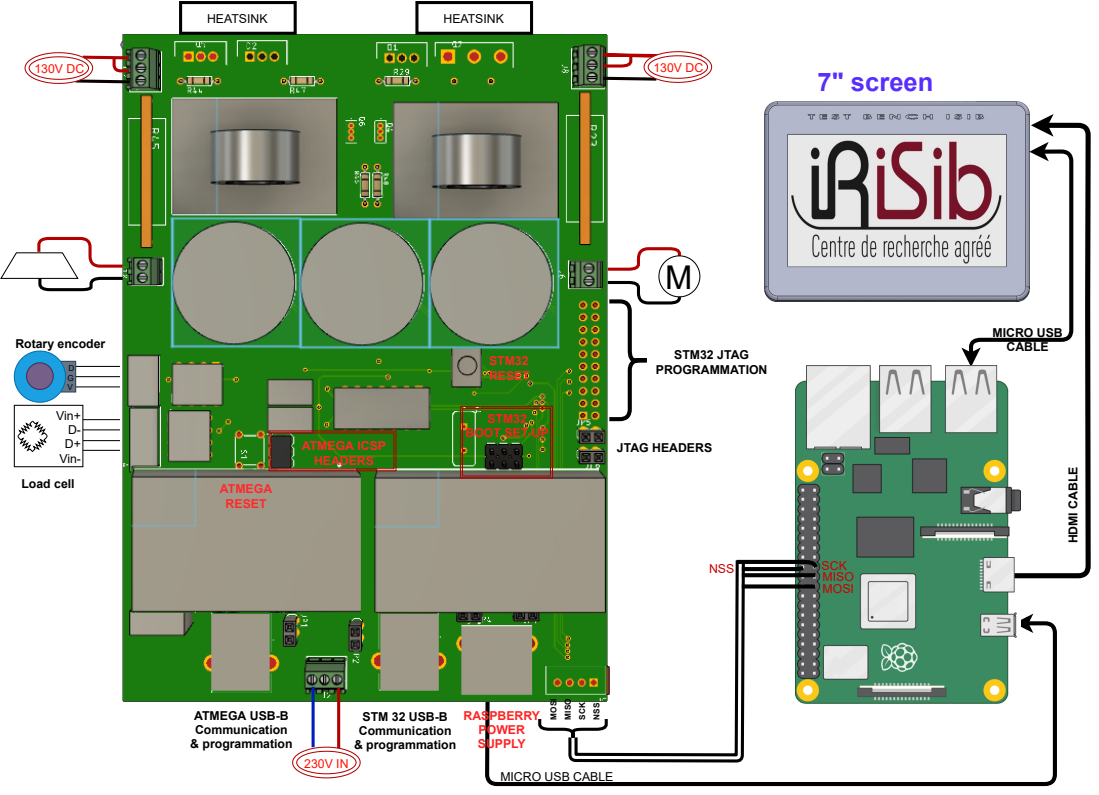
[picture p107: page 1]
Rotary encoder; Vin+ D- D+ Vin-; STM32 JTAG PROGRAMMATION; JTAG HEADERS; STM32 RESET; ATMEGA RESET; ATMEGA ICSP HEADERS; ATMEGA USB-B Communication & programmation; STM 32 USB-B Communication & programmation; RASPBERRY POWER SUPPLY; MOSI; MISO; SCK; NSS; MICRO USB CABLE; HDMI CABLE; HEATSINK; Load cell

STM32
BOOT SET-UP

MICRO USB CABLE
