GeoffreyBultot/MotorTestBench-PBE/Schemas/Principe_V_1_0.pdf

+12V

+

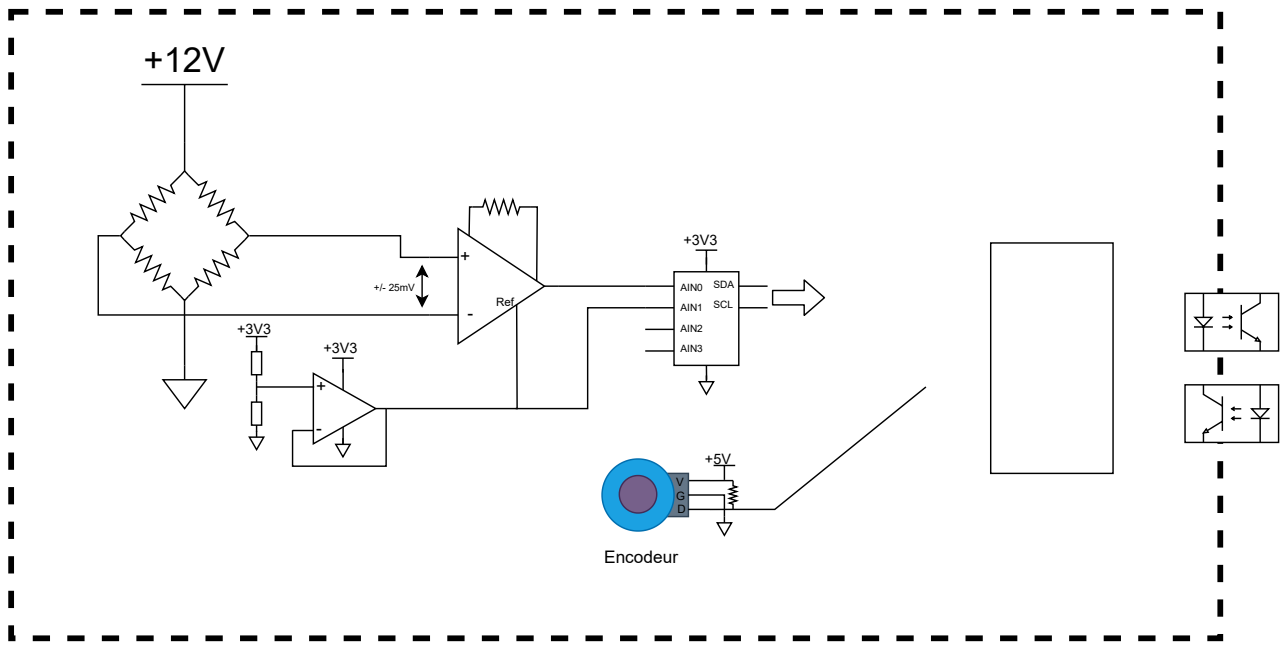
[picture p108: page 1]
Ref; SDA; SCL; AIN0; AIN1; AIN2; AIN3; Encodeur

M

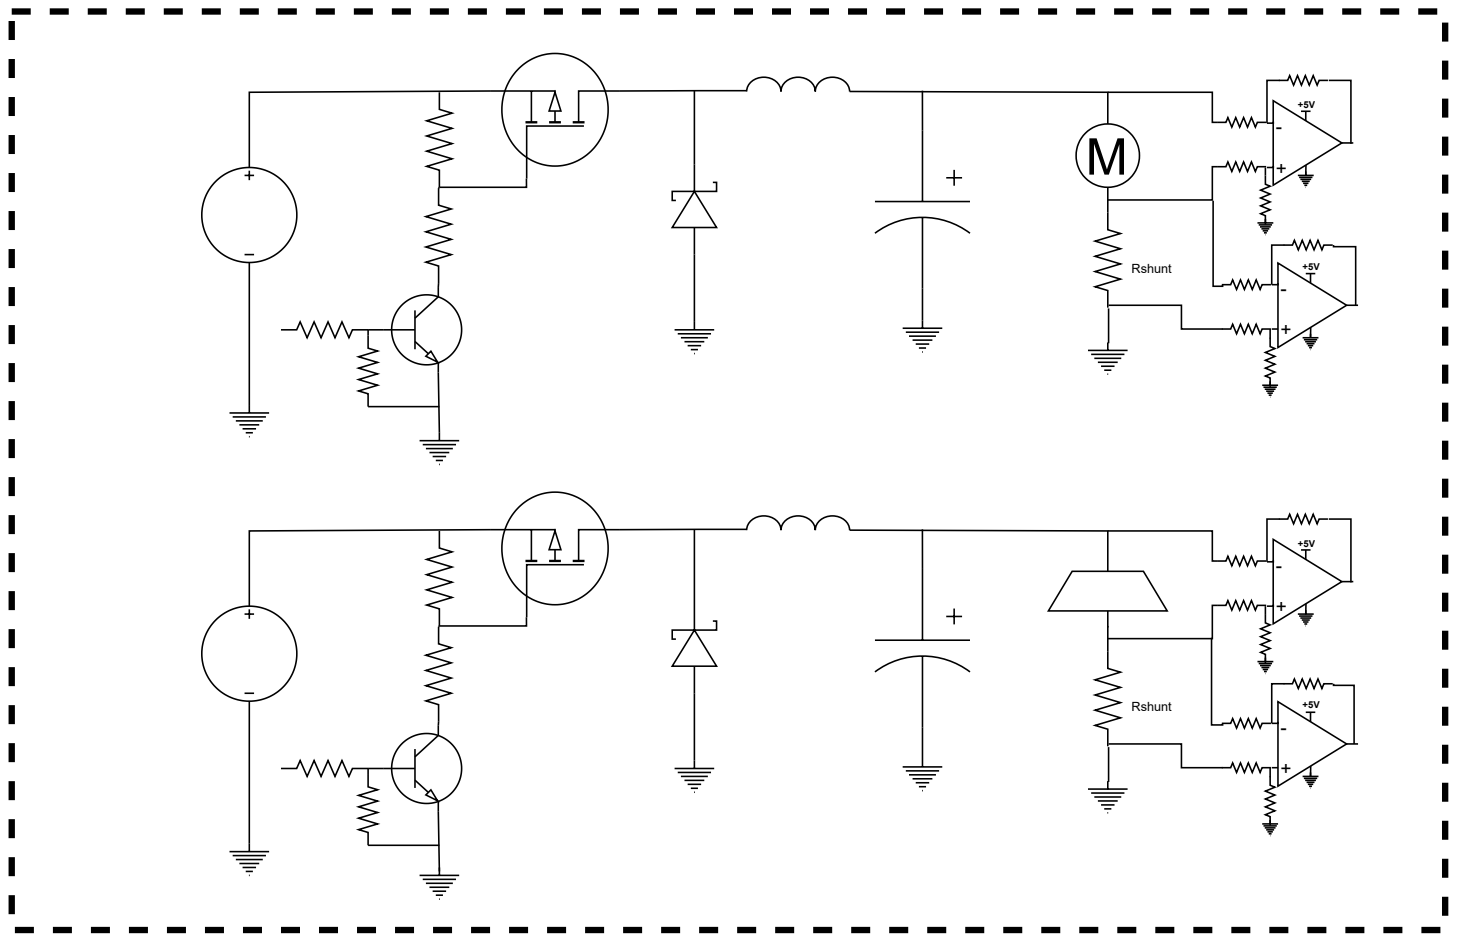
[picture p109: page 2]
Rshunt
