GeoffreyBultot/MotorTestBench-PBE/CAO/BANC_ESSAI_COMPLET.PDF

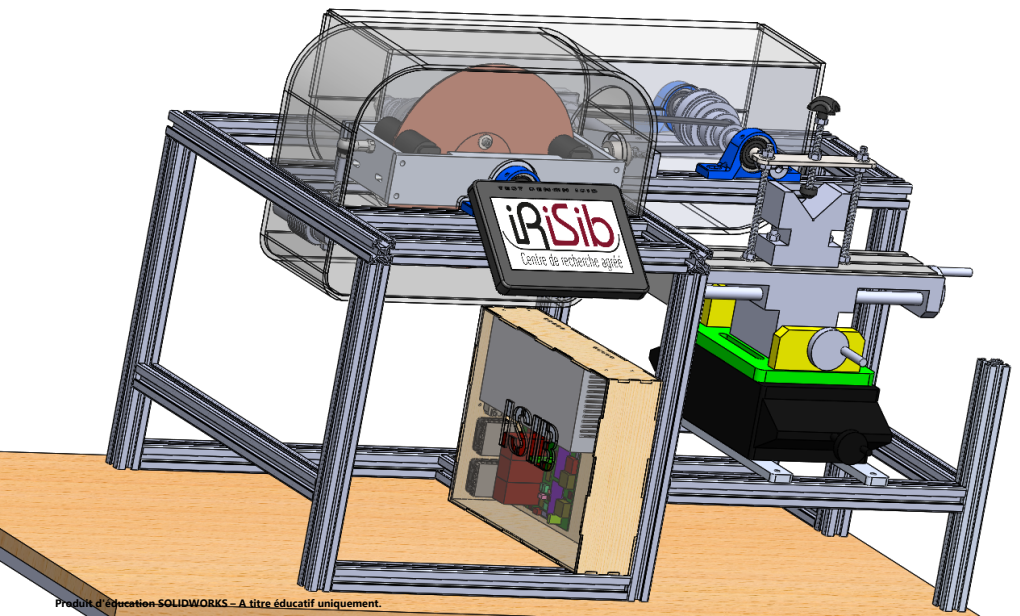
[picture p110: page 1]

Produit d'éducation SOLIDWORKS – A titre éducatif uniquement.
