GeoffreyBultot/MotorTestBench-PBE/(list of files, drawings)

Other design files:
Dimensionnement/Dimensionnement_Instru_Courant_Tension_Moteur.ms14
DocTech/Datasheets_Composants/Hacheur_Moteur_Frein/SpiceModel/IXTH10P50/IXTH10P50.OLB
DocTech/Datasheets_Composants/Mesures_Jauge_Contrainte/Spice model/AD623.OLB
PCB/Motor_TestBenchV2/MotorTestBench/Motor_Test_Bench_ONE_LAYER.pcb
Simulations/Multisim/Alimentation_Moteur/Circuit_Complet.ms14
Simulations/Multisim/Alimentation_Moteur/Complet_ET_Mesure.ms14
Simulations/Multisim/Alimentation_Moteur/Design1.ms14
Simulations/Multisim/Alimentation_Moteur/Essai_Sans_Decoupage.ms14
Simulations/Multisim/Alimentation_Moteur/Essai_TL783_LISSAGE.ms14
Simulations/Multisim/Alimentation_Moteur/Hacheur_AC_DC_ET_Hacheur_Serie.ms14
Simulations/Multisim/Alimentation_Moteur/Hacheur_Serie.ms14
Simulations/Multisim/Alimentation_Moteur/LOW_SIDE.ms14
Simulations/Multisim/Alimentation_Moteur/P_MOS.ms14
Simulations/Multisim/Alimentation_Moteur/Test_2mos.ms14
Simulations/Multisim/Alimentation_Moteur/Test_LOW_SIDE.dsn
Simulations/Multisim/Alimentation_Moteur/Test_LOW_SIDE.opj
Simulations/Multisim/Amplification_Instru_Jauge_Contrainte/Ampli_Instru_Premier_Proto.ms14
Simulations/Multisim/Amplification_Instru_Jauge_Contrainte/Changement_Masse.ms14
Simulations/Multisim/SchemaGeneralDivisionMasses.spl7
Simulations/Pspice/DESIGN1.DSN
Simulations/Pspice/Design1.opj
Simulations/Pspice/EssaisSimuPSPICE.dsn
Simulations/Pspice/EssaisSimuPSPICE.opj
