GeoffreyBultot/MotorTestBench-PBE/PCB/Motor_TestBenchV2/MotorTestBench/Motor_Test_Bench.brd

## EAGLE design PCB/Motor_TestBenchV2/MotorTestBench/Motor_Test_Bench.brd (2020-06-06)

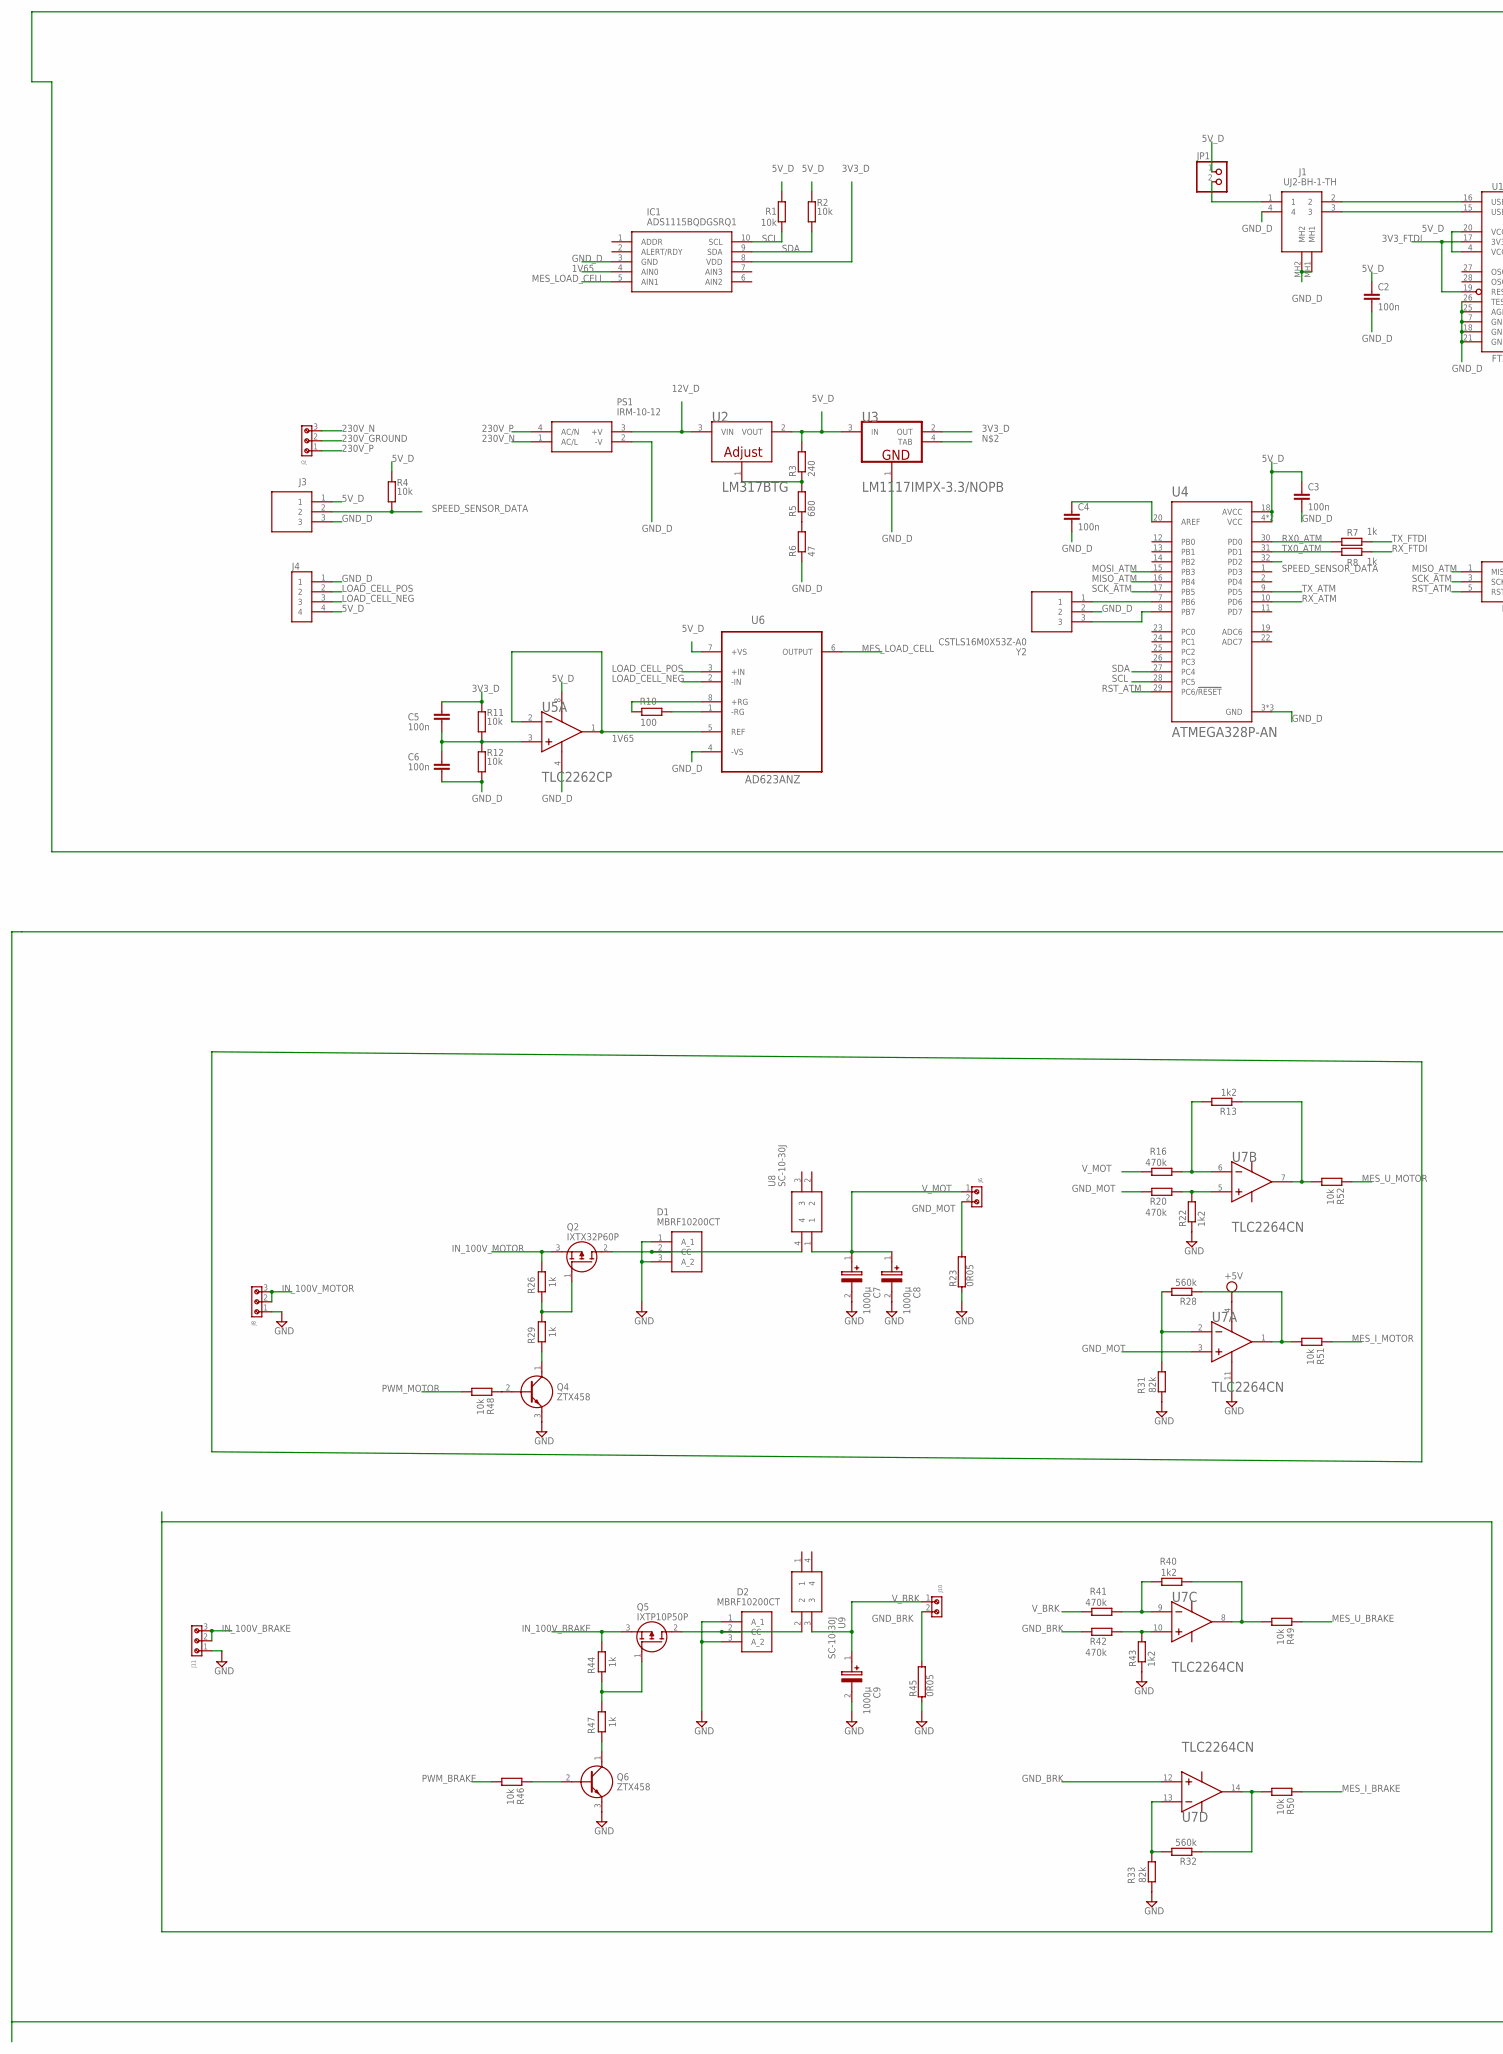
[picture p111: schematic Motor_Test_Bench.sch, part in row 1, column 1]

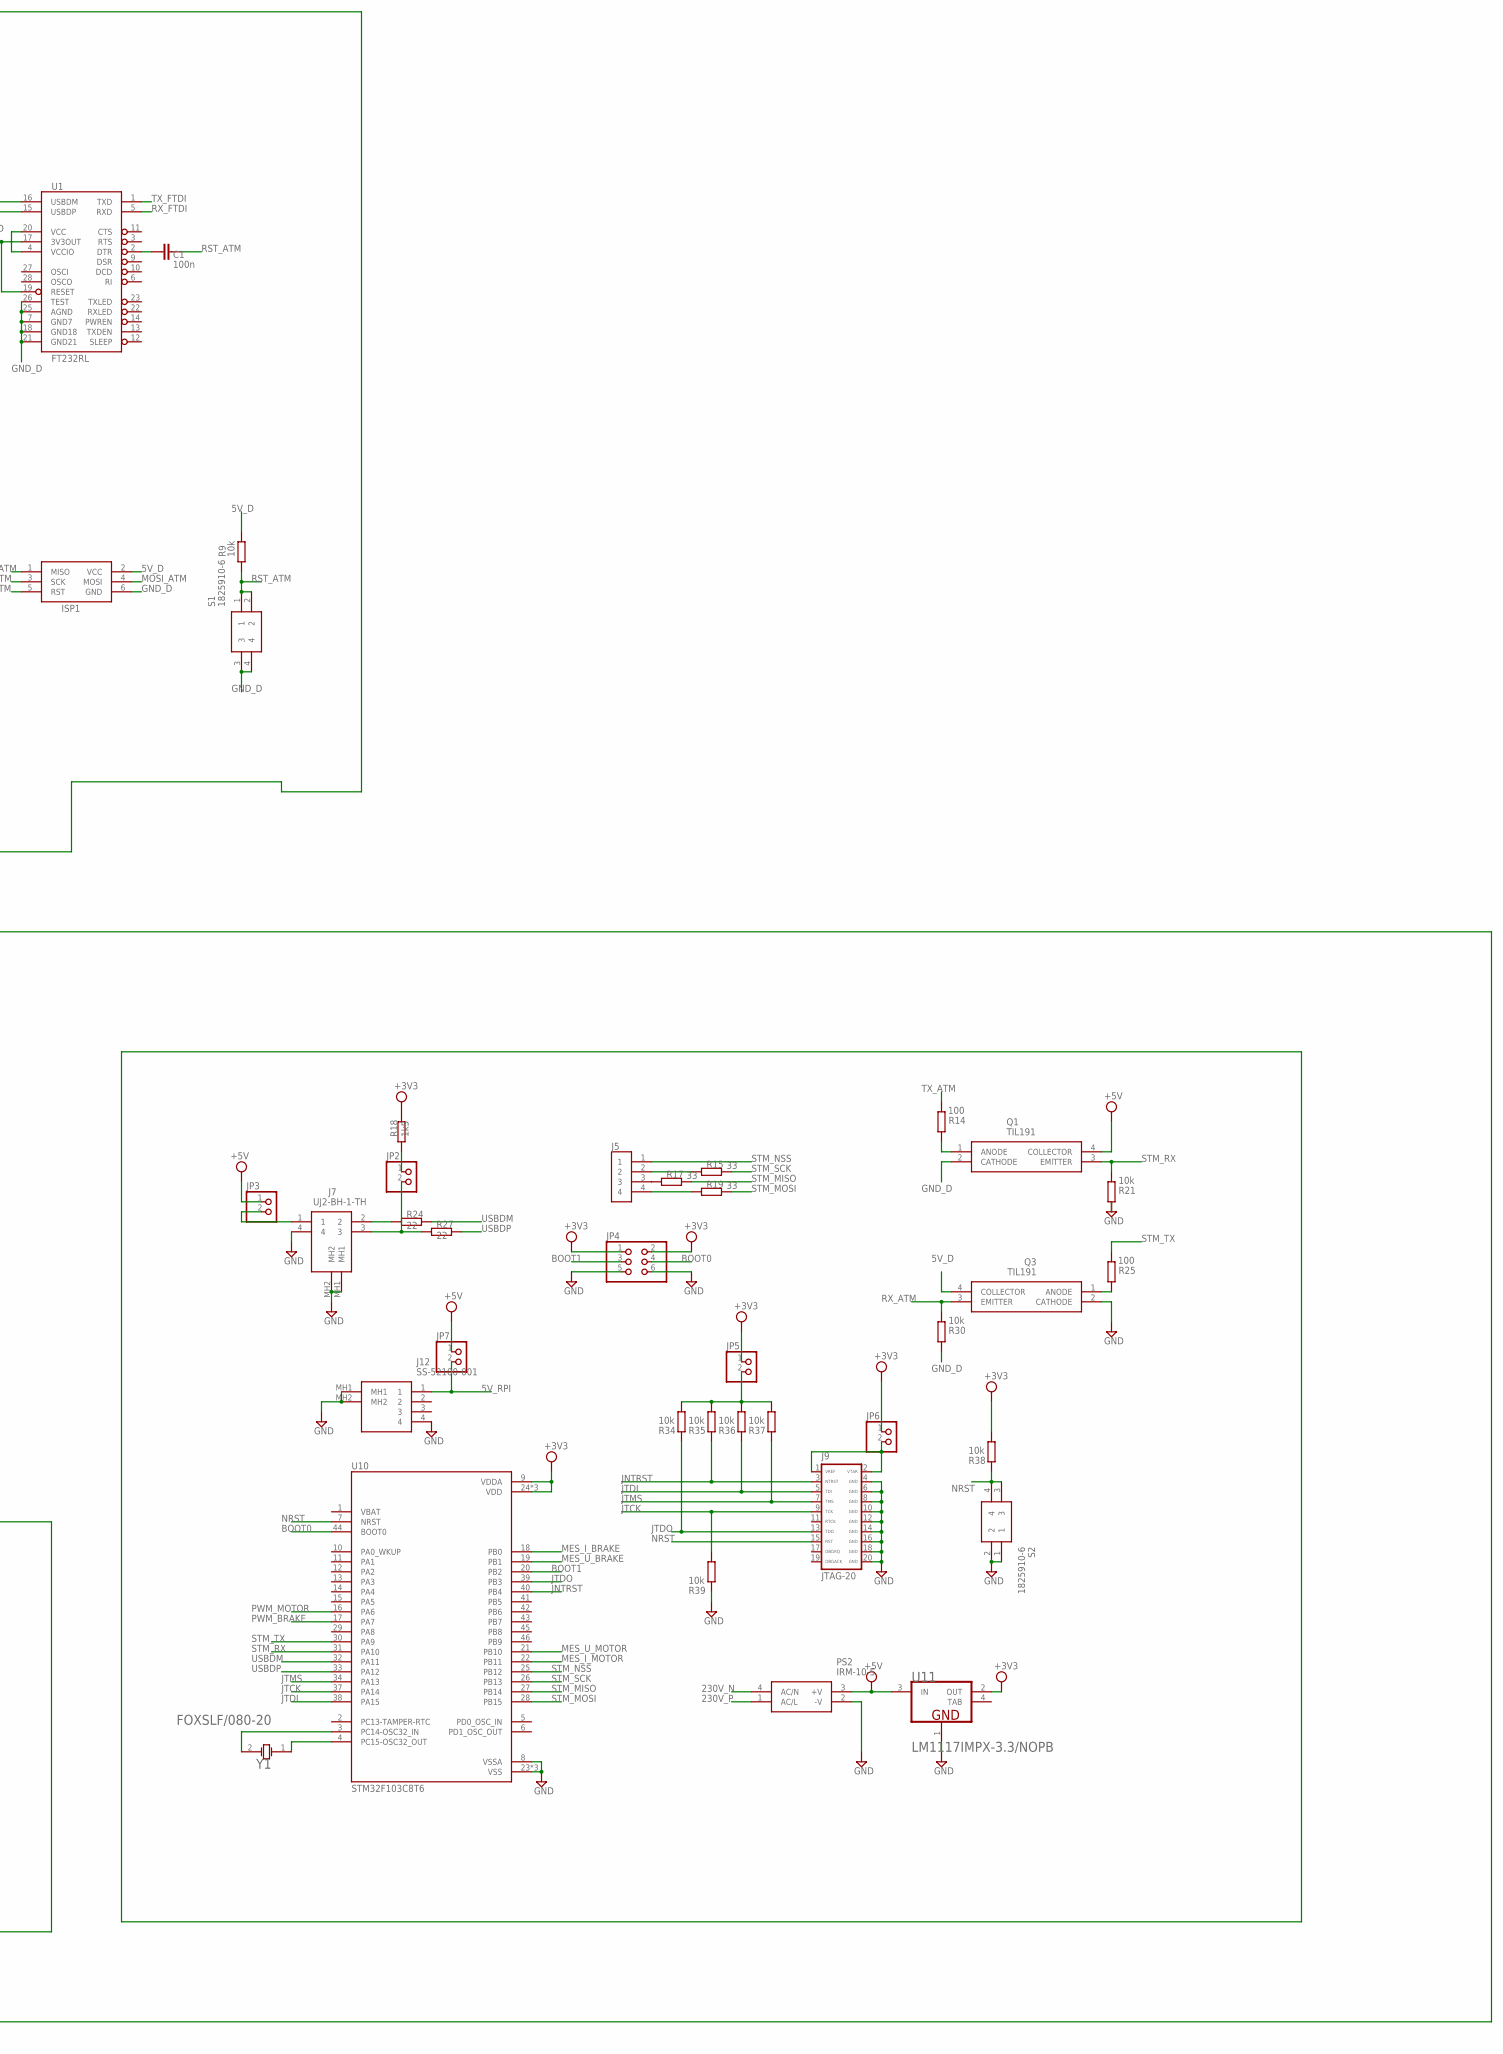
[picture p112: schematic Motor_Test_Bench.sch, part in row 1, column 2]

Parts:
C1, C2, C3, C4: 100n; CAP_0805
C5, C6: 100n; C0805
C7, C8, C9: 1000µ; SLPX102M200C4P3
D1, D2: MBRF10200CT; TO254P490X1000X2143-3P
IC1: ADS1115BQDGSRQ1; SOP50P490X110-10N
ISP1: AVRISP-6; AVRISP
J1, J7: UJ2-BH-1-TH; UJ2BH1TH
J2, J8, J11: 691210910003
J3: B3B-XH-A(LF)(SN); SHDR3W64P0X250_1X3_990X575X700
J4, J5: B4B-XH-A(LF)(SN); JST_B4B-XH-A(LF)(SN)
J6, J10: 691210910002
J9: JTAG-20
J12: SS-52100-001; SS52100001
JP1, JP2, JP3, JP5, JP6, JP7: PINHD-1X2; 1X02
JP4: PINHD-2X3; 2X03
PS1: IRM-10-12; IRM-10
PS2: IRM-10-5; IRM-10
Q1, Q3: TIL191; DIP762W58P254L450H584Q4N
Q2: IXTX32P60P; TO545P521X1594X2566-3P
Q4, Q6: ZTX458
Q5: IXTP10P50P; TO254P483X1028X1700-3P
R1, R2, R4, R9, R11, R12, R21, R30, R38: 10k; R0805
R3: 240; R0805
R5: 680; R0805
R6: 47; R0805
R7, R8: 1k; R0805
R10, R14, R25: 100; R0805
R13, R22, R40, R43: 1k2; R0805
R15, R17, R19: 33; M0805
R16, R20, R41, R42: 470k; R0805
R18: 1k5; R0805
R23, R45: 0R05; RS05_69-70
R24, R27: 22; R0805
R26, R29, R44, R47: 1k; 0204/7
R28, R32: 560k; R0805
R31, R33: 82k; R0805
R34, R35, R36, R37, R39, R49, R50, R51, R52: 10k; M0805
R46, R48: 10k; 0204/7
S1, S2: 1825910-6
U1: FT232RL; SSOP28DB
U2: ON_SEMI_LM317BTGON_SEMI_LM317BTG_0_0; ON_SEMI_LM317BTG_0
U3, U11: NATIONAL_SEMICONDUCTOR_LM1117IMPX-3.3-NOPBNATIONA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; NATIONAL_SEMICONDUCTOR_LM1117IMPX-3.3-NOPB_2
U4: ATMEGA328P-AN; QFP80P900X900X120-32N
U5: TEXAS_INSTRUMENTS_TLC2262CPTEXAS_INSTRUMENTS_TLC2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; TEXAS_INSTRUMENTS_TLC2262CP_0
U6: AD623ANZ; DIP254P762X533-8
U7: TEXAS_INSTRUMENTS_TLC2264CNTEXAS_INSTRUMENTS_TLC2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; TEXAS_INSTRUMENTS_TLC2264CN_0
U8, U9: SC-10-30J
U10: STM32F103C8T6; QFP50P900X900X160-48N
Y1: FOX_ELECTRONICS_FOXSLF-080-20FOX_ELECTRONICS_FOXS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; FOX_ELECTRONICS_FOXSLF-080-20_0
Y2: CSTLS16M0X53Z-A0; CSTLS16M0X53ZA0

Connections:
1V65: IC1.4 (AIN0), U5.1 (OUT1), U5.2 (IN1-), U6.5 (REF)
3V3_D: C5.1, IC1.8 (VDD), R11.1, U3.2 (OUT)
3V3_FTDI: U1.17 (3V3OUT), U1.19 (RESET)
5V_D: C2.1, C3.1, ISP1.2 (VCC), J3.1, J4.4, JP1.1, Q3.4 (COLLECTOR), R1.2, R2.2, R3.2, R4.1, R9.2, U1.4 (VCCIO), U1.20 (VCC), U2.2 (VOUT), U3.3 (IN), U4.4 (VCC), U4.6 (VCC), U4.18 (AVCC), U5.8 (VDD+), U6.7 (+VS)
5V_RPI: J12.1, JP7.2
12V_D: PS1.3 (+V), U2.3 (VIN)
230V_GROUND: J2.2
230V_N: J2.3, PS1.1 (AC/L), PS2.4 (AC/N)
230V_P: J2.1, PS1.4 (AC/N), PS2.1 (AC/L)
+3V3: JP4.1, JP4.2, JP5.1, JP6.1, R18.1, R38.2, U10.9 (VDDA), U10.24 (VDD), U10.36 (VDD), U10.48 (VDD), U11.2 (OUT)
+5V: JP3.1, JP7.1, PS2.3 (+V), Q1.4 (COLLECTOR), U7.4 (VDD+), U11.3 (IN)
BOOT0: JP4.4, U10.44 (BOOT0)
BOOT1: JP4.3, U10.20 (PB2)
GND: C7.2 (-), C8.2 (-), C9.2 (-), D1.1 (A_1), D1.3 (A_2), D2.1 (A_1), D2.3 (A_2), J7.4, J7.MH1, J7.MH2, J8.1, J9.4 (GND), J9.6 (GND), J9.8 (GND), J9.10 (GND), J9.12 (GND), J9.14 (GND), J9.16 (GND), J9.18 (GND), J9.20 (GND), J11.1, J12.4, J12.MH1, J12.MH2, JP4.5, JP4.6, PS2.2 (-V), Q3.2 (CATHODE), Q4.3 (C), Q6.3 (C), R21.1, R22.1, R23.1, R31.2, R33.2, R39.1, R43.1, R45.1, S2.1, S2.2, U7.11 (VDD-/GND), U10.8 (VSSA), U10.23 (VSS), U10.35 (VSS), U10.47 (VSS), U11.1 (GND)
GND_BRK: J10.2, R42.2, R45.2, U7.12 (IN4+)
GND_D: C2.2, C3.2, C4.2, C6.2, IC1.3 (GND), ISP1.6 (GND), J1.4, J1.MH1, J1.MH2, J3.3, J4.1, PS1.2 (-V), Q1.2 (CATHODE), R6.1, R12.2, R30.1, S1.3, S1.4, U1.7 (GND7), U1.18 (GND18), U1.21 (GND21), U1.25 (AGND), U1.26 (TEST), U3.1 (GND), U4.3 (GND), U4.5 (GND), U4.21 (GND), U5.4 (VDD-/GND), U6.4 (-VS), Y2.2
GND_MOT: J6.2, R20.2, R23.2, U7.3 (IN1+)
IN_100V_BRAKE: J11.2, J11.3, Q5.3 (S), R44.2
IN_100V_MOTOR: J8.2, J8.3, Q2.3 (S), R26.2
JNTRST: J9.3 (NTRST), R35.1, U10.40 (PB4)
JTCK: J9.9 (TCK), R39.2, U10.37 (PA14)
JTDI: J9.5 (TDI), R36.1, U10.38 (PA15)
JTDO: J9.13 (TDO), R34.1, U10.39 (PB3)
JTMS: J9.7 (TMS), R37.1, U10.34 (PA13)
LOAD_CELL_NEG: J4.3, U6.2 (-IN)
LOAD_CELL_POS: J4.2, U6.3 (+IN)
MES_I_BRAKE: R50.1, U10.18 (PB0)
MES_I_MOTOR: R51.1, U10.22 (PB11)
MES_LOAD_CELL: IC1.5 (AIN1), U6.6 (OUTPUT)
MES_U_BRAKE: R49.1, U10.19 (PB1)
MES_U_MOTOR: R52.1, U10.21 (PB10)
MISO_ATM: ISP1.1 (MISO), U4.16 (PB4)
MOSI_ATM: ISP1.4 (MOSI), U4.15 (PB3)
unnamed: D1.2 (CC), Q2.2 (D), U8.4
unnamed: R5.1, R6.2
unnamed: R3.1, R5.2, U2.1 (ADJUST)
unnamed: J7.2, R24.2
unnamed: J7.3, JP2.2, R27.2
unnamed: JP2.1, R18.2
unnamed: R28.2, R31.1, U7.2 (IN1-)
unnamed: Q2.1 (G), R26.1, R29.2
unnamed: Q4.1 (E), R29.1
unnamed: R13.2, R16.1, U7.6 (IN2-)
unnamed: R20.1, R22.2, U7.5 (IN2+)
unnamed: C1.2, U1.2 (DTR)
unnamed: C4.1, U4.20 (AREF)
unnamed: Q5.1 (G), R44.1, R47.2
unnamed: R32.2, R33.1, U7.13 (IN4-)
unnamed: Q6.2 (B), R46.1
unnamed: R42.1, R43.2, U7.10 (IN3+)
unnamed: R40.2, R41.1, U7.9 (IN3-)
unnamed: Q4.2 (B), R48.1
unnamed: Q6.1 (E), R47.1
unnamed: R28.1, R51.2, U7.1 (OUT1)
unnamed: J1.2, U1.16 (USBDM)
unnamed: R10.2, U6.1 (-RG)
unnamed: C5.2, C6.1, R11.2, R12.1, U5.3 (IN1+)
unnamed: R10.1, U6.8 (+RG)
unnamed: J1.3, U1.15 (USBDP)
unnamed: D2.2 (CC), Q5.2 (D), U9.2
unnamed: Q1.1 (ANODE), R14.1
unnamed: Q3.1 (ANODE), R25.1
unnamed: J7.1, JP3.2
unnamed: J9.1 (VREF), J9.2 (VTAR), JP6.2
unnamed: JP5.2, R34.2, R35.2, R36.2, R37.2
unnamed: J1.1, JP1.2
unnamed: J5.2, R15.2
unnamed: J5.3, R17.2
unnamed: J5.4, R19.2
unnamed: U10.4 (PC15-OSC32_OUT), Y1.1
unnamed: U10.3 (PC14-OSC32_IN), Y1.2
unnamed: R32.1, R50.2, U7.14 (OUT4)
unnamed: R40.1, R49.2, U7.8 (OUT3)
unnamed: R13.1, R52.2, U7.7 (OUT2)
unnamed: U4.7 (PB6), Y2.1
unnamed: U4.8 (PB7), Y2.3
NRST: J9.15 (RST), R38.1, S2.3, S2.4, U10.7 (NRST)
PWM_BRAKE: R46.2, U10.17 (PA7)
PWM_MOTOR: R48.2, U10.16 (PA6)
RST_ATM: C1.1, ISP1.5 (RST), R9.1, S1.1, S1.2, U4.29 (PC6/!RESET)
RX0_ATM: R7.1, U4.30 (PD0)
RX_ATM: Q3.3 (EMITTER), R30.2, U4.10 (PD6)
RX_FTDI: R8.2, U1.5 (RXD)
SCK_ATM: ISP1.3 (SCK), U4.17 (PB5)
SCL: IC1.10 (SCL), R1.1, U4.28 (PC5)
SDA: IC1.9 (SDA), R2.1, U4.27 (PC4)
SPEED_SENSOR_DATA: J3.2, R4.2, U4.32 (PD2)
STM_MISO: R17.1, U10.27 (PB14)
STM_MOSI: R19.1, U10.28 (PB15)
STM_NSS: J5.1, U10.25 (PB12)
STM_RX: Q1.3 (EMITTER), R21.2, U10.31 (PA10)
STM_SCK: R15.1, U10.26 (PB13)
STM_TX: R25.2, U10.30 (PA9)
TAB: U11.4 (TAB)
TX0_ATM: R8.1, U4.31 (PD1)
TX_ATM: R14.2, U4.9 (PD5)
TX_FTDI: R7.2, U1.1 (TXD)
USBDM: R24.1, U10.32 (PA11)
USBDP: R27.1, U10.33 (PA12)
V_BRK: C9.1 (+), J10.1, R41.2, U9.3
V_MOT: C7.1 (+), C8.1 (+), J6.1, R16.2, U8.1

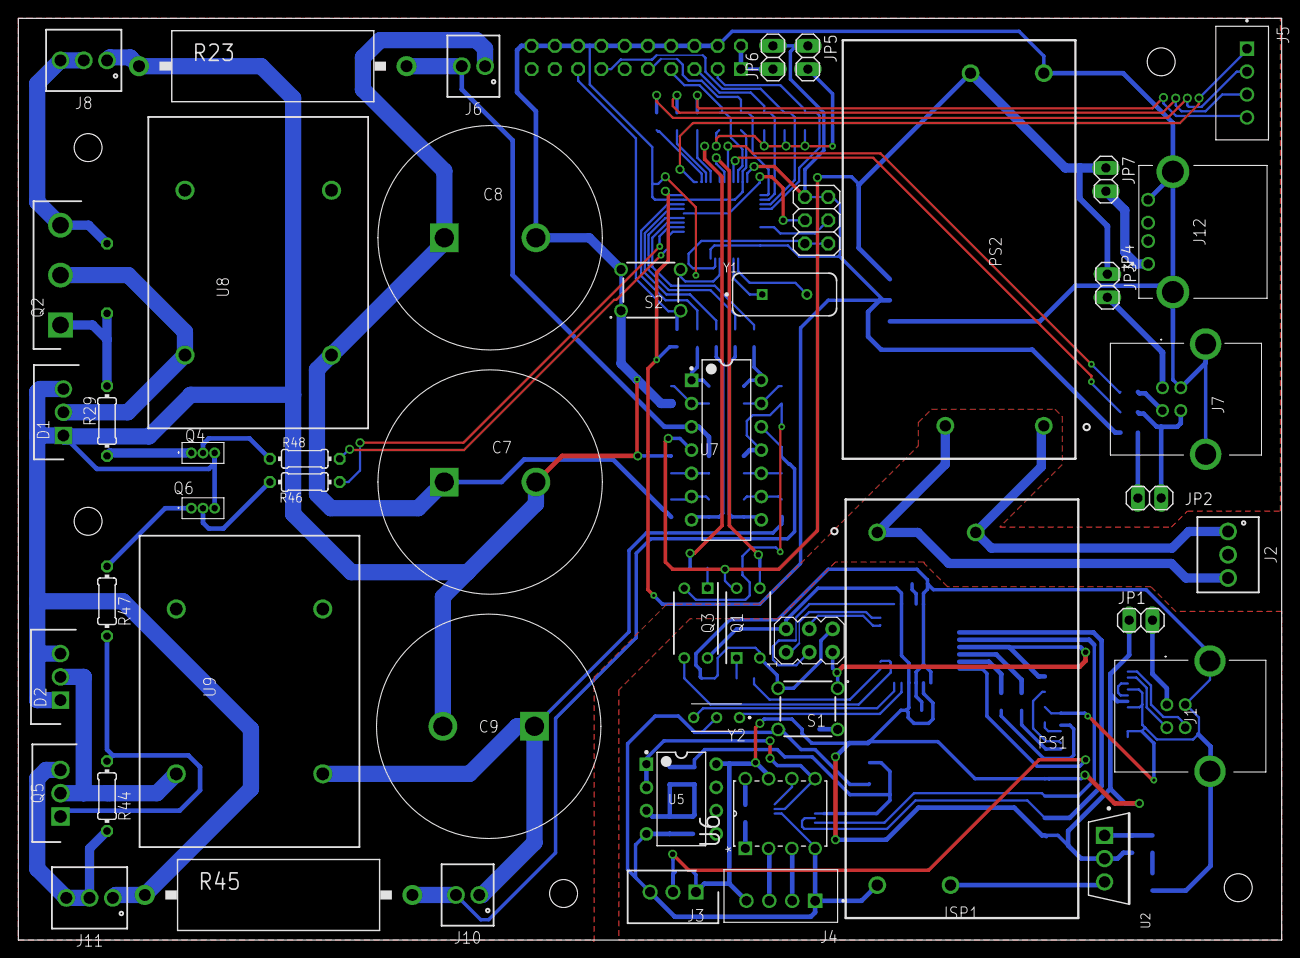
[picture p113: board Motor_Test_Bench.brd from above]

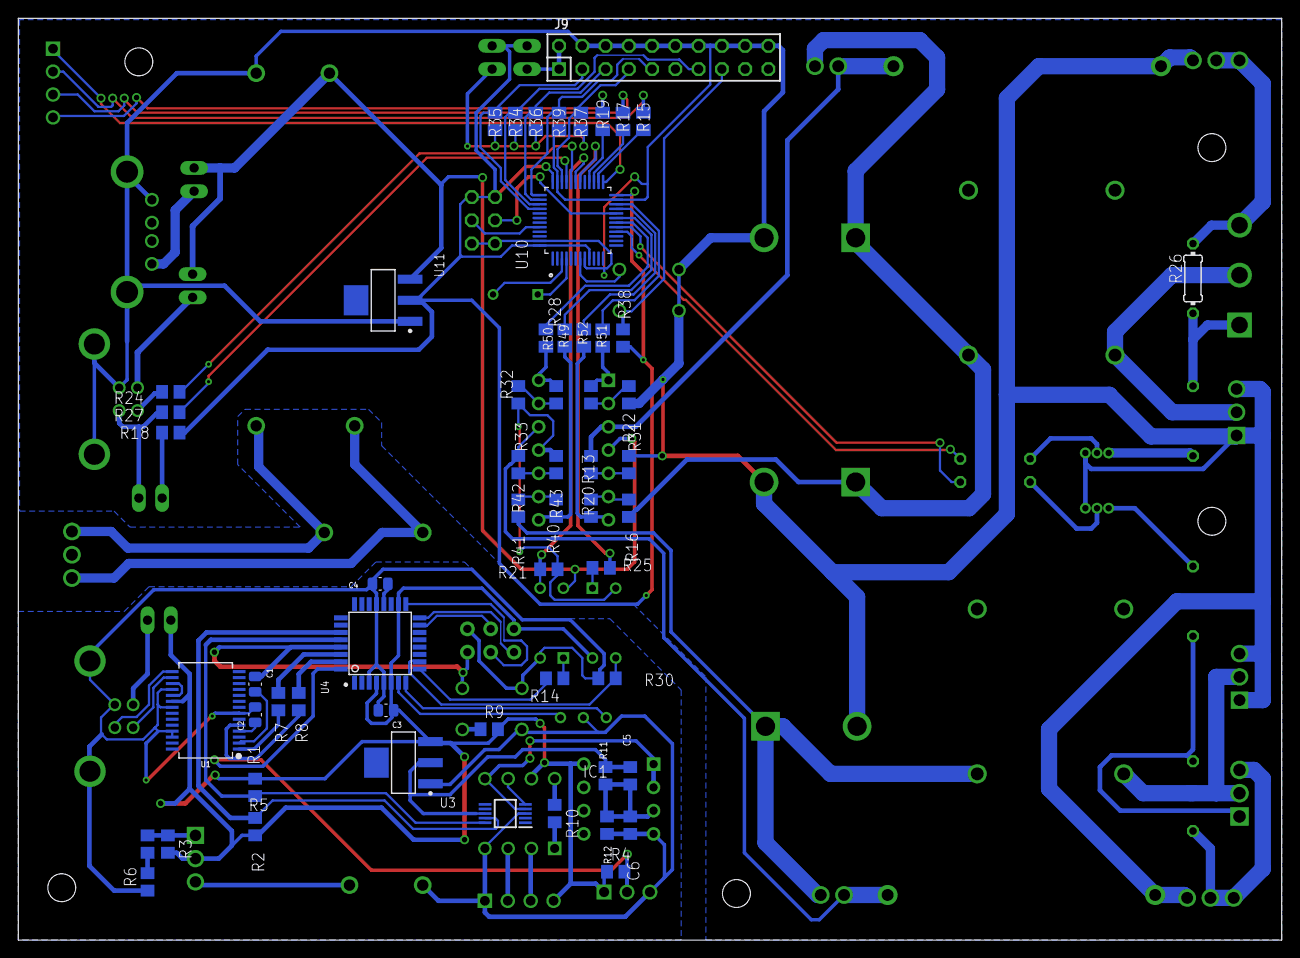
[picture p114: board Motor_Test_Bench.brd from below]

Board: 2 copper layers, 137.9 x 100.6 mm, 107 parts (58 on the bottom side), 99 nets.
