GeoffreyBultot/MotorTestBench-PBE/PCB/Motor_TestBenchV2/MotorTestBench/Motor_Test_Bench_ONE_LAYER.brd

## EAGLE design PCB/Motor_TestBenchV2/MotorTestBench/Motor_Test_Bench_ONE_LAYER.brd (2020-06-06)

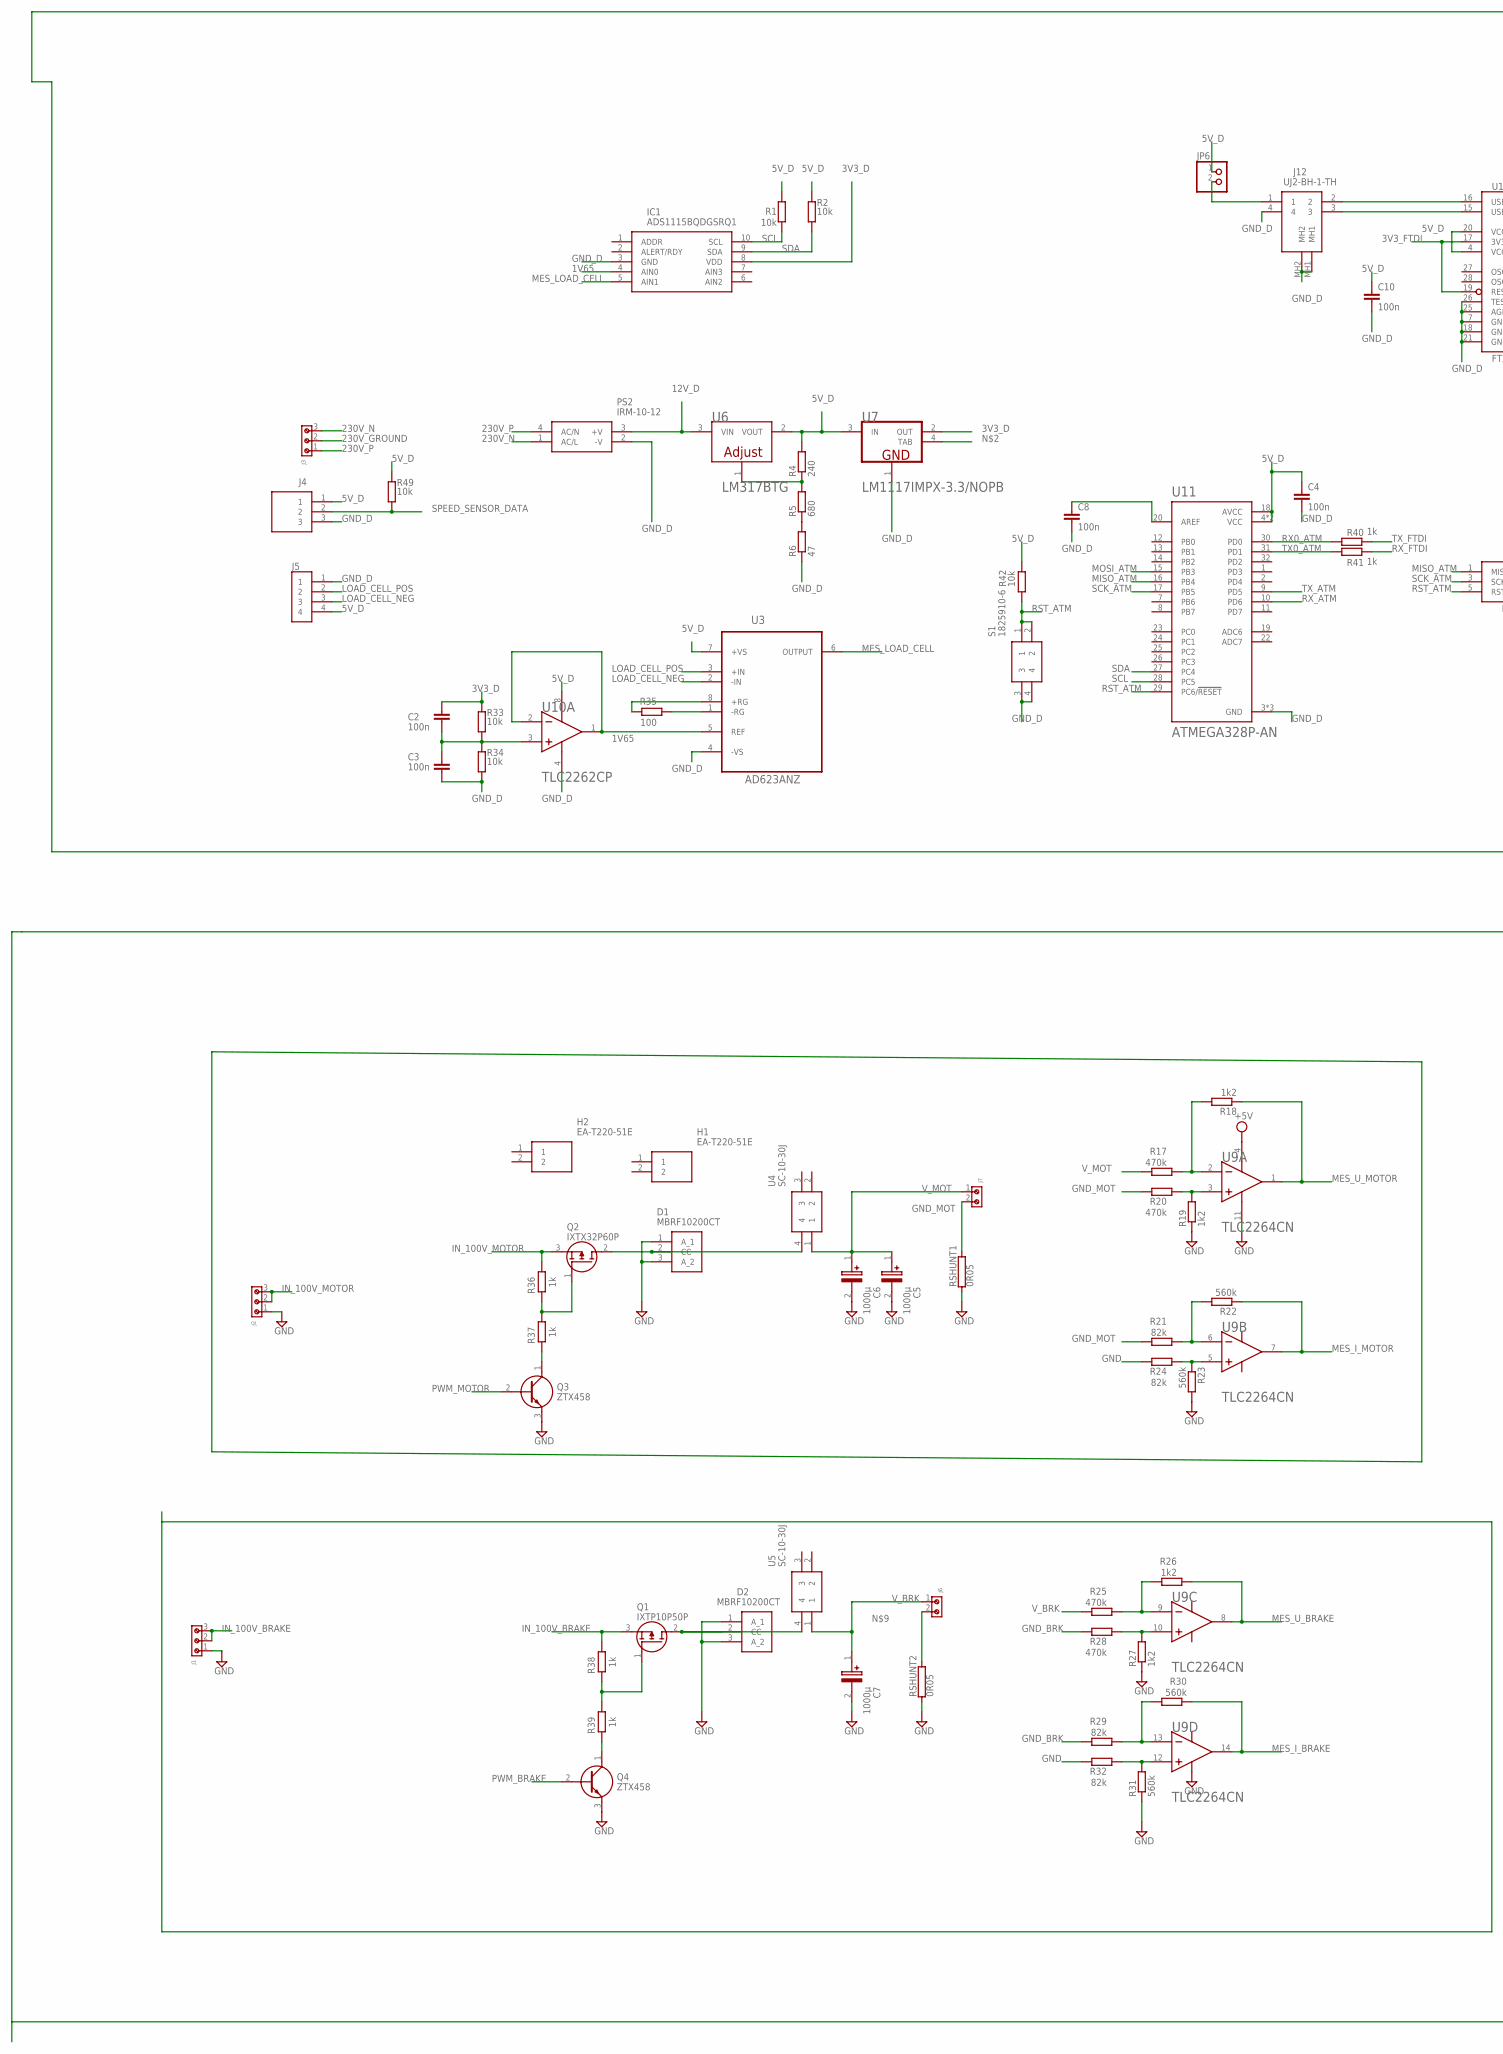
[picture p115: schematic Motor_Test_Bench_ONE_LAYER.sch, part in row 1, column 1]

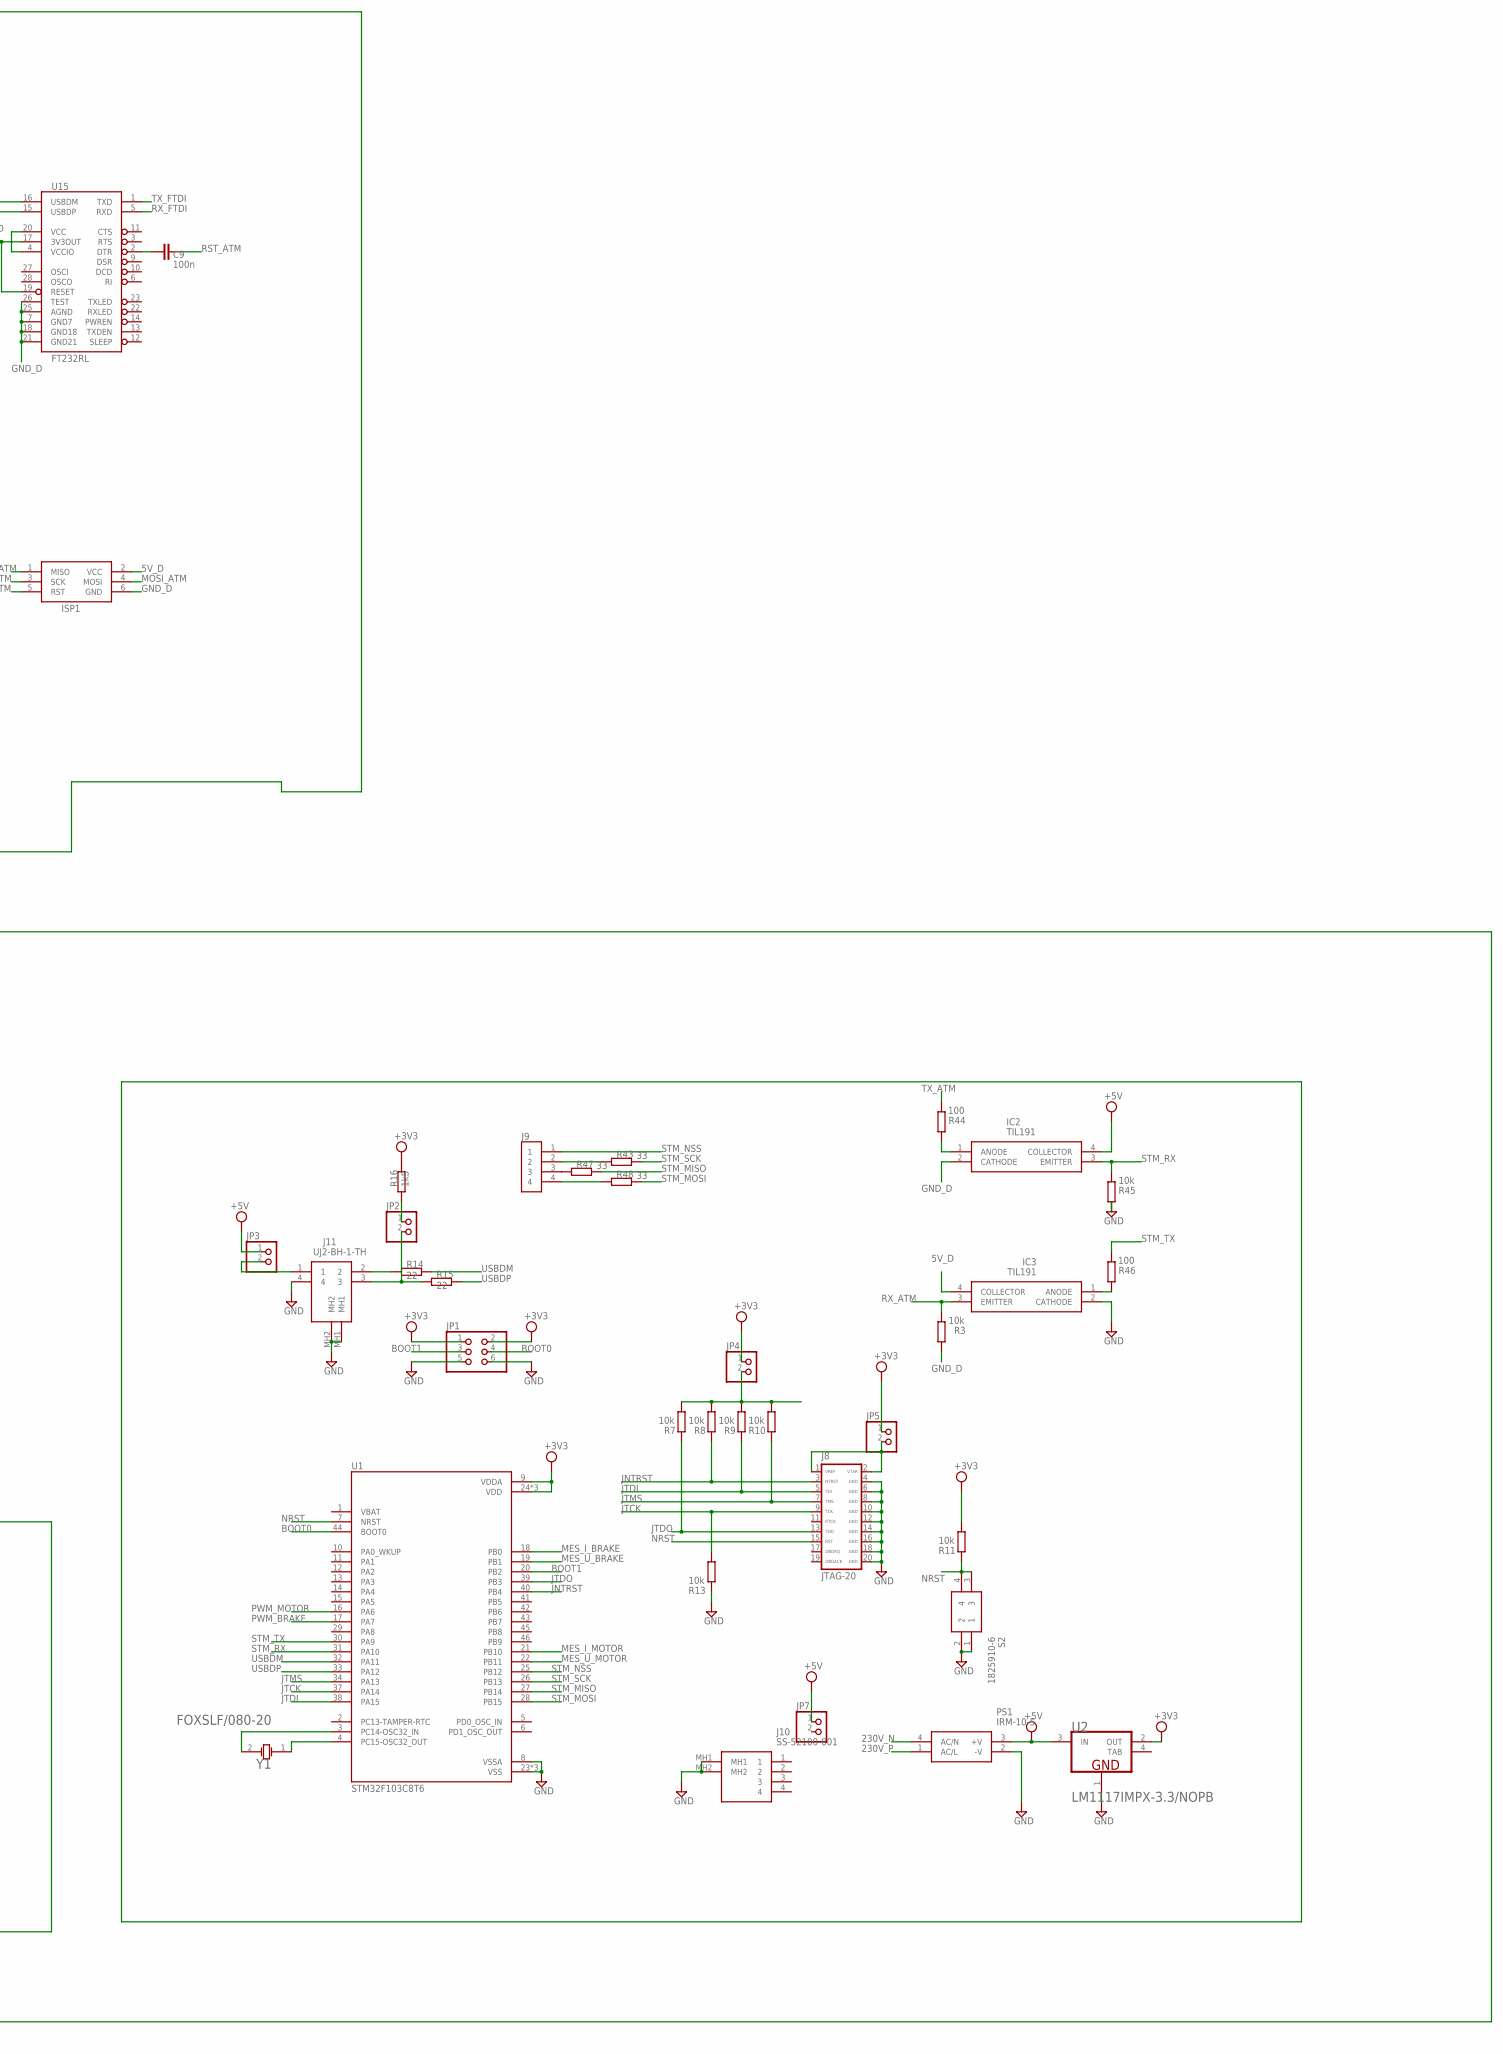
[picture p116: schematic Motor_Test_Bench_ONE_LAYER.sch, part in row 1, column 2]

Parts:
C2, C3: 100n; C0805
C4, C8, C9, C10: 100n; CAP_0805
C5, C6, C7: 1000µ; SLPX102M200C4P3
D1, D2: MBRF10200CT; TO254P490X1000X2143-3P
H1, H2: EA-T220-51E; EAT22051E
IC1: ADS1115BQDGSRQ1; SOP50P490X110-10N
IC2, IC3: TIL191; DIP762W58P254L450H584Q4N
ISP1: AVRISP-6; AVRISP
J1, J2, J3: 691210910003
J4: B3B-XH-A(LF)(SN); SHDR3W64P0X250_1X3_990X575X700
J5, J9: B4B-XH-A(LF)(SN); JST_B4B-XH-A(LF)(SN)
J6, J7: 691210910002
J8: JTAG-20
J10: SS-52100-001; SS52100001
J11, J12: UJ2-BH-1-TH; UJ2BH1TH
JP1: PINHD-2X3; 2X03
JP2, JP3, JP4, JP5, JP6, JP7: PINHD-1X2; 1X02
PS1: IRM-10-5; IRM-10
PS2: IRM-10-12; IRM-10
Q1: IXTP10P50P; TO254P483X1028X1700-3P
Q2: IXTX32P60P; TO545P521X1594X2566-3P
Q3, Q4: ZTX458
R1, R2, R3, R7, R8, R9, R10, R11, R13, R33, R34, R42, R45, R49: 10k; R0805
R4: 240; R0805
R5: 680; R0805
R6: 47; R0805
R14, R15: 22; R0805
R16: 1k5; R0805
R17, R20, R25, R28: 470k; R0805
R18, R19, R26, R27: 1k2; R0805
R21, R24, R29, R32: 82k; R0805
R22, R23, R30, R31: 560k; R0805
R35, R44, R46: 100; R0805
R36, R37, R38, R39, R40, R41: 1k; R0805
R43, R47, R48: 33; R0805
RSHUNT1, RSHUNT2: 0R05; RS05_69-70
S1, S2: 1825910-6
U1: STM32F103C8T6; QFP50P900X900X160-48N
U2, U7: NATIONAL_SEMICONDUCTOR_LM1117IMPX-3.3-NOPBNATIONA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; NATIONAL_SEMICONDUCTOR_LM1117IMPX-3.3-NOPB_2
U3: AD623ANZ; DIP254P762X533-8
U4, U5: SC-10-30J
U6: ON_SEMI_LM317BTGON_SEMI_LM317BTG_0_0; ON_SEMI_LM317BTG_0
U9: TEXAS_INSTRUMENTS_TLC2264CNTEXAS_INSTRUMENTS_TLC2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; TEXAS_INSTRUMENTS_TLC2264CN_0
U10: TEXAS_INSTRUMENTS_TLC2262CPTEXAS_INSTRUMENTS_TLC2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; TEXAS_INSTRUMENTS_TLC2262CP_0
U11: ATMEGA328P-AN; QFP80P900X900X120-32N
U15: FT232RL; SSOP28DB
Y1: FOX_ELECTRONICS_FOXSLF-080-20FOX_ELECTRONICS_FOXS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; FOX_ELECTRONICS_FOXSLF-080-20_0

Connections:
1V65: IC1.4 (AIN0), U3.5 (REF), U10.1 (OUT1), U10.2 (IN1-)
3V3_D: C2.1, IC1.8 (VDD), R33.1, U7.2 (OUT)
3V3_FTDI: U15.17 (3V3OUT), U15.19 (RESET)
5V_D: C4.1, C10.1, IC3.4 (COLLECTOR), ISP1.2 (VCC), J4.1, J5.4, JP6.1, R1.2, R2.2, R4.2, R42.2, R49.1, U3.7 (+VS), U6.2 (VOUT), U7.3 (IN), U10.8 (VDD+), U11.4 (VCC), U11.6 (VCC), U11.18 (AVCC), U15.4 (VCCIO), U15.20 (VCC)
12V_D: PS2.3 (+V), U6.3 (VIN)
230V_GROUND: J3.2
230V_N: J3.3, PS1.4 (AC/N), PS2.1 (AC/L)
230V_P: J3.1, PS1.1 (AC/L), PS2.4 (AC/N)
+3V3: JP1.1, JP1.2, JP4.1, JP5.1, R11.2, R16.1, U1.9 (VDDA), U1.24 (VDD), U1.36 (VDD), U1.48 (VDD), U2.2 (OUT)
+5V: IC2.4 (COLLECTOR), JP3.1, JP7.1, PS1.3 (+V), U2.3 (IN), U9.4 (VDD+)
BOOT0: JP1.4, U1.44 (BOOT0)
BOOT1: JP1.3, U1.20 (PB2)
GND: C5.2 (-), C6.2 (-), C7.2 (-), D1.1 (A_1), D1.3 (A_2), D2.1 (A_1), D2.3 (A_2), IC3.2 (CATHODE), J1.1, J2.1, J8.4 (GND), J8.6 (GND), J8.8 (GND), J8.10 (GND), J8.12 (GND), J8.14 (GND), J8.16 (GND), J8.18 (GND), J8.20 (GND), J10.MH1, J10.MH2, J11.4, J11.MH1, J11.MH2, JP1.5, JP1.6, PS1.2 (-V), Q3.3 (C), Q4.3 (C), R13.1, R19.1, R23.2, R24.2, R27.1, R31.1, R32.2, R45.1, RSHUNT1.1, RSHUNT2.1, S2.1, S2.2, U1.8 (VSSA), U1.23 (VSS), U1.35 (VSS), U1.47 (VSS), U2.1 (GND), U9.11 (VDD-/GND)
GND_BRK: R28.2, R29.2
GND_D: C3.2, C4.2, C8.2, C10.2, IC1.3 (GND), IC2.2 (CATHODE), ISP1.6 (GND), J4.3, J5.1, J12.4, J12.MH1, J12.MH2, PS2.2 (-V), R3.1, R6.1, R34.2, S1.3, S1.4, U3.4 (-VS), U7.1 (GND), U10.4 (VDD-/GND), U11.3 (GND), U11.5 (GND), U11.21 (GND), U15.7 (GND7), U15.18 (GND18), U15.21 (GND21), U15.25 (AGND), U15.26 (TEST)
GND_MOT: J7.2, R20.2, R21.2, RSHUNT1.2
IN_100V_BRAKE: J1.2, J1.3, Q1.3 (S), R38.2
IN_100V_MOTOR: J2.2, J2.3, Q2.3 (S), R36.2
JNTRST: J8.3 (NTRST), R8.1, U1.40 (PB4)
JTCK: J8.9 (TCK), R13.2, U1.37 (PA14)
JTDI: J8.5 (TDI), R9.1, U1.38 (PA15)
JTDO: J8.13 (TDO), R7.1, U1.39 (PB3)
JTMS: J8.7 (TMS), R10.1, U1.34 (PA13)
LOAD_CELL_NEG: J5.3, U3.2 (-IN)
LOAD_CELL_POS: J5.2, U3.3 (+IN)
MES_I_BRAKE: R30.1, U1.18 (PB0), U9.14 (OUT4)
MES_I_MOTOR: R22.1, U1.21 (PB10), U9.7 (OUT2)
MES_LOAD_CELL: IC1.5 (AIN1), U3.6 (OUTPUT)
MES_U_BRAKE: R26.1, U1.19 (PB1), U9.8 (OUT3)
MES_U_MOTOR: R18.1, U1.22 (PB11), U9.1 (OUT1)
MISO_ATM: ISP1.1 (MISO), U11.16 (PB4)
MOSI_ATM: ISP1.4 (MOSI), U11.15 (PB3)
unnamed: D1.2 (CC), Q2.2 (D), U4.4
unnamed: R5.1, R6.2
unnamed: R4.1, R5.2, U6.1 (ADJUST)
unnamed: J11.2, R14.2
unnamed: J11.3, JP2.2, R15.2
unnamed: JP2.1, R16.2
unnamed: J6.2, RSHUNT2.2
unnamed: Q2.1 (G), R36.1, R37.2
unnamed: Q3.1 (E), R37.1
unnamed: R17.1, R18.2, U9.2 (IN1-)
unnamed: R19.2, R20.1, U9.3 (IN1+)
unnamed: C9.2, U15.2 (DTR)
unnamed: C8.1, U11.20 (AREF)
unnamed: Q1.1 (G), R38.1, R39.2
unnamed: R21.1, R22.2, U9.6 (IN2-)
unnamed: R23.1, R24.1, U9.5 (IN2+)
unnamed: R27.2, R28.1, U9.10 (IN3+)
unnamed: R25.1, R26.2, U9.9 (IN3-)
unnamed: R29.1, R30.2, U9.13 (IN4-)
unnamed: Q4.1 (E), R39.1
unnamed: R31.2, R32.1, U9.12 (IN4+)
unnamed: J12.2, U15.16 (USBDM)
unnamed: R35.2, U3.1 (-RG)
unnamed: C2.2, C3.1, R33.2, R34.1, U10.3 (IN1+)
unnamed: R35.1, U3.8 (+RG)
unnamed: J12.3, U15.15 (USBDP)
unnamed: D2.2 (CC), Q1.2 (D), U5.4
unnamed: IC2.1 (ANODE), R44.1
unnamed: IC3.1 (ANODE), R46.1
unnamed: J11.1, JP3.2
unnamed: J8.1 (VREF), J8.2 (VTAR), JP5.2
unnamed: JP4.2, R7.2, R8.2, R9.2, R10.2
unnamed: J12.1, JP6.2
unnamed: J9.2, R43.2
unnamed: J9.3, R47.2
unnamed: J9.4, R48.2
unnamed: U1.4 (PC15-OSC32_OUT), Y1.1
unnamed: U1.3 (PC14-OSC32_IN), Y1.2
NRST: J8.15 (RST), R11.1, S2.3, S2.4, U1.7 (NRST)
PWM_BRAKE: Q4.2 (B), U1.17 (PA7)
PWM_MOTOR: Q3.2 (B), U1.16 (PA6)
RST_ATM: C9.1, ISP1.5 (RST), R42.1, S1.1, S1.2, U11.29 (PC6/!RESET)
RX0_ATM: R40.1, U11.30 (PD0)
RX_ATM: IC3.3 (EMITTER), R3.2, U11.10 (PD6)
RX_FTDI: R41.2, U15.5 (RXD)
SCK_ATM: ISP1.3 (SCK), U11.17 (PB5)
SCL: IC1.10 (SCL), R1.1, U11.28 (PC5)
SDA: IC1.9 (SDA), R2.1, U11.27 (PC4)
SPEED_SENSOR_DATA: J4.2, R49.2
STM_MISO: R47.1, U1.27 (PB14)
STM_MOSI: R48.1, U1.28 (PB15)
STM_NSS: J9.1, U1.25 (PB12)
STM_RX: IC2.3 (EMITTER), R45.2, U1.31 (PA10)
STM_SCK: R43.1, U1.26 (PB13)
STM_TX: R46.2, U1.30 (PA9)
TAB: U2.4 (TAB)
TX0_ATM: R41.1, U11.31 (PD1)
TX_ATM: R44.2, U11.9 (PD5)
TX_FTDI: R40.2, U15.1 (TXD)
USBDM: R14.1, U1.32 (PA11)
USBDP: R15.1, U1.33 (PA12)
V_BRK: C7.1 (+), J6.1, R25.2, U5.1
V_MOT: C5.1 (+), C6.1 (+), J7.1, R17.2, U4.1
