GeoffreyBultot/MotorTestBench-PBE/PCB/Motor_TestBenchV2/MotorTestBench/Motor_Test_Bench_ONE_LAYER.brd

## EAGLE design PCB/Motor_TestBenchV2/MotorTestBench/Motor_Test_Bench_ONE_LAYER.brd (continued)

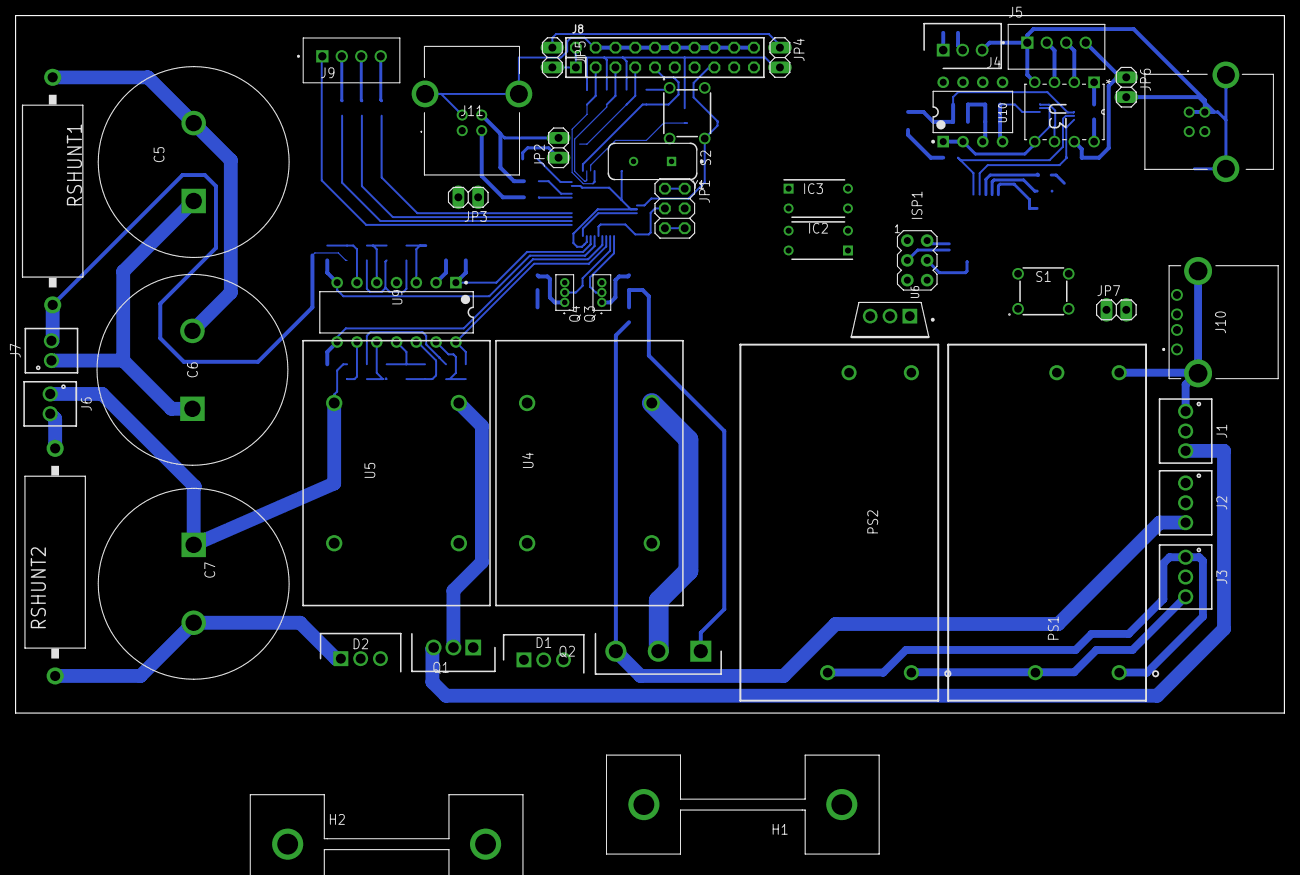
[picture p117: board Motor_Test_Bench_ONE_LAYER.brd from above]

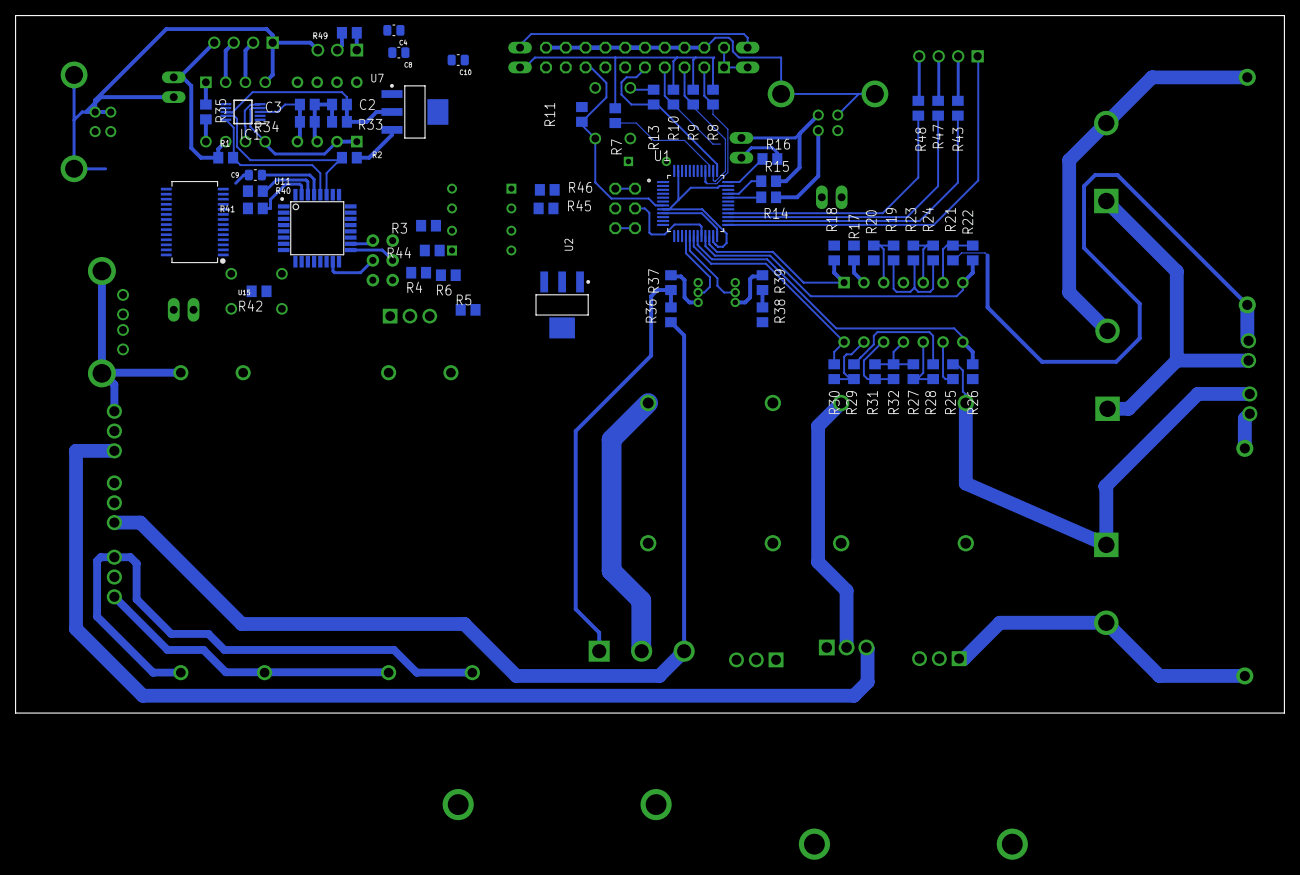
[picture p118: board Motor_Test_Bench_ONE_LAYER.brd from below]

Board: 2 copper layers, 162.9 x 89.5 mm, 106 parts (60 on the bottom side), 93 nets.
