GeoffreyBultot/MotorTestBench-PBE/Codes/Microcontroleur/Stm32CubeMXWorkspace/TestBench_ISIB_UC/TestBench_ISIB_UC.ioc

Mcu.UserName=STM32F103C8Tx
PA0-WKUP.Signal=SharedAnalog_PA0
PA1.Signal=SharedAnalog_PA1
PA10.Signal=USART1_RX
PA11.Signal=USB_DM
PA12.Signal=USB_DP
PA13.Signal=SYS_JTMS-SWDIO
PA14.Signal=SYS_JTCK-SWCLK
PA15.Signal=SYS_JTDI
PA2.Signal=ADCx_IN2
PA3.Signal=ADCx_IN3
PA4.Signal=SPI1_NSS
PA5.Signal=SPI1_SCK
PA6.Signal=SPI1_MISO
PA7.Signal=SPI1_MOSI
PA9.Signal=USART1_TX
PB0.Signal=SharedAnalog_PB0
PB1.Signal=SharedAnalog_PB1
PB11.Signal=GPXTI11
PB3.Signal=SYS_JTDO-TRACESWO
PB4.Signal=SYS_NJTRST
PB6.Signal=I2C1_SCL
PB7.Signal=I2C1_SDA
PB8.Signal=S_TIM4_CH3
PB9.Signal=S_TIM4_CH4
PC14-OSC32_IN.Signal=RCC_OSC32_IN
PC15-OSC32_OUT.Signal=RCC_OSC32_OUT
PD0-OSC_IN.Signal=RCC_OSC_IN
PD1-OSC_OUT.Signal=RCC_OSC_OUT
