GeoffreyBultot/MotorTestBench-PBE/Simulations/Essais_Kivy/Application_V_1_0/Config.txt

[ABSOLUTEMAXRATINGS]
UMotorMax:100
IMotorMax:3
UBrakeMax:90
IBrakeMax:1.5
PMotorMax:300
SpeedMax:1500
CoupleMax:10
[MAIL]
