GeoffreyBultot/MotorTestBench-PBE/(commit log)

2020-06-06 create repos with all part of the project
    [3mmm.csv, AD623.OLB, Ampli_Instru_Premier_Proto.ms14, Changement_Masse.ms14, Circuit_Complet.ms14, Commande_Farnell_Mouser_Bultot_Ibryam.xlsx, Complet_ET_Mesure.ms14, Config.txt]
2020-06-06 add pcb
    [Motor_Test_Bench.brd, Motor_Test_Bench.dxf, Motor_Test_Bench.sch, Motor_Test_Bench_ONE_LAYER.brd, Motor_Test_Bench_ONE_LAYER.pcb, Motor_Test_Bench_ONE_LAYER.sch, PartlistFINAL.csv]
2020-06-09 measures correction & add CAO
    [ARRIERE.SLDPRT, Alim.SLDPRT, Assemblage1.SLDASM, Assemblage2.SLDASM, AssemblageBoitierElectronique.SLDASM, AttachePar3_30X30.AMF, AttachePar3_30X30.SLDPRT, Avant.SLDPRT]
