GeoffreyBultot/MotorTestBench-PBE/(notices)

Notices in the files:
parts and their libraries:
Wurth_Connectors_WR-TBL Rising Cage Clam: Copyright: Würth Elektronik
luminary-arm: Copyright (C) 2008, Bob Starr
SparkFun-IC-Comms: Licensing: Creative Commons ShareAlike 4.0 International - https://creativecommons.org/licenses/by-sa/4.0
